S-k404/pi5-homelab-rack/01_PRINT_FILES/ONLYSCREWS_HARDWARE_CART.md

# OnlyScrews Hardware Cart: 100% Verified Fasteners & Inserts (1 Nov 2026)

All fasteners and brass heat-set inserts required for the **Pi 5 HomeLab 9U Mini Rack** (both Standard 200 mm and Slim Cargo 140 mm builds), sourced from **[OnlyScrews.in](https://onlyscrews.in/)**.

Buying these directly from OnlyScrews fulfills 100% of the hardware requirement for **₹630**, solving the out-of-stock and mixed-pack issues from Robu (saving ~₹2,300+ vs Robu's oversized bulk packs).

---

## 🛒 1-Click Shopify Cart Link

Click this link in your browser to preload all 8 items directly into your OnlyScrews cart:
🔗 **[Load OnlyScrews Cart Automatically](https://onlyscrews.in/cart/49423426126137:50,51684594909497:25,48622988099897:50,48883899105593:20,48591239774521:20,48591235580217:10,48623052194105:10,49979817394489:10)**

---

## 📋 Itemized Procurement Manifest

| # | Item Name | Product Page Link | Variant ID | Unit Price | Req. | Buy Qty | Total Price | Application in Rack |
|---|---|---|:---:|:---:|:---:|:---:|:---:|---|
| **1** | **M5 × 8 mm Brass Threaded Inserts** (Dia. 5mm, Length 8mm, OD 6.4mm) | [View Product](https://onlyscrews.in/products/m5-x-8mm-brass-threaded-inserts) | `49423426126137` | ₹2.80 | 48 | **50** | **₹140.00** | Frame module joints (18), 1U top ribs (4), cap handle bosses (4), base bars (6), front rail equipment holes (16). |
| **2** | **M3 × 6 mm Brass Threaded Inserts** (Dia. 3mm, Length 6mm, OD 4.0–4.4mm) | [View Product](https://onlyscrews.in/products/m3-x-6mm-3d-printing-brass-threaded-inserts-dia-3mm-length-6mm) | `51684594909497` | ₹4.80 | 18 | **25** | **₹120.00** | B1 dock ears (4), 7" screen ears (4) & corner clips (4), Pi shelf front posts (6). |
| **3** | **M5 × 12 mm Hex Button Head Screws** (ISO 7380, SS 304) | [View Product](https://onlyscrews.in/products/hex-allen-button-head-m5-x-12-screw-pack-of-20) | `48622988099897` | ₹3.40 | 48 | **50** | **₹170.00** | 18 frame joints, 6 base tie rods, 4 top cap, 4 luggage handles, 16 unit ear mounts. |
| **4** | **M5 Plain Flat Washers** (DIN 125, SS 304) | [View Product](https://onlyscrews.in/products/m5-washer-ss304) | `48883899105593` | ₹1.20 | 16 | **20** | **₹24.00** | Under the 16 unit ear mounting screws to protect 3D prints from crushing. |
| **5** | **M3 × 8 mm Countersunk Screws** (DIN 7991, SS 304) | [View Product](https://onlyscrews.in/products/hex-allen-csk-m3-x-8-screw-pack-of-20) | `48591239774521` | ₹1.40 | 14 | **20** | **₹28.00** | 4 B1 dock ears, 4 screen ears, 6 Pi faceplate. (*Out of stock on Robu; flush mount mandatory*). |
| **6** | **M3 × 12 mm Countersunk Screws** (DIN 7991, SS 304) | [View Product](https://onlyscrews.in/products/hex-allen-csk-m3-x-10-screw-pack-of-20) | `48591235580217` | ₹1.80 | 3 | **10** | **₹18.00** | Poly+ 5 tray to UPS tray (self-threads into 2.5 mm pilot holes). |
| **7** | **M3 × 8 mm Hex Button Head Screws** (ISO 7380, SS 304) | [View Product](https://onlyscrews.in/products/hex-allen-button-head-m3-x-8-screw-pack-of-20) | `48623052194105` | ₹2.00 | 4 | **10** | **₹20.00** | Clamps 4 corner retention clips onto Waveshare 7" screen tabs. |
| **8** | **M2.5 × 25 mm Hex Socket Head Screws** (High Tensile 12.9 Black) | [View Product](https://onlyscrews.in/products/m2-5-x-25mm-hex-allen-socket-head-high-tensile12-9-black-oxide-screw-dia-2-5mm-length-25mm) | `49979817394489` | ₹11.00 | 4 | **10** | **₹110.00** | Waveshare Adapter (F) holder lid + board onto posts (conditional on fit test). |

**Total OnlyScrews Hardware Cost:** **₹630.00** (incl. all spares).

---

### Optional Addition (If building the 1U 0.91" OLED display mod instead of UCG-Ultra):
* **M2 × 8 mm Socket Head Screws (SS 304)**: [View Product](https://onlyscrews.in/products/m2-x-8mm-hex-allen-socket-head-ss-304-screw-dia-2mm-length-8mm) (`₹2.60` each, buy 10 pcs = ₹26.00). Used to fasten the rear OLED retention clamp to the printed faceplate.
