S-k404/pi5-homelab-rack/ULTRAREVIEW/before/01_PRINT_FILES/ROBU_HARDWARE_CART_TO_RESTORE.md

# Robu hardware cart: to re-add after the print order is checked out (27 Oct 2026)

The Robu cart was cleared so the 3D-printing-service jobs could go in (Robu won't mix print jobs with regular items). Re-add this list once the print order has been checked out.

Prices are Robu's, incl. GST, as of 27 Oct 2026. Search on robu.in with the text in the "Search" column.

| Qty | Item | Unit ₹ | Search |
|---|---|---|---|
| 2 | Sunlu APLA (AntiString PLA) Grey 1.75mm Filament, 1 kg | 899 | `sunlu apla grey 1.75mm` |
| 1 | Pro-Range Hyper PETG Filament 1.75 mm 1kg Spool, Grey | 1,068 | `pro-range hyper petg grey` |
| 1 | Brass Heat Set Insert Nut Hot Melt Knurled Threaded M5-M6 90PCS (not the "Kit" one) | 959 | `brass heat set insert m5-m6 90pcs` |
| 3 | EasyMech M5x12mm HT Socket Button Head Cap Allen Bolt (25Pcs) | 167 | `easymech m5x12mm ht socket button head` |
| 1 | EasyMech M5 MS Plain Washer (100Pcs) | 89 | `easymech m5 ms plain washer 100pcs` |
| 1 | EasyMech M3x8mm HT Socket Button Head Cap Allen Bolt (25Pcs) | 239 | `easymech m3x8mm ht socket button head` |
| 1 | Brass Heat Set Insert Nut M2-M2.5-M3 500PCS (check insert length: need ~5-6 mm for a Ø4 hole) | 1,129 | `brass heat set insert m2 m2.5 m3 500pcs` |
| 1 | Standard 12V 5A 60W Power Supply with 5.5mm DC Plug (confirm 2.1 mm pin + centre-positive) | 425 | `standard 12v 5a 60w power supply 5.5mm dc plug` |
| 1 | USB-A to Micro USB-B Cable 100cm Fast Data/Charge | 59 | `usb-a to micro usb-b cable 100cm` |
| 1 | SanDisk Ultra GO micro SDHC 32GB UHS-I | 1,629 | `sandisk ultra go micro sdhc 32gb` |
| 1 | Waveshare 7inch 1024x600 HDMI, IPS, Low Power Capacitive LCD (C) Touch Screen (not the "with Bicolor Case" one) | 4,389 | `waveshare 7inch hdmi lcd c` |
| 1 | Cuzor Mini UPS Pro 12V3A (3x2900 mAh); went missing from the cart on its own, re-add | 2,199 | `cuzor mini ups` |
| 1 | Nylon Cable Zip Ties 150mm White (Pack of 100); went missing from the cart on its own, re-add | 80 | `nylon cable zip ties 150mm` |

Total of the 13 lines above: ₹15,083. (Was 14 lines / ₹15,942 before the Argon Poly+ 5: the Armor Lite V5 was dropped because the THRML heatsink/fan is inside the Poly+ 5.)

## Added for the Argon Poly+ 5 (27 Oct): not yet in any cart
- **12 V → 5 V, 5 A USB-C step-down converter** (UPS 12 V OUT → pigtail → converter → Pi USB-C). Not confirmed on Robu. Leads: "24V/12V to 5V 5A Power Module DC-DC XY-3606" (₹139) and "DC-DC Step-Down Buck Converter 24V 12V 9V to 5V 5A 25W" (₹199); neither listing says it has a USB-C output, so check before buying.
- **4 × M2.5 × 25 mm pan-head screws** for the Waveshare adapter (F) holder (its base and lid are in the print cart). Not searched on Robu yet; look for an M2.5 × 25 kit or pack, and check it has pan/button heads (not countersunk). The holder's pilot holes are 2.1 mm, so the screws cut their own thread.
- **UGREEN 20134 micro-HDMI extender**: Amazon only; now required (it was optional).
- The microSD (above) is now the boot drive: the adapter (F) can't be used inside the Argon case, so there is no NVMe.

## Not included on purpose
- Official Raspberry Pi 5 Active Cooler (₹519) and 52Pi Armor Lite V5 (₹859): neither is needed now, because the user bought the Argon Poly+ 5 with the THRML heatsink/fan inside.
- If Robu prints every part, the 2 PLA + 1 PETG spools aren't needed.

## Not on Robu (not in any cart)
UCG-Ultra (Amazon B0D8PSW2BZ), 0.5 m Cat6 patch cable, M3 x 8 countersunk screws (all out of stock), Pi-unit extras (M3x12 CSK x3, M2.5x8 x4, M2.5x10 x4), rubber feet, 1 mm foam tape, felt sheet, 0.5 m USB-C cable for the B1, 2230 NVMe SSD.
