S-k404/pi5-homelab-rack/START_HERE.md

# Pi 5 HomeLab: start here (28 Oct 2026)

**The to-do list is now `FINAL_TODO/FINAL_TODO.md`**: orders, what to measure when things arrive, printing, building, every cable, first power-up. It replaces the list that was here, so there's only one list to keep up to date. The old one is in `ULTRAREVIEW/before/START_HERE.md`.

| What | Where |
|---|---|
| To-do list | `FINAL_TODO/FINAL_TODO.md` |
| Print / order list | `01_PRINT_FILES/README.md` (print only from `01_PRINT_FILES/`) |
| Buy list with prices | `PARTS_LIST.md` |
| Folder map and the build | `README.md` |
| What the 28 Oct review found and changed | `ULTRAREVIEW/README.md` |

The build:
- the 9U rack
- B1 dock v5
- the 7" screen module
- the Pi 5 in the **Argon Poly+ 5** with the adapter (F) holder (fit test first)
- the **12-ALT2** UCG-Ultra mount
- the 12 V brick cradle (plate 13)
- the **clean** faceplate (no DC-IN window, no notch: the brick's lead stays behind it)

Everything older (including the broken "hidden-slit / switch" faceplate) is in `_Old_versions/`.
