S-k404/pi5-homelab-rack/05_PLATES_250x250_BED/Plate05_SETTINGS.txt

======================================================================
Plate05: Pi Rack Shelf & EP52 UPS Sled (2 Parts)
Bed: 250 x 250 x 250 mm | Material: PETG - Black
Infill & Walls: Shelf: 4w 20% · UPS: 3w 20%
Parts on Bed: 2 pieces (100% verified inside bed margins)
======================================================================

DEBOSSED INTERIOR ONE-WORD PART IDENTIFIERS:
  - Molded Label: SHELF
  - Molded Label: UPS

QUICK-BREAK TREE SUPPORT RECIPE:
  Minimal Tree (0.22 mm Z) on shelf right-post cable notch.

SLICER CONFIGURATION:
  - Layer Height: 0.20 mm Standard
  - Support Type: Tree (auto) / Tree Slim
  - Top Z-Distance: 0.22 mm (Clean manual release)
  - Top Interface: 2 dense layers @ 0.8 mm spacing
  - Overhang Threshold: 55°
  - XY Separation: 0.60 mm
