S-k404/pi5-homelab-rack/05_PLATES_250x250_BED/Plate07_SETTINGS.txt

======================================================================
Plate07: Pi 2U Clean Faceplate (45° Diagonal Flat)
Bed: 250 x 250 x 250 mm | Material: PETG - Black
Infill & Walls: 4 walls · 20% Gyroid infill
Parts on Bed: 1 pieces (100% verified inside bed margins)
======================================================================

DEBOSSED INTERIOR ONE-WORD PART IDENTIFIERS:
  - Molded Label: FACEPLATE

QUICK-BREAK TREE SUPPORT RECIPE:
  Supports OFF (Face-Down on PEI Bed for Molded Finish)

SLICER CONFIGURATION:
  - Layer Height: 0.20 mm Standard
  - Support Type: Tree (auto) / Tree Slim
  - Top Z-Distance: 0.22 mm (Clean manual release)
  - Top Interface: 2 dense layers @ 0.8 mm spacing
  - Overhang Threshold: 55°
  - XY Separation: 0.60 mm
