S-k404/pi5-homelab-rack/05_PLATES_250x250_BED/Plate10_SETTINGS.txt

======================================================================
Plate10: 3U Unit Rack Mount Ears (4 Parts)
Bed: 250 x 250 x 250 mm | Material: PLA - Silver
Infill & Walls: 4 walls · 20% Gyroid infill
Parts on Bed: 4 pieces (100% verified inside bed margins)
======================================================================

DEBOSSED INTERIOR ONE-WORD PART IDENTIFIERS:
  - Molded Label: EAR (1/4)
  - Molded Label: EAR (2/4)
  - Molded Label: EAR (3/4)
  - Molded Label: EAR (4/4)

QUICK-BREAK TREE SUPPORT RECIPE:
  Supports OFF (Zero Supports · 100% Flat Geometry)

SLICER CONFIGURATION:
  - Layer Height: 0.20 mm Standard
  - Support Type: Tree (auto) / Tree Slim
  - Top Z-Distance: 0.20 mm
  - Top Interface: 2 dense layers @ 0.8 mm spacing
  - Overhang Threshold: 55°
  - XY Separation: 0.50 mm
