S-k404/pi5-homelab-rack/06_WALL_FRAME_Waveshare_F/checks/CLEARANCE_SCHEMATIC.pdf

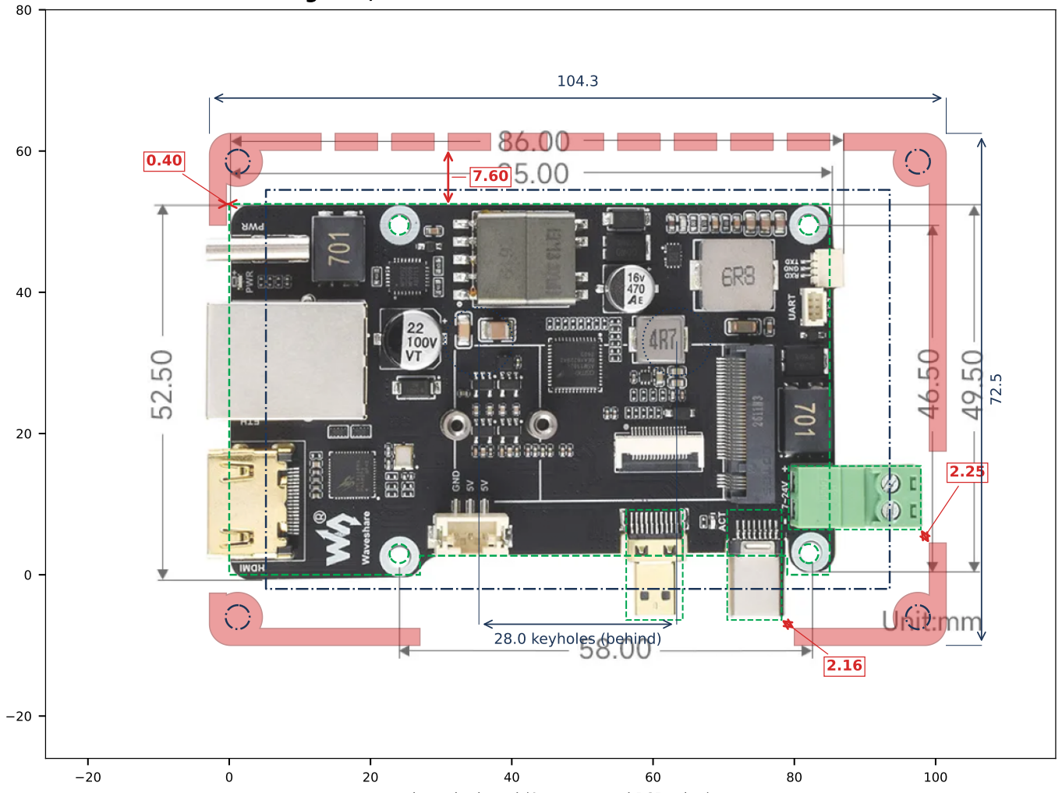
[picture p13: figure]
28.0 keyholes (behind)

x along the board (0 = ports-end PCB edge) y up the wall (0 = plug edge)

A Front: frame cut at z 14.1 (red) over Waveshare's drawing; model board dashed green, front window dash-dot

−40 | −20 | 0 | 20 | 40 | 60 | 80 | 100

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
z out of the wall (0 = wall)

1.50

2.00

14.10

1.03

B Section y = 30.2: RJ45, left keyhole boss

−40 | −20 | 0 | 20 | 40 | 60 | 80 | 100 | 120

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
z out of the wall

2.86
4.41
| | 3.00
| 3.00

8.50

C Section y = 10.9: HDMI jack, 7-24 V terminal

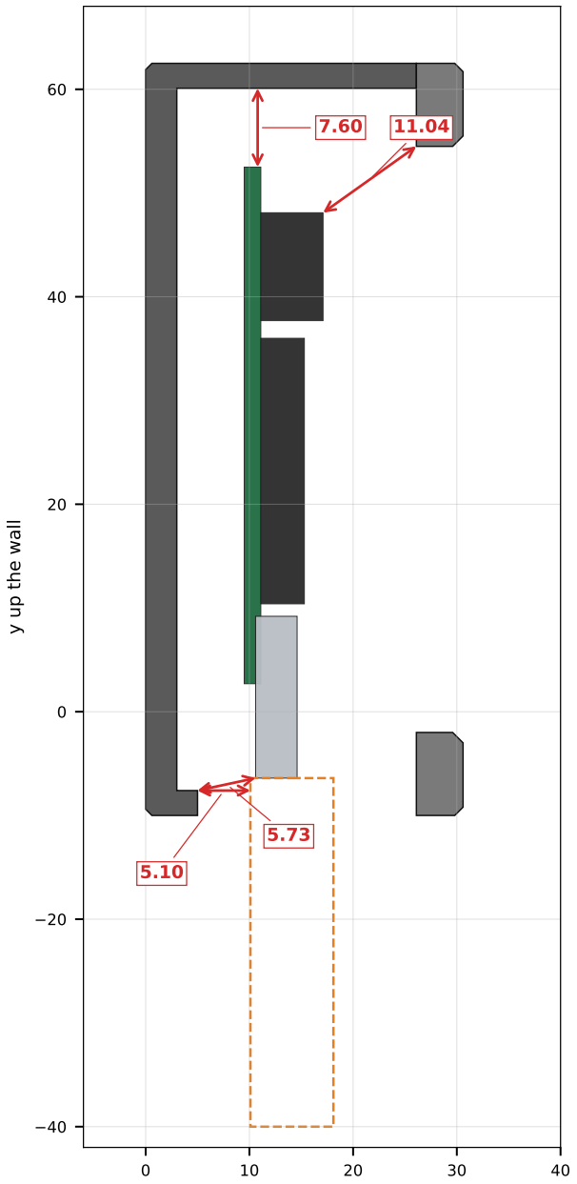
[picture p14: figure]
y up the wall

z out of the wall (0 = wall)

D Section x = 74.35: USB-C plug, bottom slot, top wall

E Section x = 35.4: left keyhole, wall screw head 3 mm out

F Section x = 97.5: right-hand front screws, terminal

Waveshare Pi5 Connector Adapter (F) wall frame: clearances measured on the delivered STEP files (mm; red = gap, orange dashed = cable plug / lead space, blue = screws, hatched = estimated pin tails)

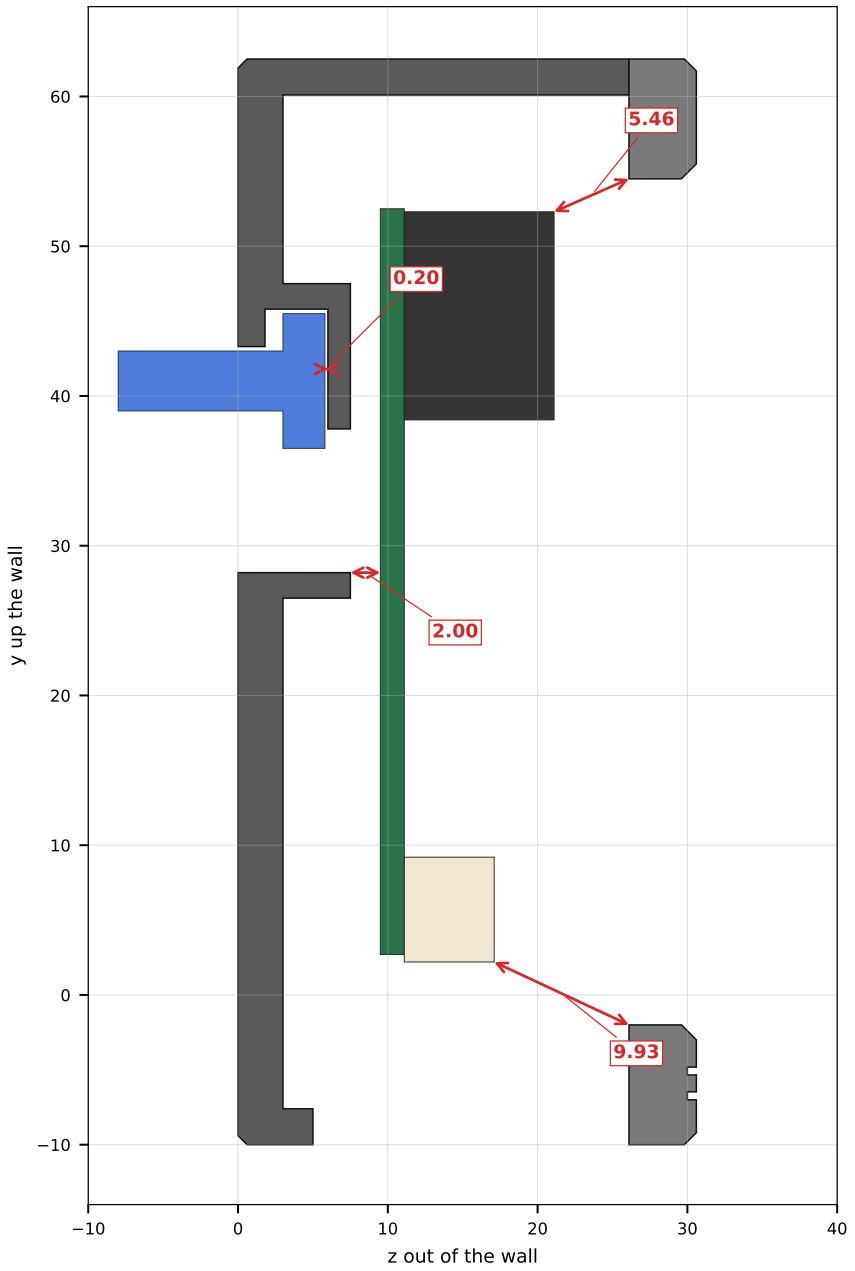
[picture p15: figure]
z out of the wall; y up the wall
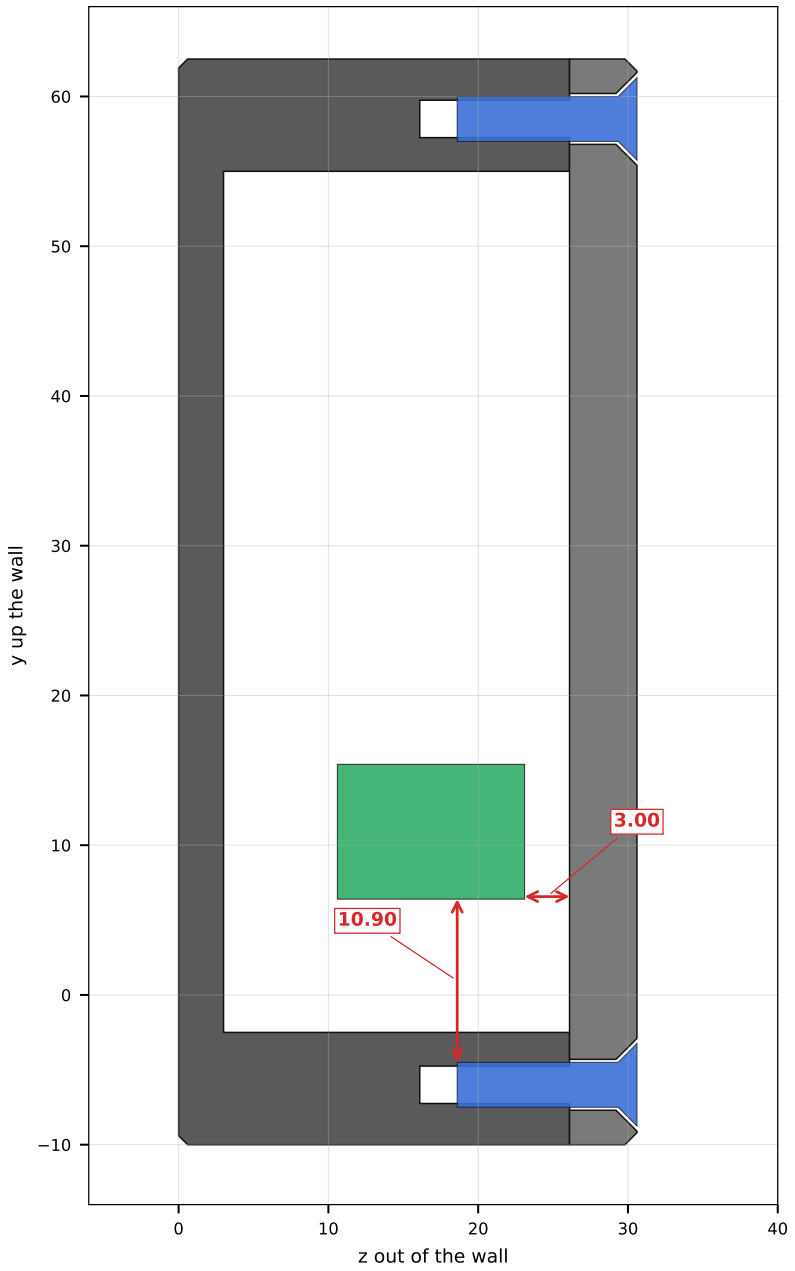
[picture p16: figure]
z out of the wall; y up the wall

Sections are cut through the delivered STEP files (read back from disk) and the adapter model; red arrows measure within each section, the table gives the 3D minimum. Board positions from Waveshare's drawing (+-0.3 mm); parts marked est. have estimated heights. Full numbers: CLEARANCES_from_STEP.txt.
