S-k404/pi5-homelab-rack/_Old_versions/README.md

# Old versions: don't print from these

These are kept for reference only. The current design is `../Pi5-MiniRack_v7.2_ALL-FILES_2026-10-27/`.

| Folder | What it is |
|---|---|
| `v7.1_2026-10-27/` | The 8U v7.1 bundle and zip (no UCG-Ultra shelf). Its BOM still lists the Mean Well LRS-150-12. |
| `v7.0_2026-10-27/` | The v7.0 bundle and zip. Its screen module doesn't fit the C-type screen, and its rack is heavier than v7.1's. |
| `Display7C_3U_screen-module_2026-10-27/` | The C-type screen module on its own. The same module is `3_Display_7in_3U/` in v7.1 and v7.2; this copy's rack check is the v7.0 run. |
| `2026-10-26_and_earlier/` | The v6 rack, the 26 Oct all-files zip, the first REES52 screen and B1 dock zips, the 26 Oct BOM, and the old START_HERE notes. |

- `FINAL_PRINT_STLs_ONLY_antigravity_2026-10-28_DO-NOT-PRINT/` (moved 28 Oct): the Antigravity "v7.3" STL list. Wrong build and a broken faceplate; see its `00_DO_NOT_PRINT_README.txt`. The print list is `../FINAL_PRINTS_2026-10-28/`.

## `2026-10-28_retired/` (moved here 28 Oct 2026, when the top level was reorganised)
The current files are now in the project root: `01_PRINT_FILES/`, `02_RENDERS/`, `03_CHECKS/`, `04_DESIGN_SOURCE/`. **Don't print from anything below.**
| Folder / file | What it was |
|---|---|
| `PRINT_THIS/` | The 27 Oct per-plate print folder, with its alternatives, the plate 13 source and checks, the Robu notes and the handoff. The broken Antigravity faceplate and switch extender are in its `_superseded_and_alternatives/BROKEN_…/` |
| `FINAL_PRINTS_2026-10-28_replaced-by-01_PRINT_FILES/` | The first final folder of 28 Oct, before the holder and UPS-check split |
| `antigravity_finalisation/` | The "Antigravity v7.3" bundle: CAD copies, its renders, docs and BOM. Its faceplate / switch extender / "hidden slit" don't work |
| `FINAL_PRINT_STLs_ONLY_antigravity_DO-NOT-PRINT/`, `…first-copy…/` | Antigravity's STL lists (broken faceplate, plate 12, shims) |
| `Pi 5 Mini Rack Renders_antigravity_WRONG-faceplate/` | Antigravity's renders (switch-window faceplate, UPS moved 29.9 mm forward) |
| `BOM_Pi5-MiniRack_FINAL_antigravity_wrong-Poly5-price.xlsx` | Antigravity's BOM (Poly+ 5 at ₹859, tray height wrong, no totals). The corrected buy list is `../../PARTS_LIST.md` |
