S-k404/pi5-homelab-rack/_Old_versions/rework-01/_Old_versions/v7.0_2026-10-27/Pi5-MiniRack_v7_ALL-FILES_2026-10-27/1_Rack_8U_T0-look/README.md

# Printable 10-inch 8U Mini Rack — RackMate T0 look (v7)

This rack copies the **DeskPi RackMate T0** that Jeff Geerling used for **Mini Rack 001 and 002**:
- a 280 × 200 mm footprint
- solid silver side walls, with the rails built into the front and rear posts
- a top cap with a punched-style vent grid
- two U handles, front to back, with a round eye in each leg
- feet at the four corners

It's 8U tall, like DeskPi's RackMate T1, so it holds all three of your units. From bottom to top: the **Pi unit (2U)**, the **B1 face-out dock (3U)** and the **7" screen (3U)**.

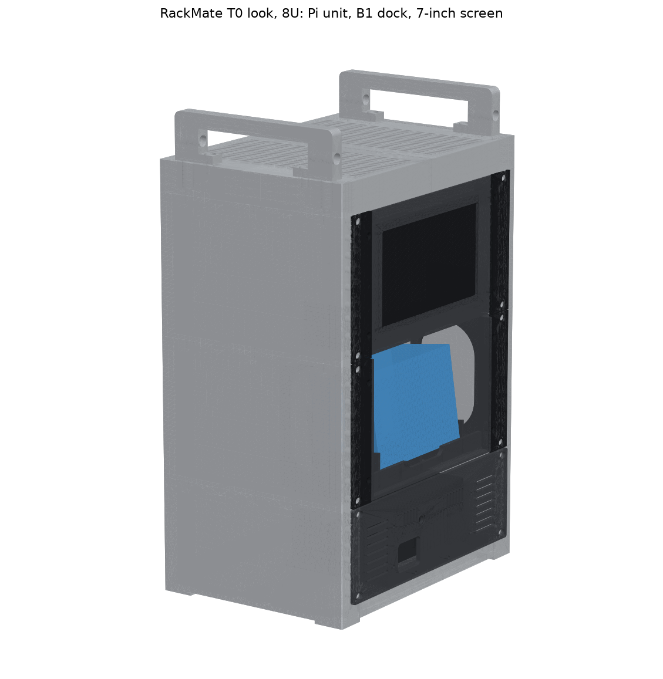
[picture p19: _Old_versions/v7.0_2026-10-27/Pi5-MiniRack_v7_ALL-FILES_2026-10-27/1_Rack_8U_T0-look/images/rack_loaded.png]
Loaded

Front
Empty

**Size:** 280 W × 200 D mm. It's 406 mm tall to the top of the cap and 451 mm to the handle tops.
**Rails:** 10-inch standard: holes 236.525 mm apart, 224 mm clear between the posts, 24 EIA holes per post. There are rails at the front and the rear, so a 10" PDU fits at the back as in Mini Rack 002.

## What changed from v6 (and why)
| v6 problem | v7 |
|---|---|
| It tipped back with ~6 N on the B1 button. The check script used a pivot that doesn't touch the desk. | It stands on four corner feet 200 mm apart (front to back). It now takes **~18 N** at the B1 button or **~11 N** at the screen to tip it. |
| It was 129 mm deep, a slim tower. | 200 mm deep, like the T0. Commercial 10" gear such as switches fits too. |
| There was nowhere to stick the rubber feet: the base was a 3 mm web. | Each corner has a 28 × 30 mm foot pad. |
| 28 printed parts including 1.4 mm stick-on panels, 68 heat-set inserts, countersunk screws. | 13 printed parts, 38 M5 inserts and **one screw size** (M5 × 12 button head). The walls are part of the side modules. |
| The Pi shelf's rubber feet clashed with the base bars. | The shelf sits on two base bars, and its feet (optional) hang clear in the plinth. |

## How it's built
- **Side modules:** each one is a single print. It has the 1.6 mm wall, the front and rear posts with the rails, and a rib along the top and bottom. Each side stacks one 2U base and two 3U modules. The 3U middle and 3U top are the same part.
  - At each joint, three M5 screws go down through the upper module's bottom rib into inserts in the lower module's top rib.
  - Two keys drop into pockets so the walls line up flush.
- **Base:** the 2U base modules carry on 20 mm below the rack space down to the desk. They have the corner foot pads and ledges for three base bars.
  - The bars (front, middle and rear) tie the two sides together.
  - The Pi unit's shelf rests on the front and middle bars.
  - Each bar has two screws, fitted from below.
- **Cap:** two halves locked together at the centre by dovetails. It sits on the top modules, with two screws per side going down through the corner columns.
- **Handles:** each foot tab takes one screw into an insert in a cap column.
- **Left and right:** every part is front/rear symmetric. The left-hand part is the right-hand one turned 180°, so you print one STL per part type.

Exploded

## Print list
PETG (silver or grey for the T0 look), 0.2 mm layers, **no supports**. The STLs are already laid out on the bed. Everything fits a 220 × 220 mm bed.

| File (`STL_for_printing/`) | Qty | On the bed (mm) | Settings | ≈ g each |
|---|---|---|---|---|
| `Rack_SideModule_2U_Base_x2.stl` | 2 | 200 × 109 × 40, outer face down | 3 walls, 15% | 106 |
| `Rack_SideModule_3U_x4.stl` | 4 | 200 × 136 × 28, outer face down | 3 walls, 15% | 120 |
| `Rack_CapHalf_x2.stl` | 2 | 148 × 200 × 30, vent grid down | 3 walls, 15% | 112 |
| `Rack_Handle_x2.stl` | 2 | 172 × 45 × 14, on its side | 4 walls, 30% | 41 |
| `Rack_BaseBar_x3.stl` | 3 | 224 long, laid diagonally | 3 walls, 25% | 25 |

**Rack total ≈ 1.07 kg** (slicer-like estimate from `source/estimate_filament.py`; your slicer gives exact numbers).

**Tips:**
- Print the side modules and the cap on a smooth or textured PEI sheet. Their outside faces print against the bed, which gives the clean T0 finish.
- For the T0's two-tone look, print the cap halves in black or dark grey.
- The outer front and rear edges have a 1 mm chamfer, so elephant's foot won't show.
- Print one 3U module first. Check that an M5 insert sets cleanly in a rail hole and in a joint boss.

## Hardware (rack)
| Item | Qty | Where |
|---|---|---|
| M5 heat-set inserts, Ø6.4 hole, 8–10 mm long | 38 (buy 50) | 12 joint bosses + 4 cap bosses (top ribs), 4 cap columns, 6 base-bar ends, 12 rail holes (Pi, dock, screen) |
| M5 × 12 button-head screws | 38 | 12 module joints, 4 cap, 6 base bars, 4 handles, 12 unit ears |
| M5 washers | 12 (buy 16) | under the unit-ear screws |
| Stick-on rubber feet, 10–15 mm | 4 | under the corner foot pads |

A 3 mm hex L-key reaches every screw. The joint screws sit inside the modules, and the handle screws sit under the grip.

## Assembly
1. **Inserts:** press them into:
   - the top-rib bosses of every module: 3 each in the 2U bases and the middle 3Us, 2 each (front and rear) in the top 3Us
   - the cap columns (2 per half)
   - both ends of each base bar (from below)
   - the rail holes you need: 4 per unit
2. **Sides:** for each side, stack the 2U base, a 3U and a 3U. Let the keys drop into the pockets, then fit 3 screws per joint down through the upper module's bottom rib.
3. **Base:** lay the rack on its back. Set the three bars on the ledges (front, middle and rear) and screw each end from below through the ledge.
4. **Cap:** lower one cap half onto the other so the dovetails lock. Set the cap on the top modules and fit 4 screws down through the corner columns.
5. **Handles:** 1 screw per foot tab, into the cap columns. These cover the cap screws.
6. **Feet:** stick the rubber feet under the four corner pads.
7. **Units:** rack them from the bottom up: Pi unit, B1 dock, screen. Each takes 4 M5 × 12 screws with washers.

## Check by hand
- **Cables:** the back is open. The Pi's ports are about 85 mm in from the rear rail plane. Run the screen's HDMI and USB up the back.
- **Heat:** the walls are closed. Air comes in under the base (the bottom is open, with a 20 mm plinth) and through the open back, and it leaves through the vent grid in the cap.
- **Label:** like Jeff's racks, print a "001" label on the B1 and stick it on the cap's front band.

## Checks
`VERIFICATION_rack.txt` has **34 PASS, 0 FAIL**. It covers:
- no collisions, using the real Pi unit loaded from its STEP files, plus the dock and the screen
- every screw line clear into its insert
- the keys engaging
- the EIA holes and the 10" standard
- unit slots on the inserts
- wall thickness around the inserts
- bed fit
- tipping
- carrying by one handle
- loads on the cap and base bars

These are calculations on the 3D models and hand calcs, not a physical test.

## Source
`source/` holds the CadQuery scripts (`pip install cadquery trimesh scipy pillow matplotlib`):
- `rack_t0.py`: all the rack parts. The dimensions are at the top.
- `export_rack.py <Pi STEP folder> <out folder>`: writes the STLs, STEPs and images. The Pi STEP folder is `../4_Pi_Unit_2U/STEP_for_Onshape`.
- `verify_rack_t0.py <Pi STEP folder> <STL folder>`: re-runs the checks.
- `estimate_filament.py <STL folder>`: grams per part.
