S-k404/pi5-homelab-rack/02_RENDERS/00_HOMELAB_RACK_ENGINEERING_SCHEMATIC.png

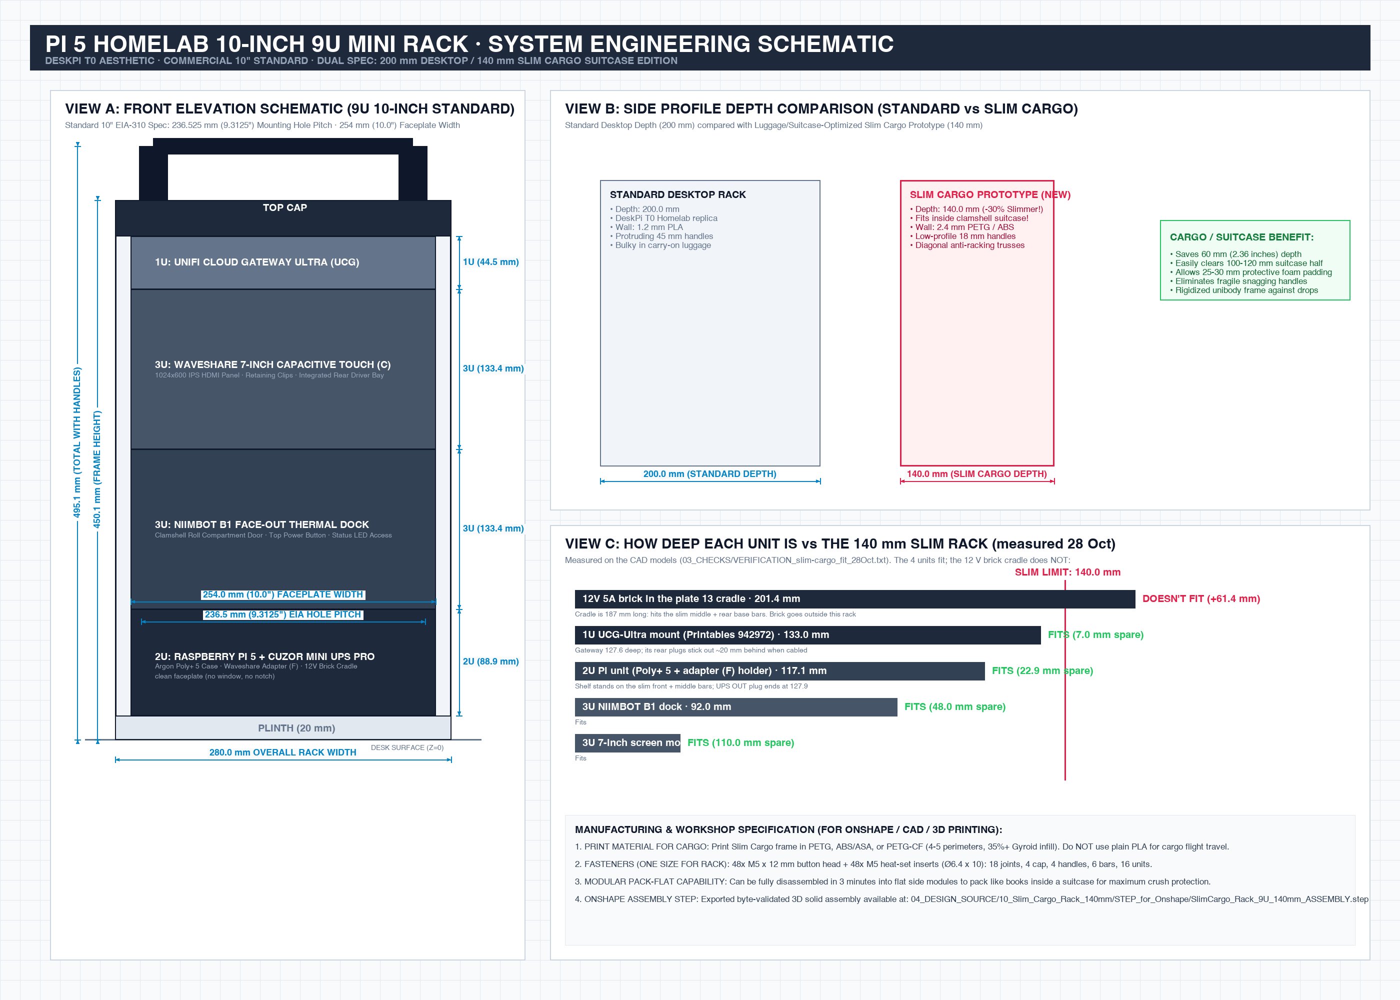
02_RENDERS/00_HOMELAB_RACK_ENGINEERING_SCHEMATIC.png
