S-k404/pi5-homelab-rack/02_RENDERS/01_rack_loaded_front.png

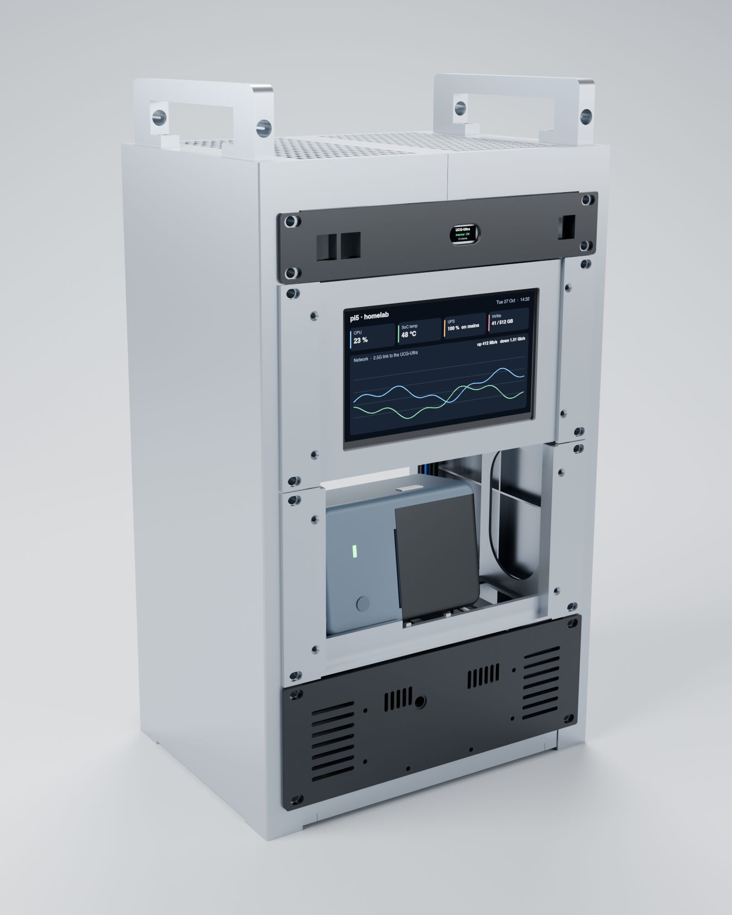
02_RENDERS/01_rack_loaded_front.png
