S-k404/pi5-homelab-rack/02_RENDERS/02_rack_loaded_back.png

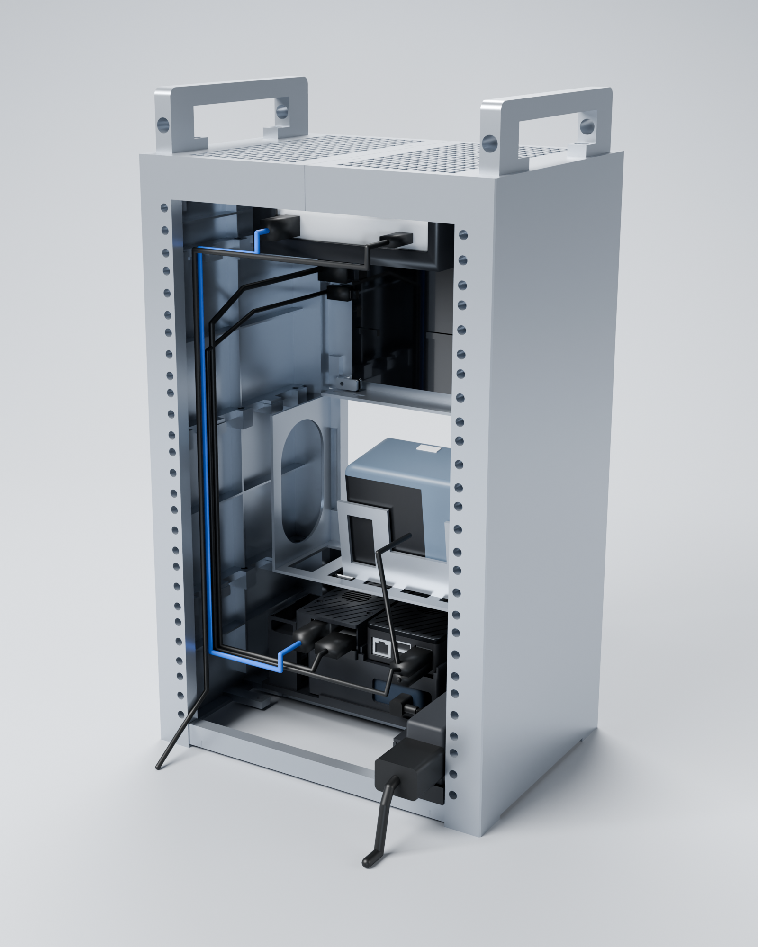
02_RENDERS/02_rack_loaded_back.png
