S-k404/pi5-homelab-rack/02_RENDERS/03_rack_front_straight.png

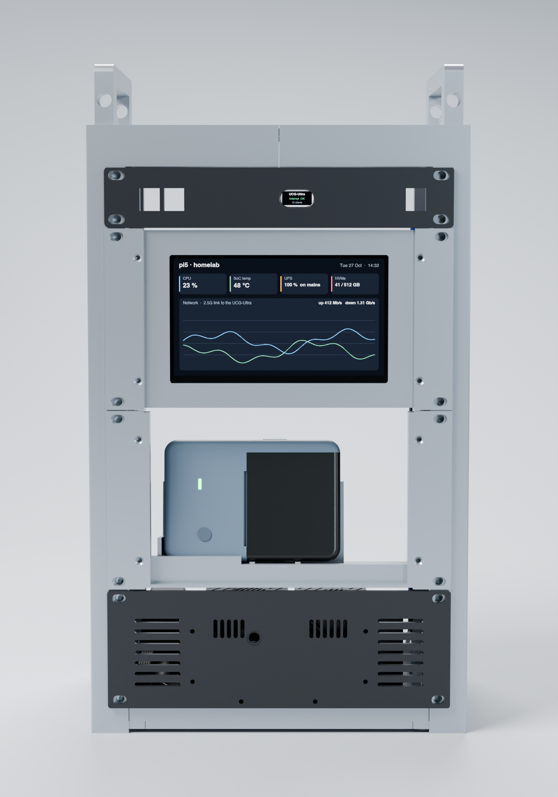
02_RENDERS/03_rack_front_straight.png
