S-k404/pi5-homelab-rack/02_RENDERS/04_rack_exploded.png

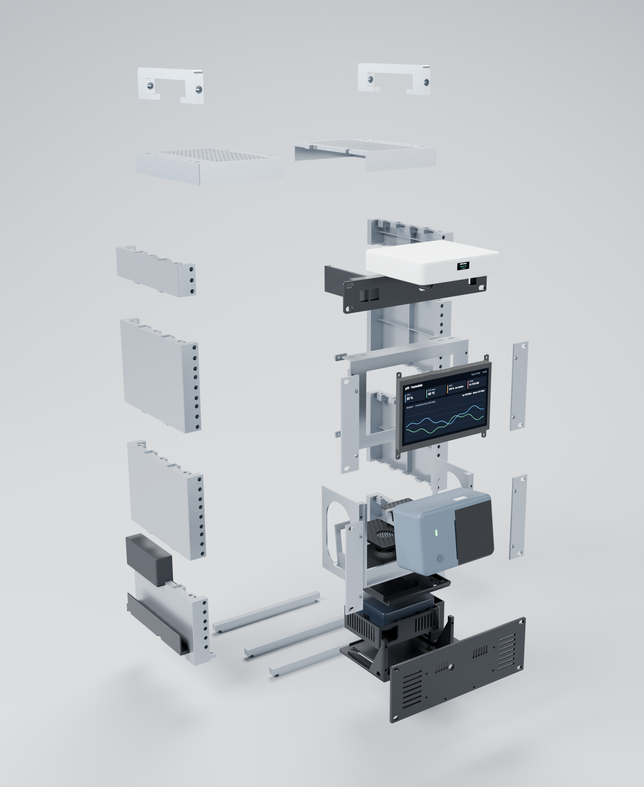
02_RENDERS/04_rack_exploded.png
