S-k404/pi5-homelab-rack/02_RENDERS/05_pi_unit.png

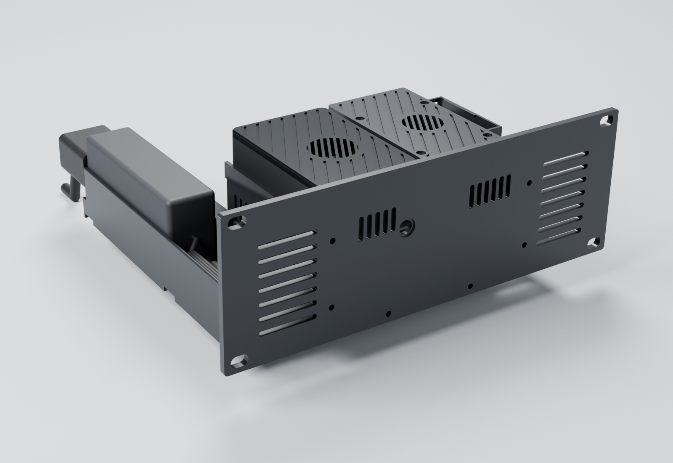
02_RENDERS/05_pi_unit.png
