S-k404/pi5-homelab-rack/02_RENDERS/06_pi_unit_back_ports.png

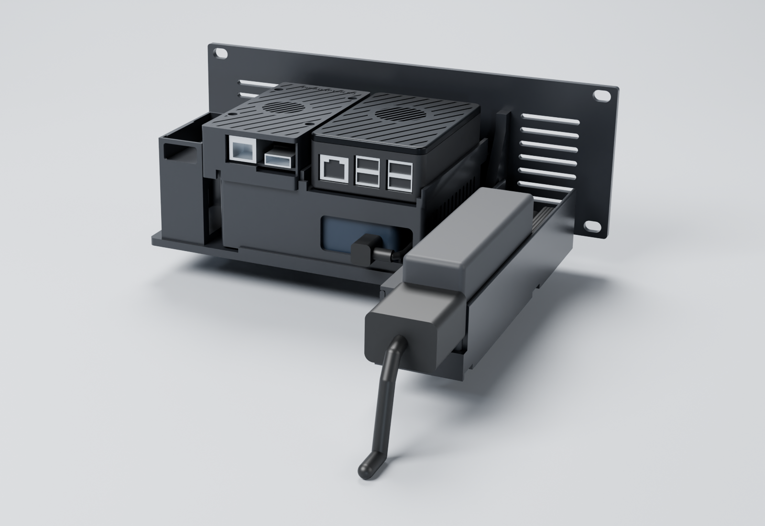
02_RENDERS/06_pi_unit_back_ports.png
