S-k404/pi5-homelab-rack/02_RENDERS/07_pi_unit_exploded.png

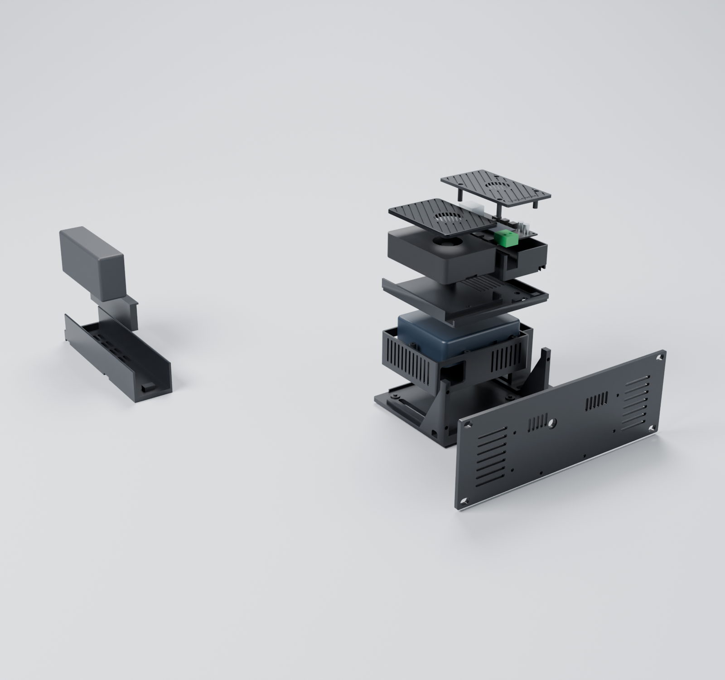
02_RENDERS/07_pi_unit_exploded.png
