S-k404/pi5-homelab-rack/02_RENDERS/08_pi_unit_faceplate_off.png

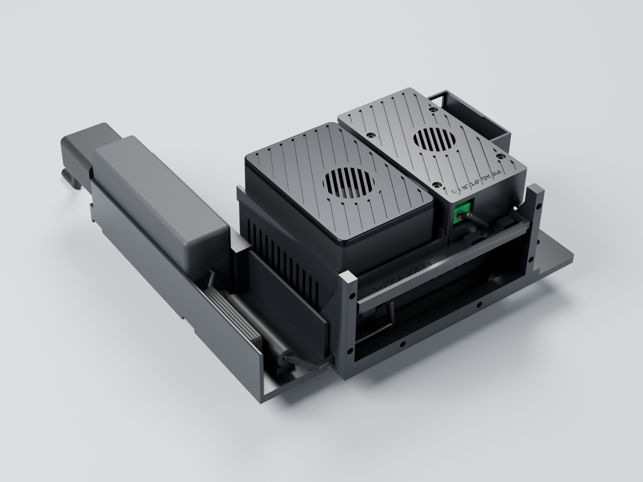
02_RENDERS/08_pi_unit_faceplate_off.png
