S-k404/pi5-homelab-rack/02_RENDERS/09_pi_unit_holder_open.png

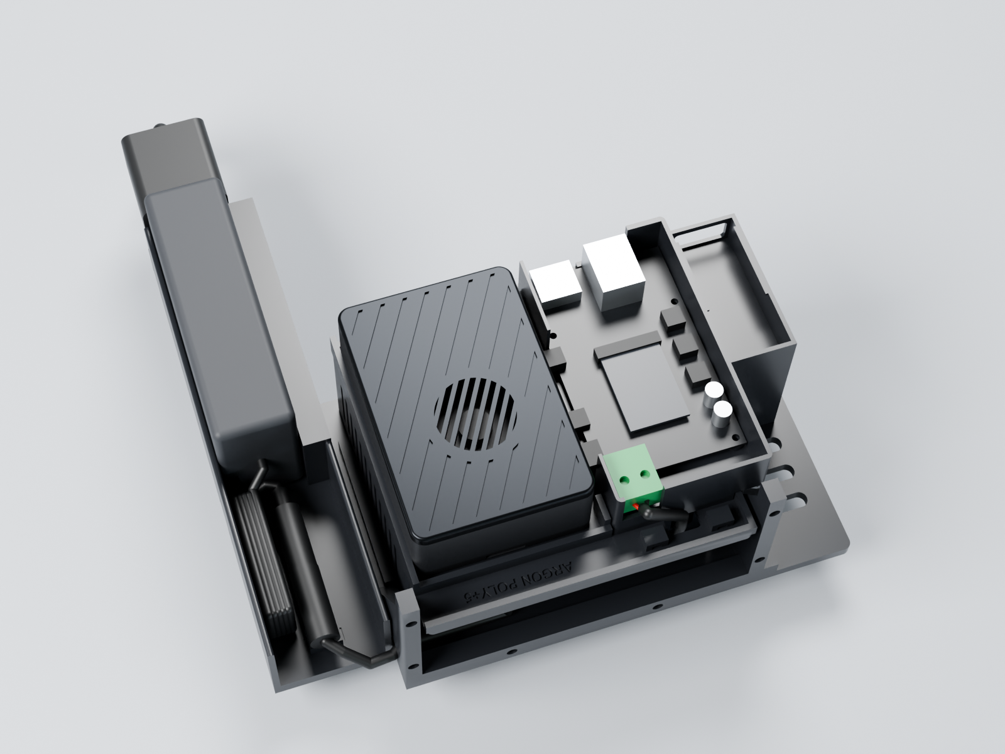
02_RENDERS/09_pi_unit_holder_open.png
