S-k404/pi5-homelab-rack/02_RENDERS/10_b1_dock.png

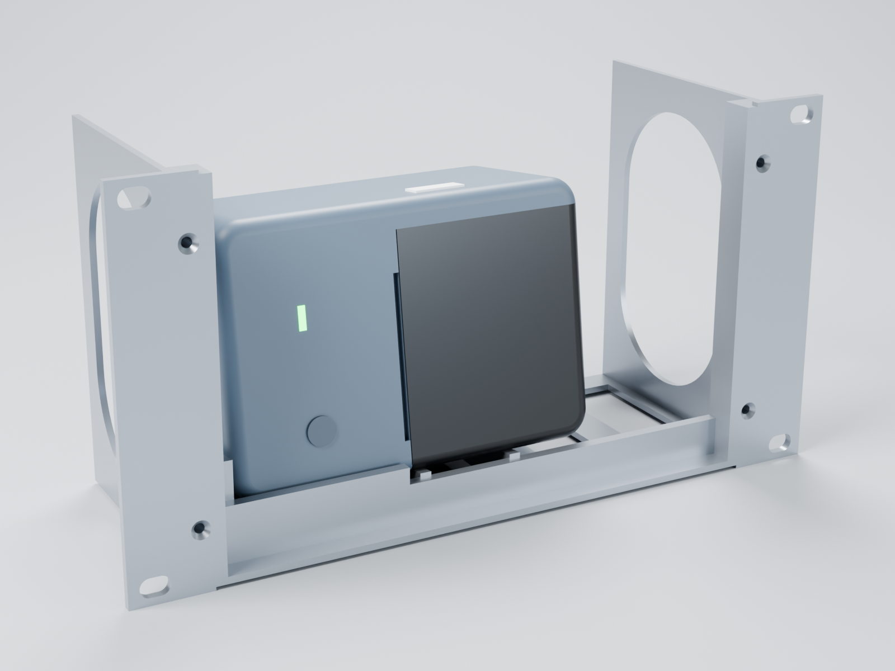
02_RENDERS/10_b1_dock.png
