S-k404/pi5-homelab-rack/02_RENDERS/11_b1_dock_lid_open.png

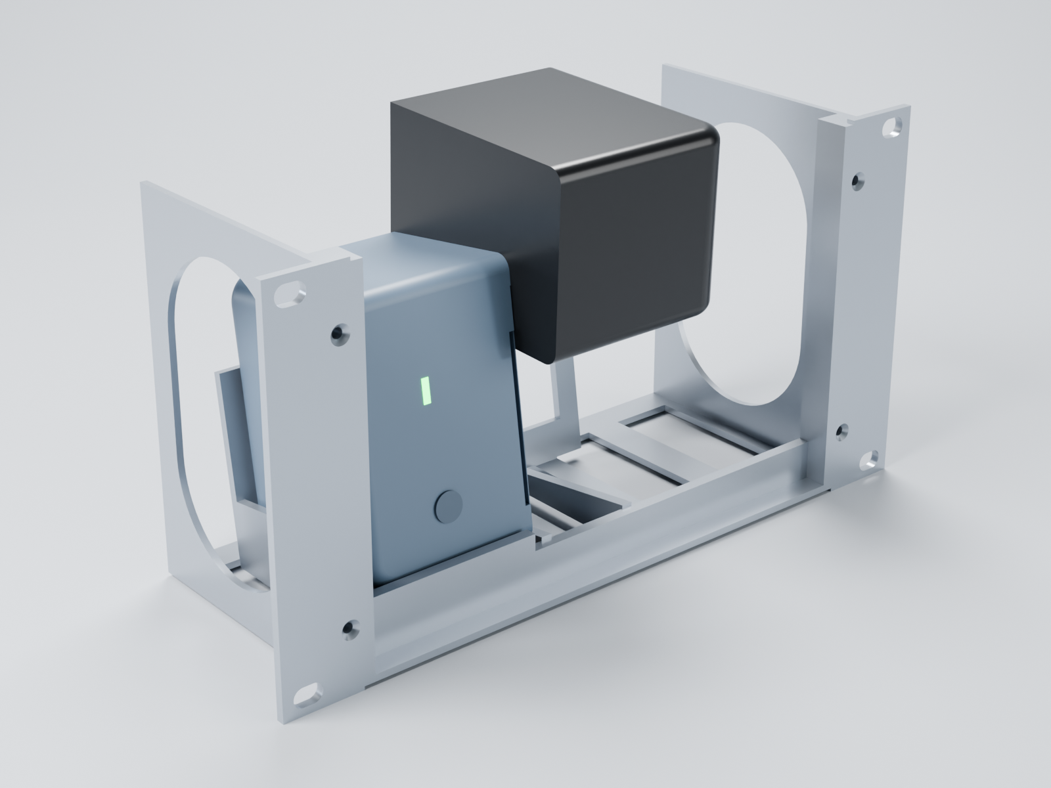
02_RENDERS/11_b1_dock_lid_open.png
