S-k404/pi5-homelab-rack/02_RENDERS/12_screen_module.png

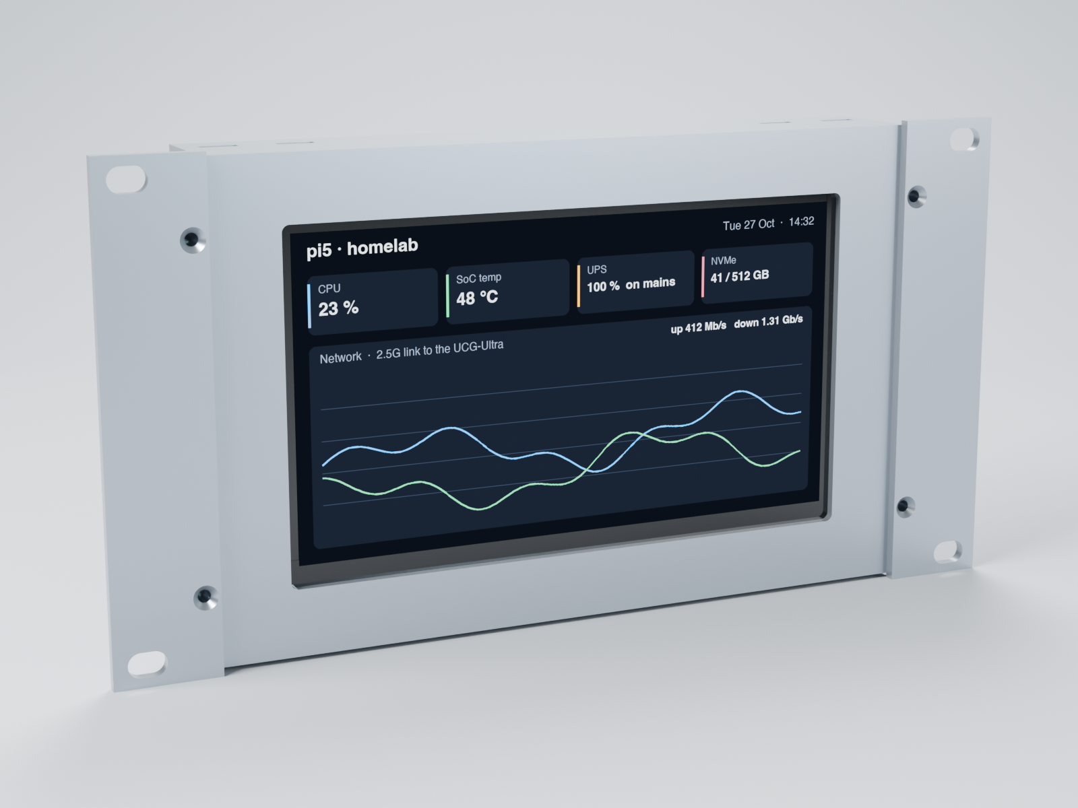
02_RENDERS/12_screen_module.png
