S-k404/pi5-homelab-rack/02_RENDERS/13_ucg_mount.png

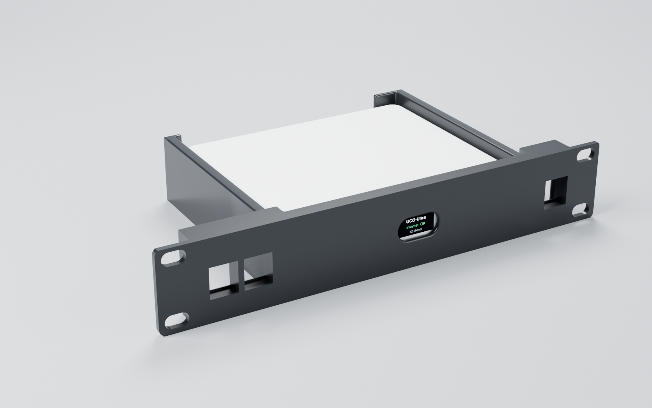
02_RENDERS/13_ucg_mount.png
