S-k404/pi5-homelab-rack/02_RENDERS/14_ucg_mount_back.png

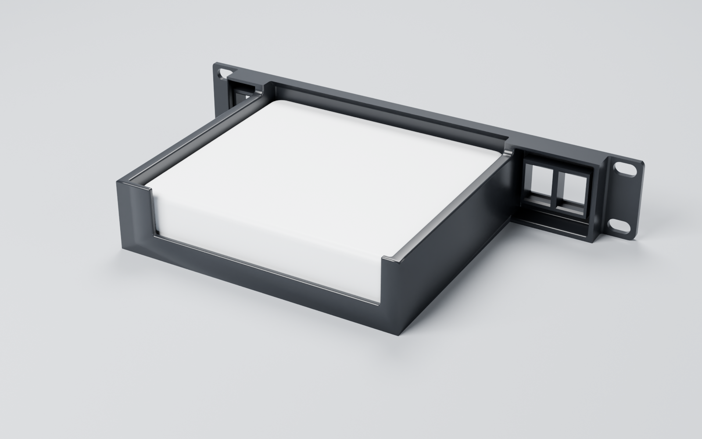
02_RENDERS/14_ucg_mount_back.png
