S-k404/pi5-homelab-rack/02_RENDERS/15_pi_power_rear_ups_out_plug.png

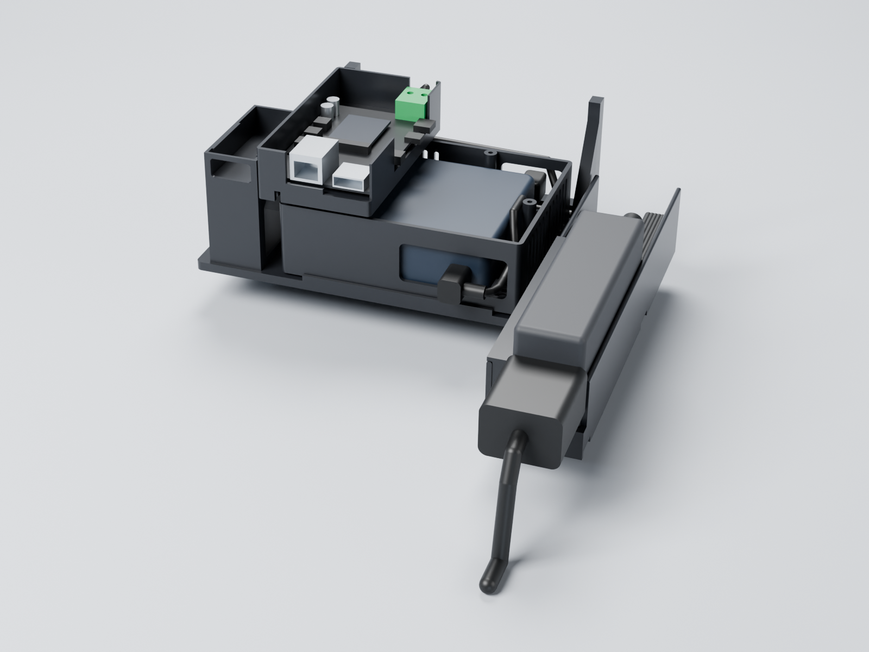
02_RENDERS/15_pi_power_rear_ups_out_plug.png
