S-k404/pi5-homelab-rack/02_RENDERS/16_pi_power_path_cutaway.png

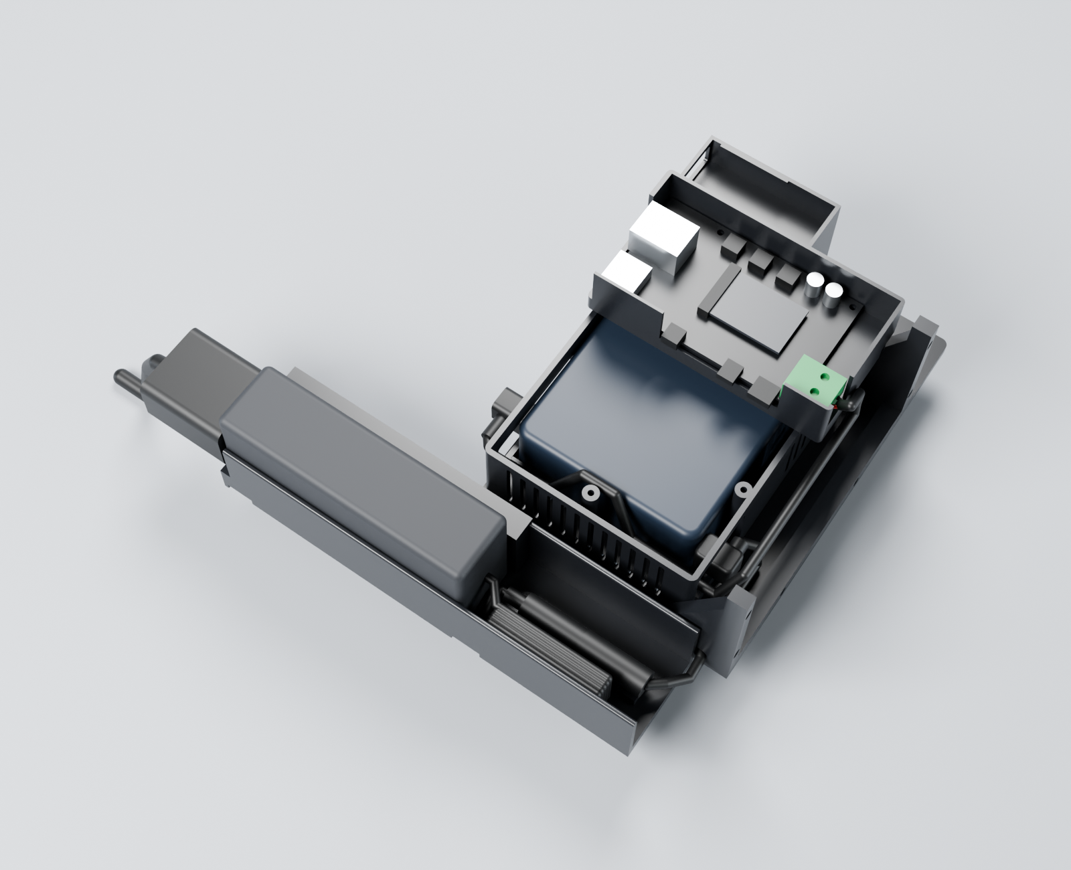
02_RENDERS/16_pi_power_path_cutaway.png
