S-k404/pi5-homelab-rack/02_RENDERS/FINAL_sheet.png

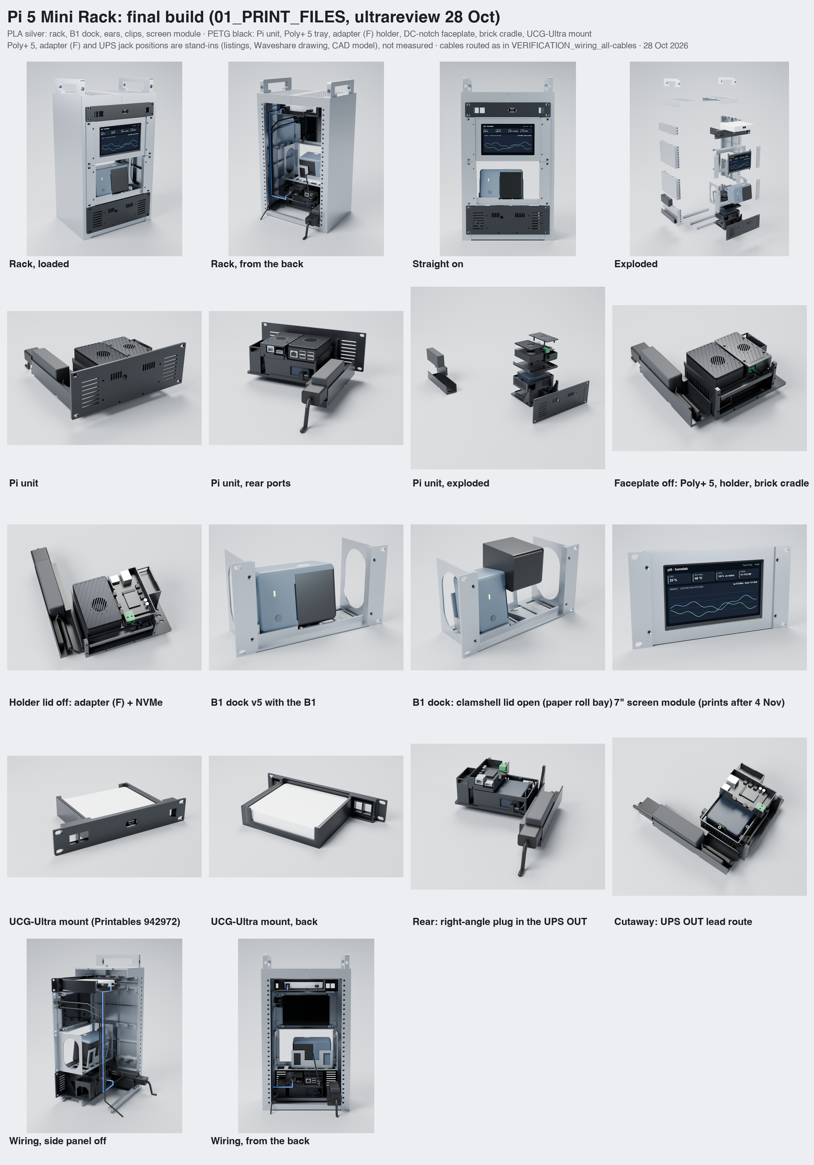
02_RENDERS/FINAL_sheet.png
