S-k404/pi5-homelab-rack/02_RENDERS/SLIM_CARGO_PROTOTYPE/01_slim_cargo_rack_isometric.png

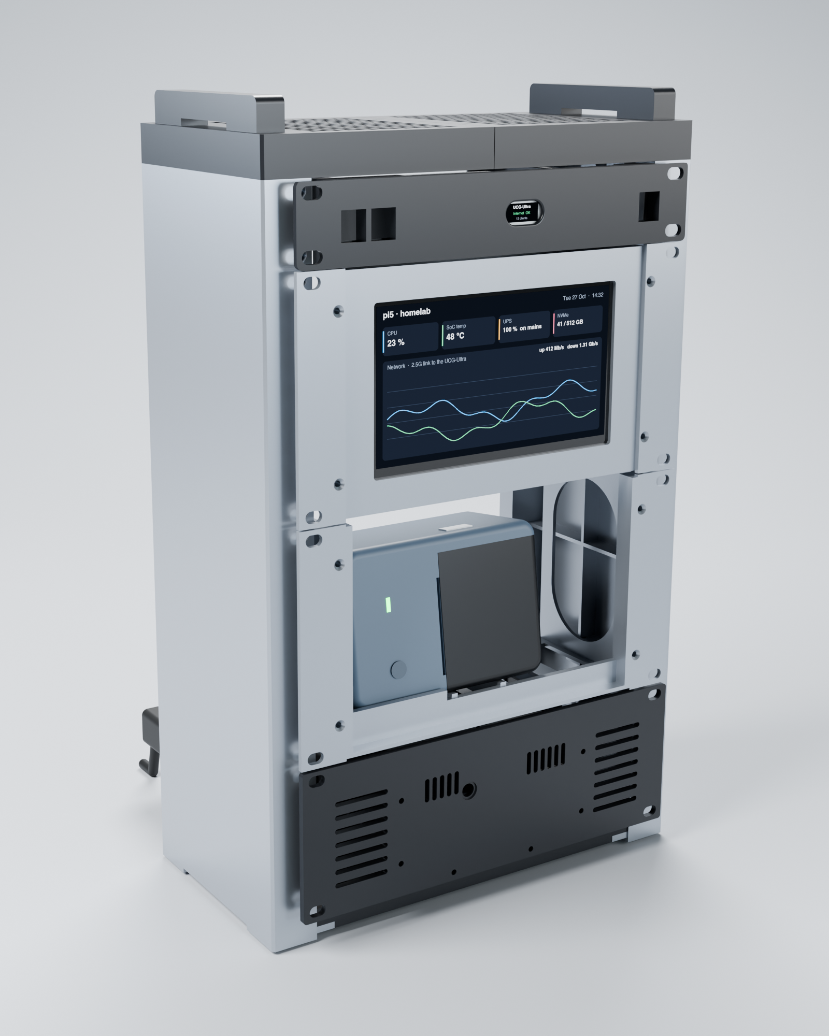
02_RENDERS/SLIM_CARGO_PROTOTYPE/01_slim_cargo_rack_isometric.png
