S-k404/pi5-homelab-rack/02_RENDERS/SLIM_CARGO_PROTOTYPE/02_slim_cargo_rack_loaded_rear.png

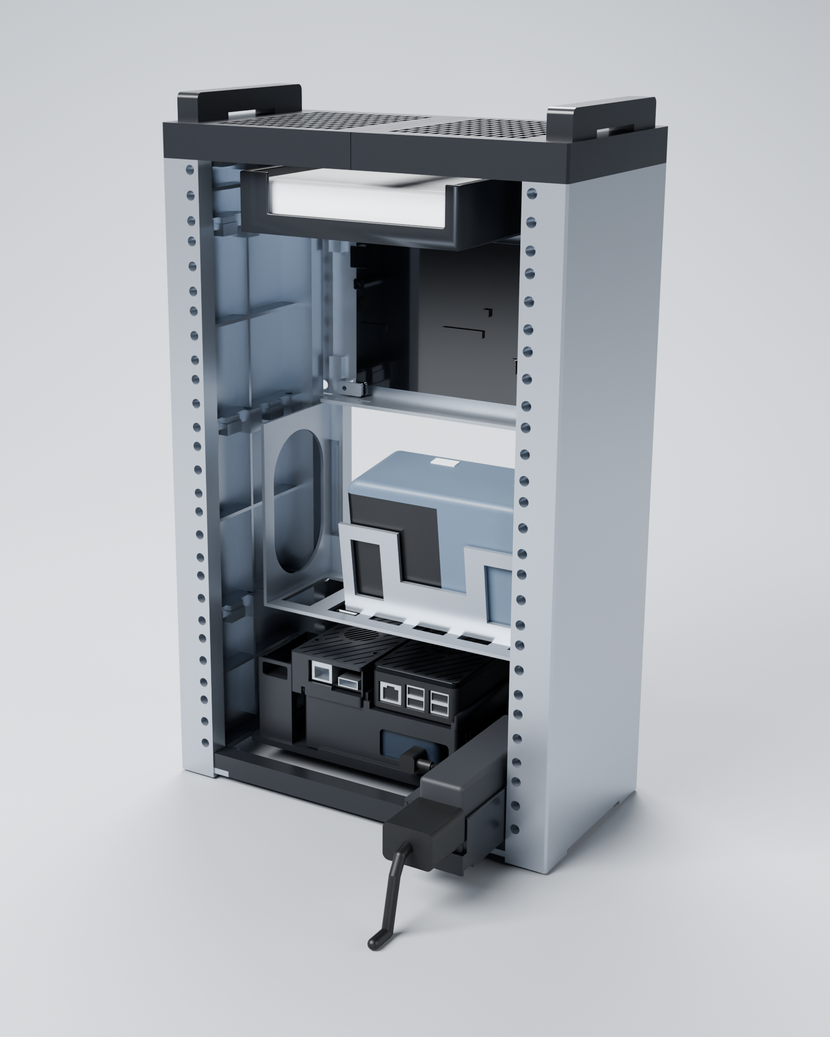
02_RENDERS/SLIM_CARGO_PROTOTYPE/02_slim_cargo_rack_loaded_rear.png
