S-k404/pi5-homelab-rack/02_RENDERS/SLIM_CARGO_PROTOTYPE/03_slim_cargo_rack_side_profile.png

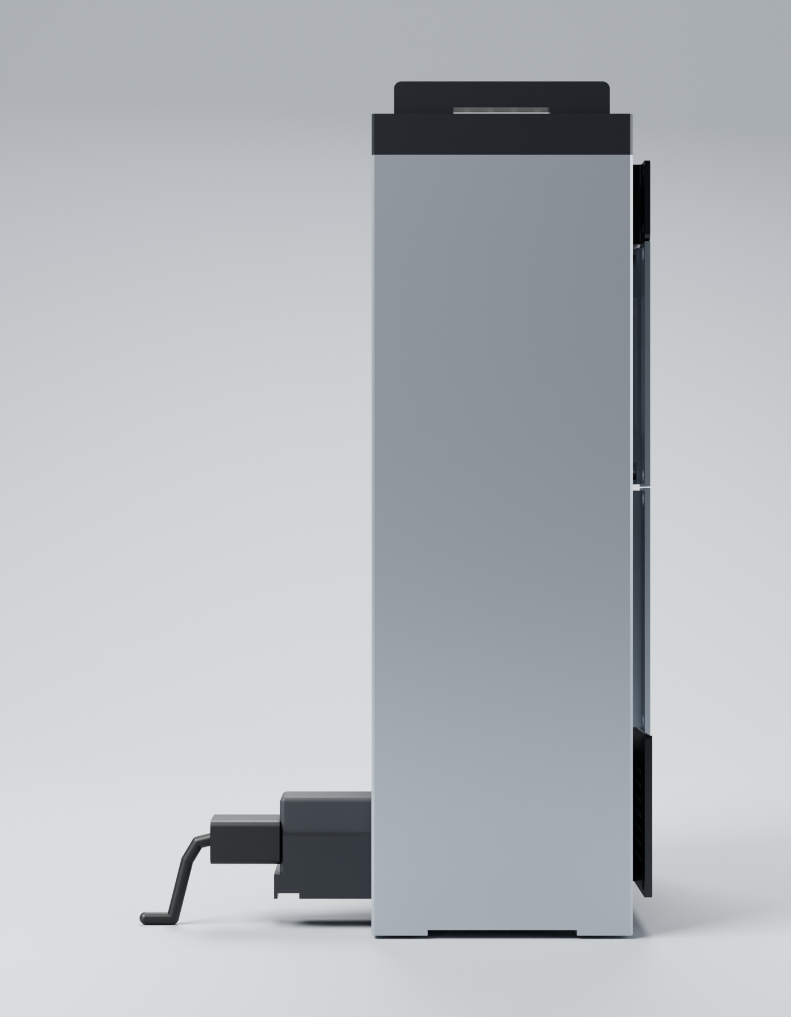
02_RENDERS/SLIM_CARGO_PROTOTYPE/03_slim_cargo_rack_side_profile.png
