S-k404/pi5-homelab-rack/02_RENDERS/SLIM_CARGO_PROTOTYPE/04_slim_cargo_rack_empty_isometric.png

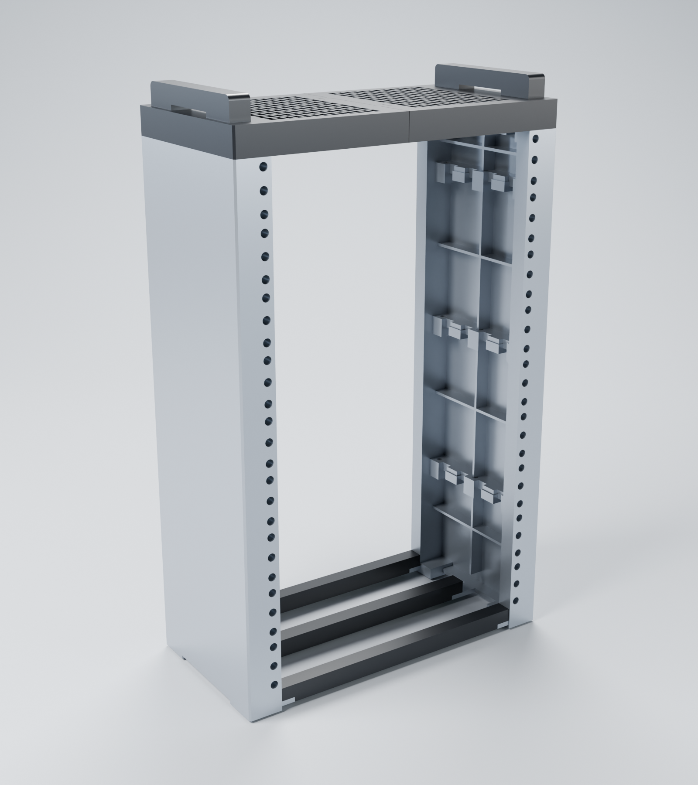
02_RENDERS/SLIM_CARGO_PROTOTYPE/04_slim_cargo_rack_empty_isometric.png
