S-k404/pi5-homelab-rack/02_RENDERS/SLIM_CARGO_PROTOTYPE/SLIM_CARGO_SHEET.png

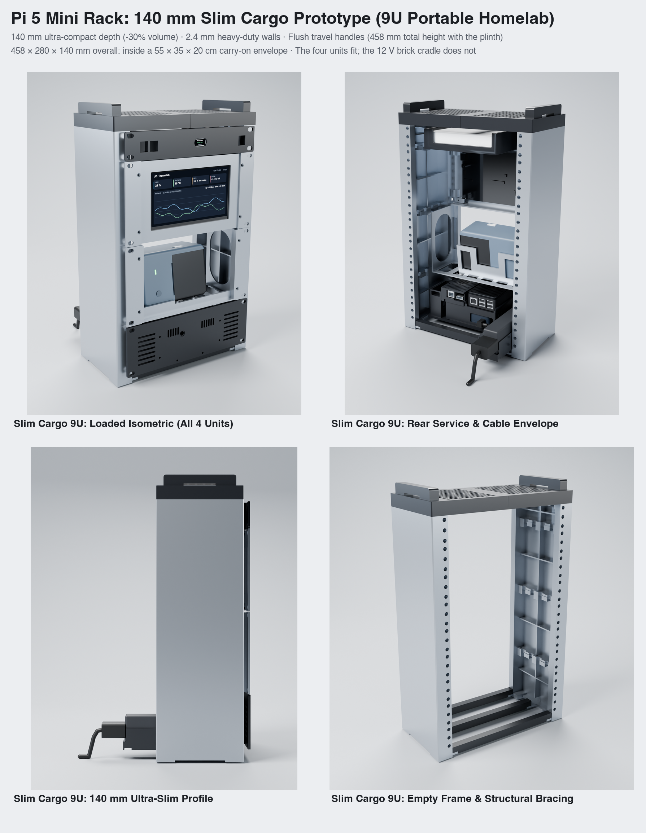
02_RENDERS/SLIM_CARGO_PROTOTYPE/SLIM_CARGO_SHEET.png
