S-k404/pi5-homelab-rack/02_RENDERS/SLIM_CARGO_PROTOTYPE/SlimCargo_Rack_360_Turntable.gif

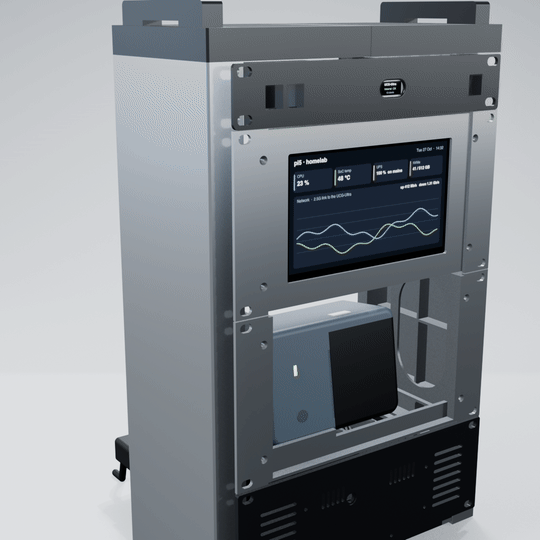
02_RENDERS/SLIM_CARGO_PROTOTYPE/SlimCargo_Rack_360_Turntable.gif
