S-k404/pi5-homelab-rack/02_RENDERS/source/screen_ui.png

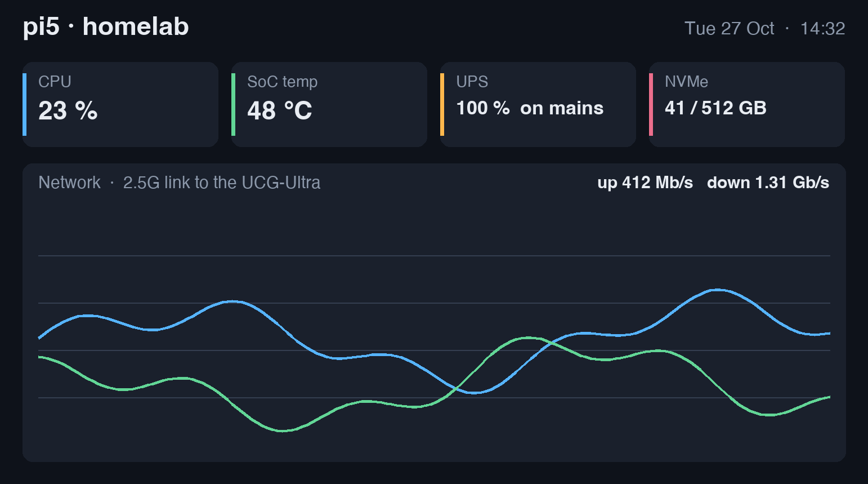
02_RENDERS/source/screen_ui.png
