S-k404/pi5-homelab-rack/04_DESIGN_SOURCE/1_Rack_9U_T0-look/images/rack_back.png

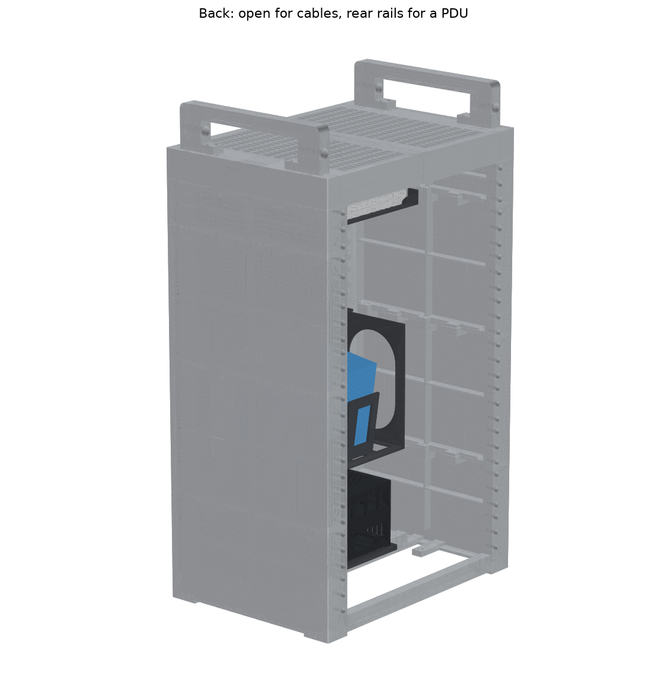
04_DESIGN_SOURCE/1_Rack_9U_T0-look/images/rack_back.png
