S-k404/pi5-homelab-rack/04_DESIGN_SOURCE/2_B1_Dock_3U/images/dock_empty.png

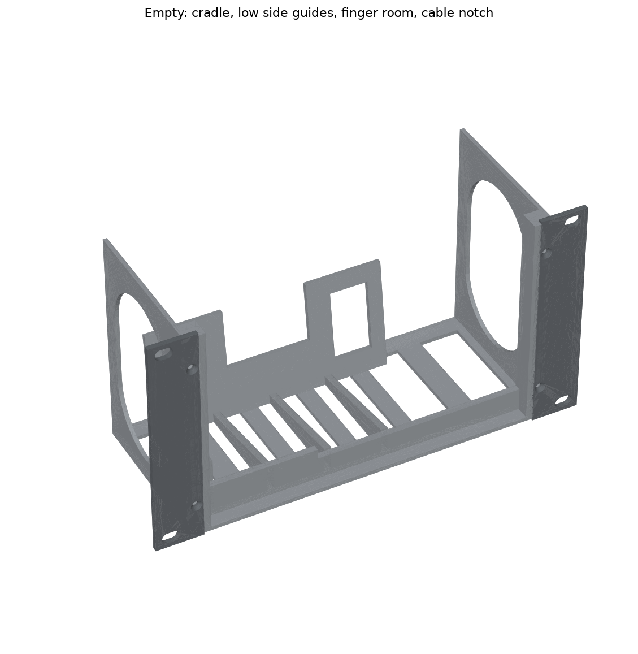
04_DESIGN_SOURCE/2_B1_Dock_3U/images/dock_empty.png
