S-k404/pi5-homelab-rack/04_DESIGN_SOURCE/3_Display_7in_3U/images/display7c_body_empty.png

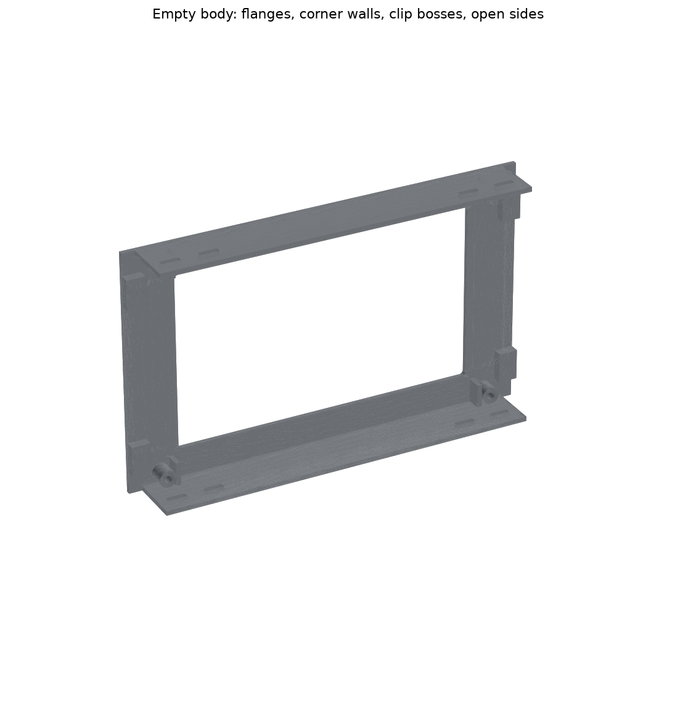
04_DESIGN_SOURCE/3_Display_7in_3U/images/display7c_body_empty.png
