S-k404/pi5-homelab-rack/04_DESIGN_SOURCE/4_Pi_Unit_2U/images/hdmi_cable_route_lid_off.png

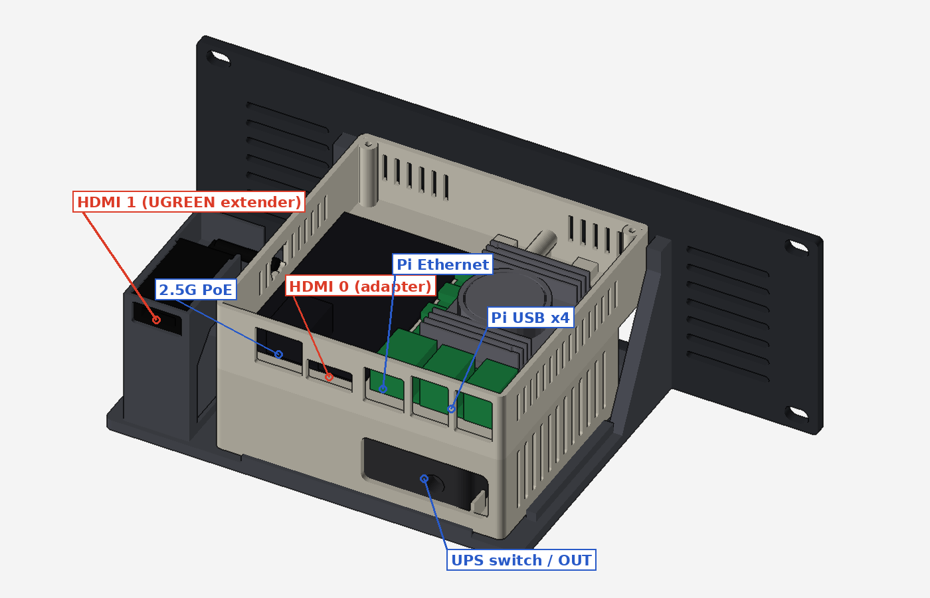
04_DESIGN_SOURCE/4_Pi_Unit_2U/images/hdmi_cable_route_lid_off.png
