S-k404/pi5-homelab-rack/04_DESIGN_SOURCE/5_UCG-Ultra_1U/images/ucg_empty.png

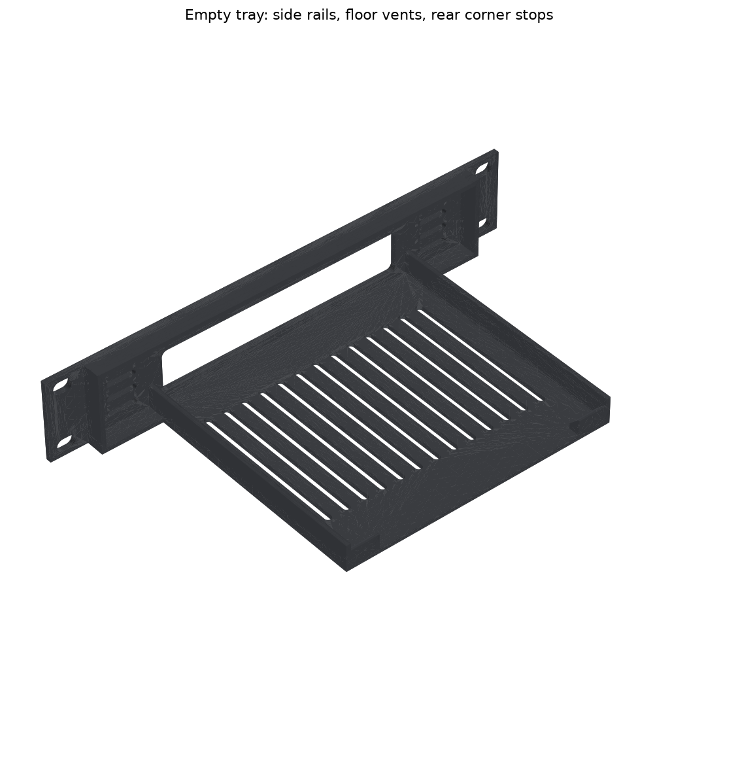
04_DESIGN_SOURCE/5_UCG-Ultra_1U/images/ucg_empty.png
