S-k404/pi5-homelab-rack/04_DESIGN_SOURCE/7_Argon_Poly5_tray+Waveshare_F_holder/11B-SIDE_PETG_Waveshare-F-holder_beside-Poly+5/Holder_rear_view.png

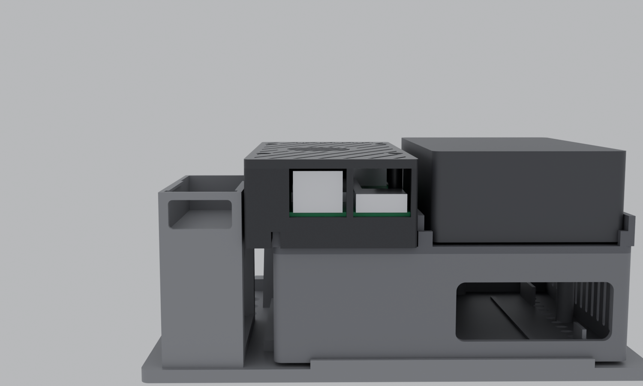
04_DESIGN_SOURCE/7_Argon_Poly5_tray+Waveshare_F_holder/11B-SIDE_PETG_Waveshare-F-holder_beside-Poly+5/Holder_rear_view.png
