S-k404/pi5-homelab-rack/05_PLATES_250x250_BED/00_MASTER_6_PLATES_SCHEDULE.png

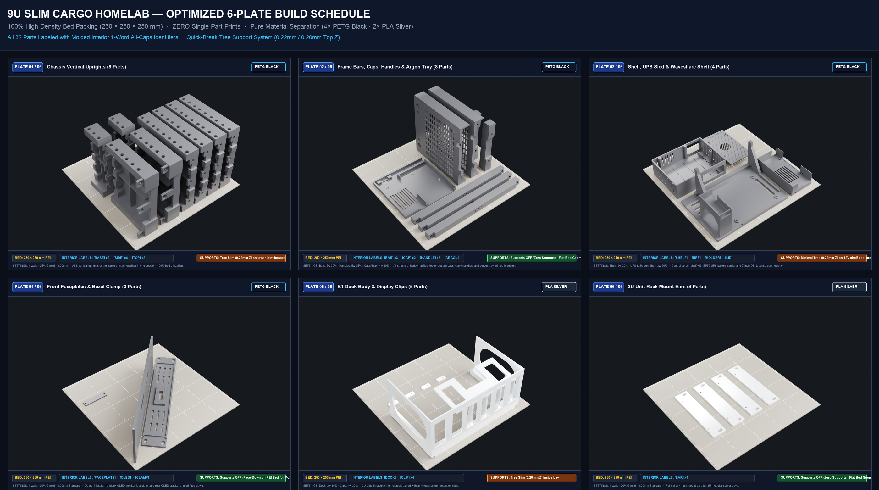
05_PLATES_250x250_BED/00_MASTER_6_PLATES_SCHEDULE.png
