S-k404/pi5-homelab-rack/05_PLATES_250x250_BED/Plate02_3D_RENDER.png

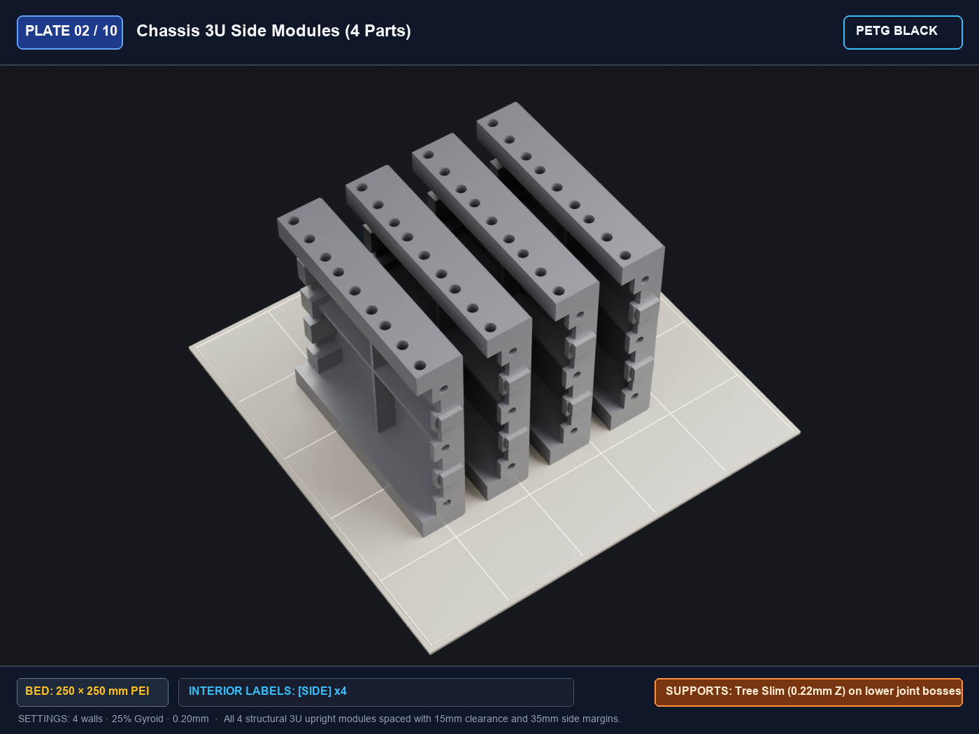
05_PLATES_250x250_BED/Plate02_3D_RENDER.png
