S-k404/pi5-homelab-rack/05_PLATES_250x250_BED/Plate02_layout.png

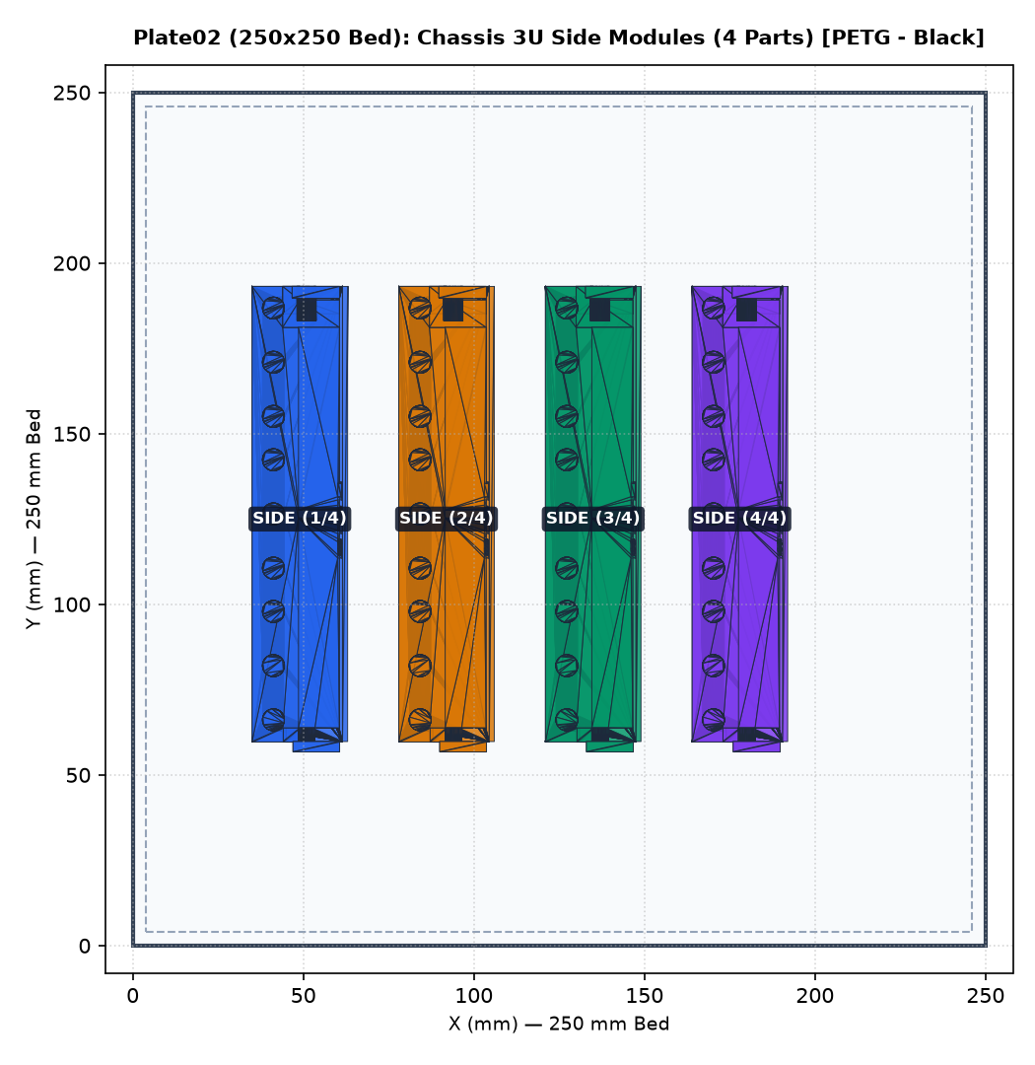
05_PLATES_250x250_BED/Plate02_layout.png
