S-k404/pi5-homelab-rack/05_PLATES_250x250_BED/renders_raw/Plate13_raw.png

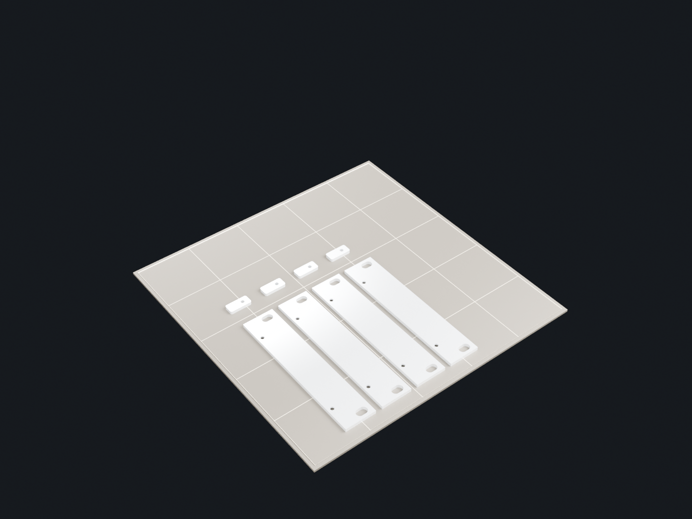
05_PLATES_250x250_BED/renders_raw/Plate13_raw.png
