S-k404/pi5-homelab-rack/_Old_versions/2026-10-26_and_earlier/BOM_Pi5-MiniRack.xlsx

Sheet: BOM
Pi 5 Mini Server — 10-inch 8U printed rack · Bill of Materials
26 Oct 2026 · prices in ₹ · blue = editable input · yellow 'Have it?' = put Y for things you already own
Section | Item | Spec / notes | Qty needed | Qty to buy | Unit price (₹) | Line total (₹) | Price status | Source | Used in | Have it?
Electronics
Electronics | Raspberry Pi 5 8GB | BCM2712, 8 GB | 1 | 1 | ₹19999 | ₹19999 | Earlier research | Authorised reseller (earlier chat) | Pi unit
Electronics | Waveshare Pi5 Connector Adapter (F) | Moves ports to the back for rack use | 1 | 1 | ₹4949 | ₹4949 | Earlier research | Earlier chat | Pi unit
Electronics | EVM 512GB 2230 NVMe | PCIe Gen3 x4, 2230 | 1 | 1 | ₹11045 | ₹11045 | Check — looks high | primeabgb.com (in stock, 26 Oct) | Pi unit
Electronics | GeeekPi Armor Lite V5 | Pi 5 heatsink + fan | 1 | 1 | ₹2478 | ₹2478 | Earlier research | Earlier chat | Pi unit
Electronics | Cuzor Mini UPS Pro 12V | 12 V DC UPS for the Pi | 1 | 1 | ₹1998 | ₹1998 | Earlier research | Earlier chat | Pi unit
Electronics | REES52 7" HDMI touch display | 1024×600, capacitive USB touch, 165×100×5 glass | 1 | 1 | ₹4200 | ₹4200 | Listing price | rees52.com | Screen module (3U)
Electronics | NIIMBOT B1 label printer | Already owned | 1 | 0 | ₹0 | ₹0 | Owned | — | B1 dock (3U) | Y
Power & cables
Power & cables | 12 V 3 A adapter, 5.5×2.1 centre + | Mean Well GST60A12-P1J or equal; feeds the UPS | 1 | 1 | ₹2477 | ₹2477 | Earlier research | Earlier chat | UPS input
Power & cables | Right-angle 5.5×2.1 DC pigtail | UPS → Pi adapter, keeps the plug inside the rack | 1 | 1 | ₹120 | ₹120 | Estimate | Robu / Amazon.in | Pi unit
Power & cables | UGREEN 20134 micro-HDMI → HDMI (F) | Short pigtail from Pi 5 micro-HDMI | 1 | 1 | ₹500 | ₹500 | Estimate | Amazon.in | Pi → screen
Power & cables | HDMI cable 30–50 cm | Check if the screen board is full-size or mini HDMI first | 1 | 1 | ₹250 | ₹250 | Estimate | Amazon.in | Pi → screen
Power & cables | USB cable for touch, 30–50 cm | USB-A to the screen's touch port (check micro-USB vs USB-C) | 1 | 1 | ₹150 | ₹150 | Estimate | Amazon.in | Pi → screen
Power & cables | 5 V 2 A USB adapter + cable | Separate supply for the screen (not from Pi/UPS) | 1 | 1 | ₹350 | ₹350 | Estimate | Amazon.in | Screen power
Power & cables | USB-C cable 30 cm | B1 to a Pi USB port (charging + niimprint) | 1 | 1 | ₹150 | ₹150 | Estimate | Amazon.in | B1 dock
Filament
Filament | PETG 1.75 mm, 1 kg spool | Qty needed is in kg (incl. 15% margin) — from the Printed_Parts tab. Grey/silver for the RackMate look | 1.28 | 2 | ₹1100 | ₹2200 | Estimate | Robu.in (Numakers / Pro-Range PETG) | All printed parts
Fasteners
Fasteners | M5 heat-set inserts, Ø6.4 hole | Probots M5/M6 kit (90 pcs) covers it | 44 | 1 | ₹1099 | ₹1099 | Listing price | probots.co.in | Rack
Fasteners | M3 heat-set inserts, Ø4 hole, ~5–6 mm long | Buy short ones — the Robu M3×12 (₹392/50) are too long for 6 mm holes | 36 | 100 | ₹3 | ₹300 | Estimate | Robu / Amazon.in | Rack, dock, screen
Fasteners | M5 × 12 countersunk screws | ISO 10642, A2 or black oxide | 28 | 30 | ₹4 | ₹120 | Estimate | Local hardware / Amazon.in | Rack joints, base bars
Fasteners | M5 × 12 button-head screws | Or M5 thumbscrews for tool-less unit removal | 16 | 20 | ₹5 | ₹100 | Estimate | Local hardware / Amazon.in | Handles + unit ears
Fasteners | M5 washers |  | 16 | 20 | ₹1 | ₹20 | Estimate | Local hardware | Handles + unit ears
Fasteners | M3 × 8 button-head screws |  | 28 | 30 | ₹2 | ₹60 | Estimate | Local hardware / Amazon.in | Side panels, screen clips
Fasteners | M3 × 8 countersunk screws |  | 8 | 10 | ₹2 | ₹20 | Estimate | Local hardware / Amazon.in | Dock + screen ears
Misc
Misc | Stick-on rubber feet, 10–15 mm | Pack | 4 | 1 | ₹100 | ₹100 | Estimate | Amazon.in | Base bars
Misc | 1 mm foam tape | Roll | 1 | 1 | ₹150 | ₹150 | Estimate | Amazon.in | Screen clips, driver board
Misc | Self-adhesive felt sheet (optional) | Stops the B1 rattling | 1 | 1 | ₹150 | ₹150 | Estimate | Amazon.in | B1 dock
Misc | Zip ties, small | Driver board + cable management | 1 | 1 | ₹80 | ₹80 | Estimate | Local | Screen tray, cables
Misc | Pi unit case hardware | Listed in the Pi unit README (25 Oct bundle) — not repeated here | 1 | 0 | ₹0 | ₹0 | See Pi README | — | Pi unit
 |  |  |  |  | Total, everything | ₹53065
 |  |  |  |  | Electronics | ₹44669
 |  |  |  |  | Power & cables | ₹3997
 |  |  |  |  | Filament | ₹2200
 |  |  |  |  | Fasteners + misc | ₹2199
 |  |  |  |  | Still to spend (rows not marked Y) | ₹53065
 |  |  |  |  | Of that, estimates (verify) | ₹4820
Notes
• Prices marked 'Earlier research' were gathered in earlier chats; 'Listing price' was read from the seller page on 26 Oct 2026; 'Estimate' is a typical Indian retail price — check before ordering.
• EVM NVMe at ₹11,045 (primeabgb) looks high for 512 GB 2230 — shop around.
• Screen: confirm the driver board's HDMI socket (full-size vs mini) and touch port before buying cables.
• Screen gets its own 5 V 2 A supply: the UPS's 3 A is mostly used by the Pi at full load.
• Hardware counts are rolled up on the Hardware tab; grams and spool count on the Printed Parts tab.

Sheet: Printed_Parts
Printed parts — PETG, 0.2 mm layers, no supports
Module | File (STL_for_printing/) | Qty | ≈ g each (PETG) | Settings | Bed size (mm) | ≈ g total
Rack 8U | Rack_SideFrame_2U_x2.stl | 2 | 42 | 3 walls, 20% gyroid | 125 × 89 × 14 | 84
Rack 8U | Rack_SideFrame_3U_x4.stl | 4 | 52 | 3 walls, 20% gyroid | 125 × 133 × 14 | 208
Rack 8U | Rack_SidePanel_Lower_x2.stl | 2 | 46 | solid | 202 × 129 × 1.4 | 92
Rack 8U | Rack_SidePanel_Upper_x2.stl | 2 | 46 | solid | 202 × 129 × 1.4 | 92
Rack 8U | Rack_TopHalf_x2.stl | 2 | 69 | 3 walls, 15% | 131 × 114 × 25 | 138
Rack 8U | Rack_Handle_x2.stl | 2 | 17 | 3 walls, 30% | 93 × 40 × 12 | 34
Rack 8U | Rack_BaseBar_x2.stl | 2 | 41 | 3 walls, 15% | 254 long, diagonal | 82
Rack 8U | Rack_Splice_x12.stl | 12 | 6 | 3 walls, 30% | 30 × 50 × 4 | 72
B1 dock 3U | B1_Dock_3U_Body.stl | 1 | 145 | 3 walls, 15% | 214 × 95 × 130 | 145
B1 dock 3U | B1_Dock_3U_Ear_x2.stl | 2 | 13 | 3 walls, 15% | 28 × 132.55 × 3 | 26
Screen 3U | Display7_3U_Body.stl | 1 | 110 | 3 walls, 15% | 214 × 130 × 70 | 110
Screen 3U | Display7_Clip_x4.stl | 4 | 1 | 3 walls, 15% | 16 × 16 × 3 | 4
Screen 3U | B1_Dock_3U_Ear_x2.stl (same part as dock ears) | 2 | 13 | 3 walls, 15% | 28 × 132.55 × 3 | 26
 |  |  |  |  | Rack total (g) | 802
 |  |  |  |  | B1 dock total (g) | 171
 |  |  |  |  | Screen total (g) | 140
 |  |  |  |  | All printed parts (g) | 1113
 |  |  |  |  | Waste / purge / failed-print margin | 15%
 |  |  |  |  | Spool size (g) | 1000
 |  |  |  |  | Filament needed incl. margin (kg) | 1.28
 |  |  |  |  | Spools to buy | 2
Gram figures are the CAD estimates (shell + infill model); your slicer gives exact numbers. PLA ≈ 2% lighter.

Sheet: Hardware
Fastener roll-up — where every screw and insert goes
Item | Total needed | Rack 8U | B1 dock | Screen module | Where
M5 heat-set inserts | 44 | 44 | 0 | 0 | 24 frame pockets + 4 top corners + 4 handle feet + 12 rail holes
M3 heat-set inserts | 36 | 24 | 4 | 8 | Rack: side-panel posts · dock: ear posts · screen: 4 ears + 4 clips
M5 × 12 countersunk | 28 | 28 | 0 | 0 | Base-bar tabs and splices (flush under the panels)
M5 × 12 button head | 16 | 16 | 0 | 0 | 4 handle feet + 12 unit ears (Pi 4, dock 4, screen 4)
M5 washers | 16 | 16 | 0 | 0 | With the button-head screws
M3 × 8 button head | 28 | 24 | 0 | 4 | Side panels · screen clips
M3 × 8 countersunk | 8 | 0 | 4 | 4 | Ears to dock body · ears to screen body
M5 rack screws for unit ears are counted under the rack. The Pi unit's own case screws are in its README.

Sheet: Read_me
How to use this BOM
1. Blue numbers are inputs: change quantities or prices and every total updates.
2. Put Y in the yellow 'Have it?' column for parts you already own — 'Still to spend' drops accordingly.
3. Green cells pull counts from the Hardware and Printed_Parts tabs.
4. 'Price status' tells you how firm each price is: Listing price > Earlier research > Estimate. Red = check before buying.
Example row (how a line reads)
Fasteners | M3 × 8 button-head screws | Qty needed 28 | Qty to buy 30 | ₹2 each | ₹60 | Estimate | Side panels, screen clips
