S-k404/pi5-homelab-rack/05_PLATES_250x250_BED/00_ROBU_17_PARTS_EMBOSSED_CATALOG.png

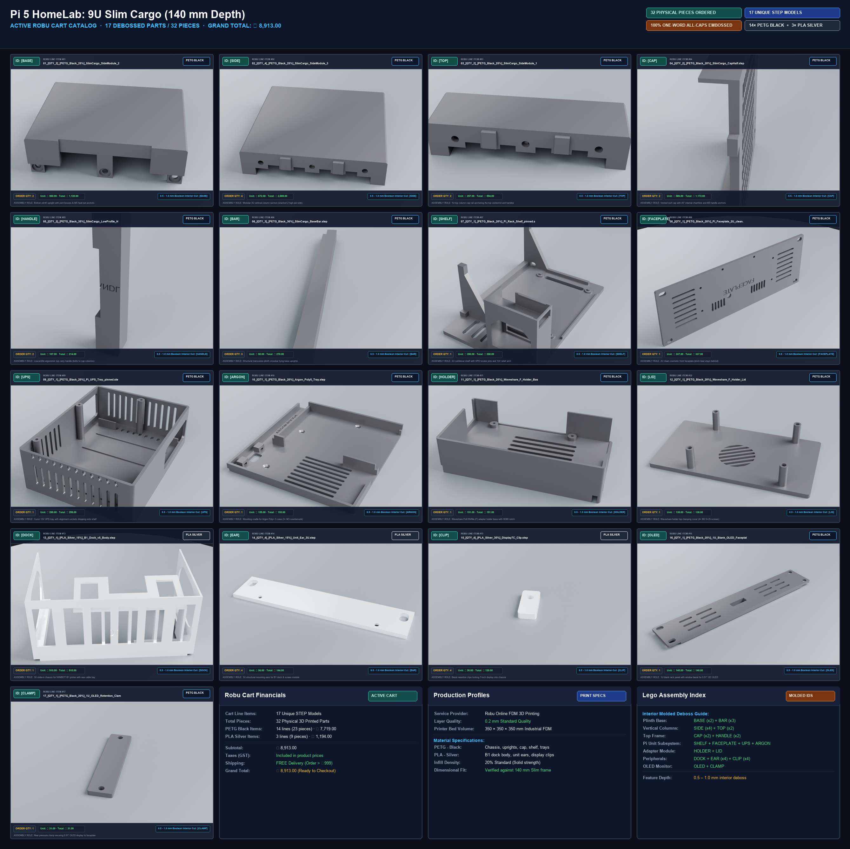
05_PLATES_250x250_BED/00_ROBU_17_PARTS_EMBOSSED_CATALOG.png
