S-k404/pi5-homelab-rack/05_PLATES_250x250_BED/robu_parts/Part_01_BASE.png

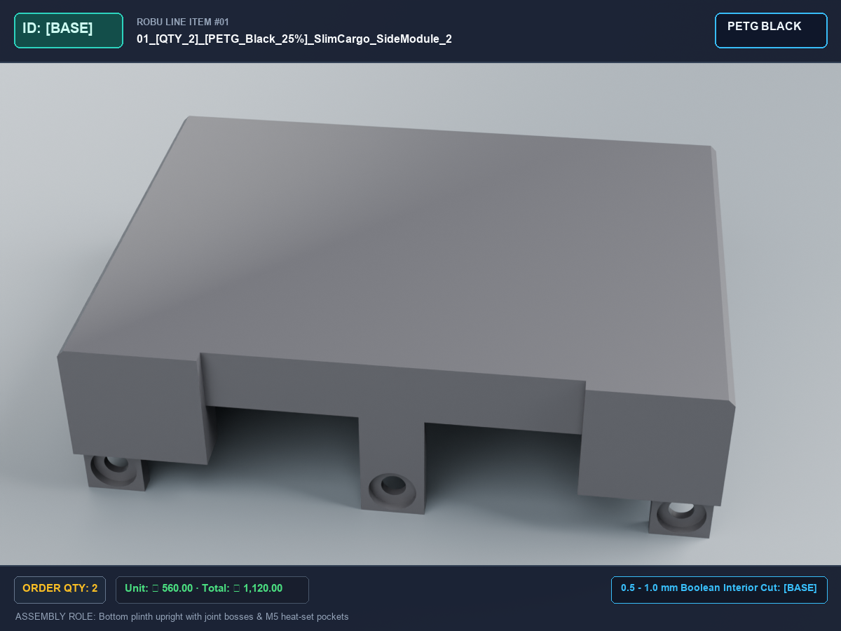
05_PLATES_250x250_BED/robu_parts/Part_01_BASE.png
