S-k404/pi5-homelab-rack/05_PLATES_250x250_BED/robu_parts/Part_07_SHELF.png

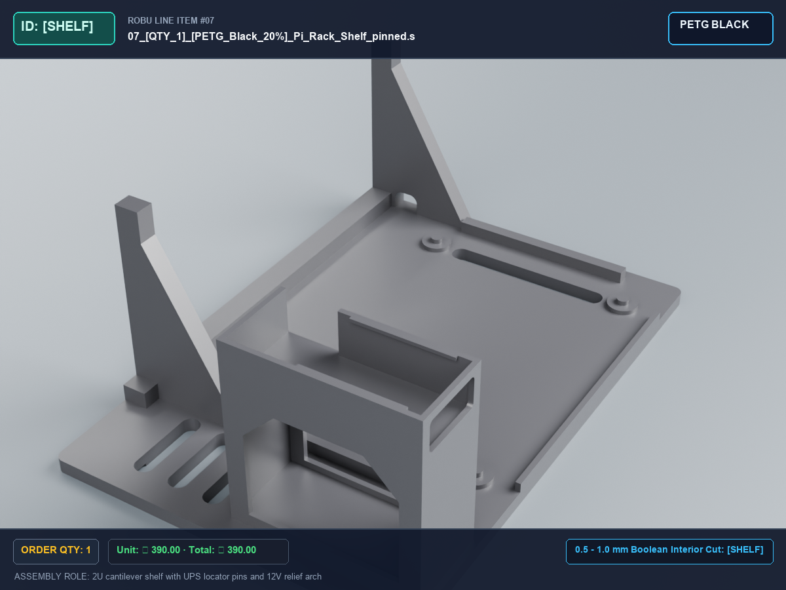
05_PLATES_250x250_BED/robu_parts/Part_07_SHELF.png
