S-k404/pi5-homelab-rack/05_PLATES_250x250_BED/robu_parts_raw/Part_08_FACEPLATE_raw.png

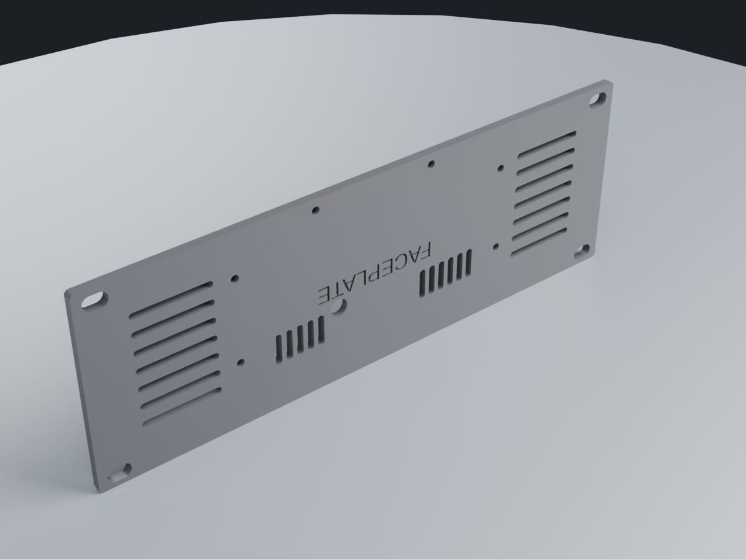
05_PLATES_250x250_BED/robu_parts_raw/Part_08_FACEPLATE_raw.png
