S-k404/pi5-homelab-rack/05_PLATES_250x250_BED/robu_parts_raw/Part_15_CLIP_raw.png

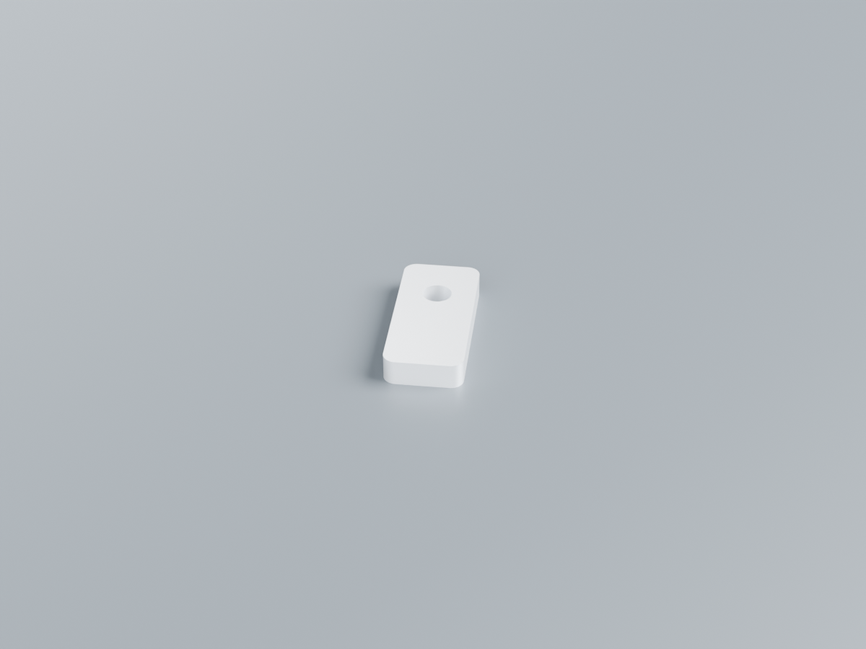
05_PLATES_250x250_BED/robu_parts_raw/Part_15_CLIP_raw.png
