S-k404/pi5-homelab-rack/04_DESIGN_SOURCE/10_Slim_Cargo_Rack_140mm/STEP_for_Onshape/SlimCargo_Rack_9U_140mm_ASSEMBLY.step

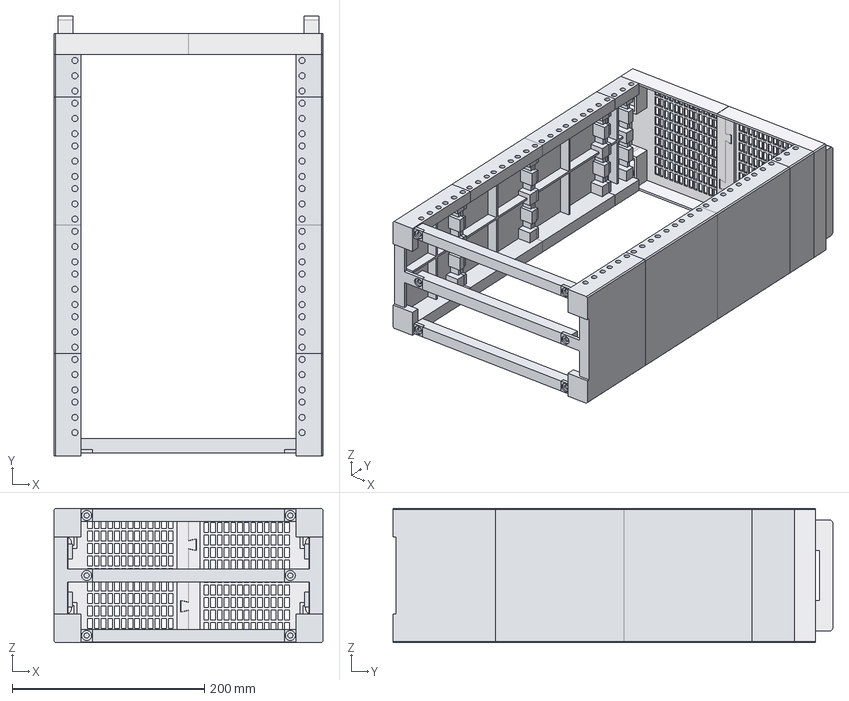
[picture p118: CAD file, 2026-10-28]
04_DESIGN_SOURCE/10_Slim_Cargo_Rack_140mm/STEP_for_Onshape/SlimCargo_Rack_9U_140mm_ASSEMBLY.step
280.0 x 458.1 x 140.0 mm
side_0_2U_R
side_0_2U_L
side_1_3U_R
side_1_3U_L
side_2_3U_R
side_2_3U_L
side_3_1U_R
side_3_1U_L
bar_0
bar_1
bar_2
cap_R
cap_L
handle_R
handle_L
