S-k404/pi5-homelab-rack/04_DESIGN_SOURCE/3_Display_7in_3U/STEP_for_Onshape/Display7C_3U_ASSEMBLY.step

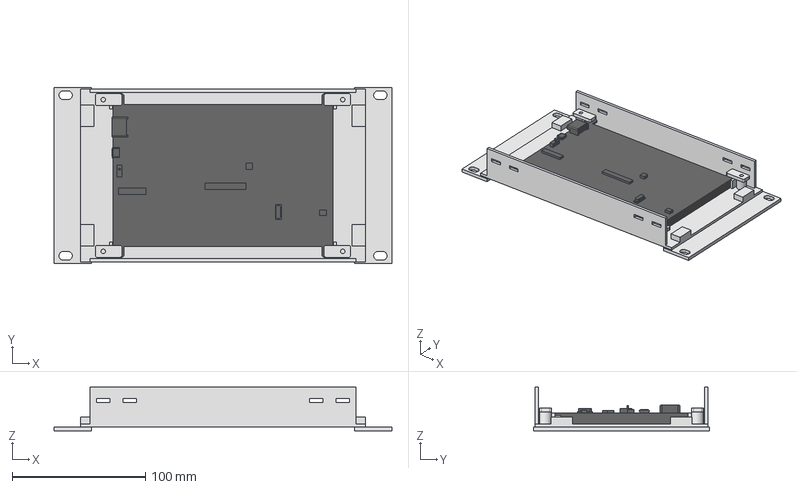
[picture p119: CAD file, 2026-10-28]
04_DESIGN_SOURCE/3_Display_7in_3U/STEP_for_Onshape/Display7C_3U_ASSEMBLY.step
254.0 x 132.6 x 33.0 mm
screen (Waveshare model)
clip0
clip1
clip2
clip3
ear1
ear-1
