S-k404/pi5-homelab-rack/04_DESIGN_SOURCE/ONSHAPE_PROJECT/Pi5_HomeLab_9U_Complete_ASSEMBLY.step

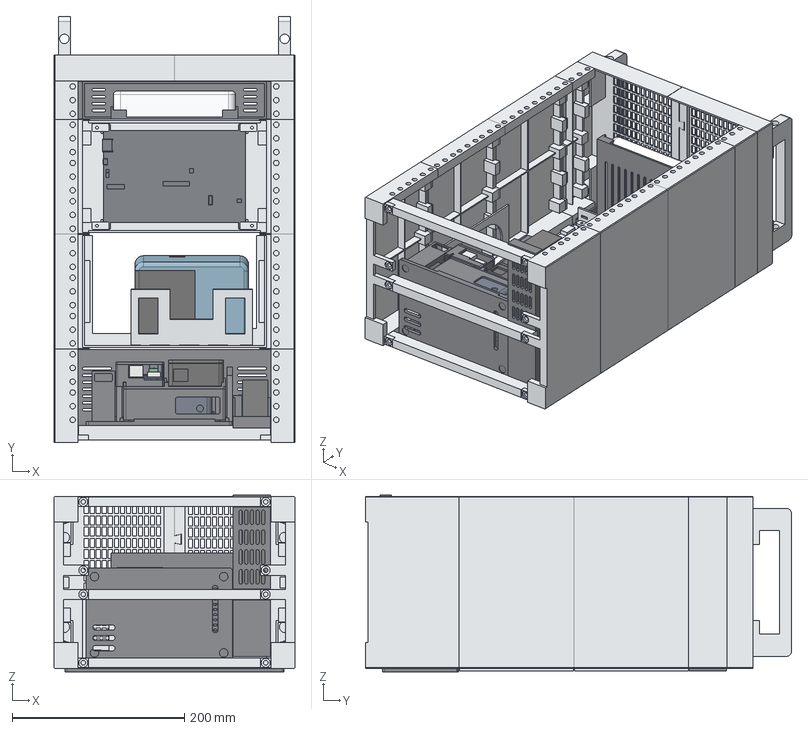
[picture p120: CAD file, 2026-10-28]
04_DESIGN_SOURCE/ONSHAPE_PROJECT/Pi5_HomeLab_9U_Complete_ASSEMBLY.step
280.0 x 495.1 x 205.4 mm
Rack_side_0_2U_R
Rack_side_0_2U_L
Rack_side_1_3U_R
Rack_side_1_3U_L
Rack_side_2_3U_R
Rack_side_2_3U_L
Rack_side_3_1U_R
Rack_side_3_1U_L
Rack_bar_front
Rack_bar_middle
Rack_bar_rear
Rack_cap_R
Rack_cap_L
Rack_handle_R
Rack_handle_L
UCG_Ultra_1U_Shelf
UniFi_UCG_Ultra_Gateway
Display7C_3U_Body
Display7C_Ear_R
Display7C_Ear_L
Waveshare_7in_LCD
Display7C_Clip_1
Display7C_Clip_2
Display7C_Clip_3
Display7C_Clip_4
B1_Dock_3U_Body
B1_Dock_3U_Ear_R
B1_Dock_3U_Ear_L
NIIMBOT_B1_Body
NIIMBOT_B1_Lid
NIIMBOT_B1_Slide
NIIMBOT_B1_Button
NIIMBOT_B1_LED
Pi5_Rack_Shelf
Pi5_Faceplate_2U_clean
Pi5_UPS_Tray
Cuzor_MiniUPS_Pro_12V3A
Pi5_ArgonPoly5_Tray
Waveshare_F_Holder_Base
Waveshare_F_Holder_Lid
Argon_Poly5_Shell
Argon_Poly5_Top
Waveshare_Adapter_F_PCB
Adapter_F_RJ45_HDMI
Adapter_F_12V_Terminal
EVM_512GB_NVMe_SSD
Brick_Cradle_12V
Brick_Spacer_8mm
Power_Brick_12V_5A
