S-k404/pi5-homelab-rack/04_DESIGN_SOURCE/5_UCG-Ultra_1U/STEP_for_Onshape/UCG_Ultra_1U_ASSEMBLY.step

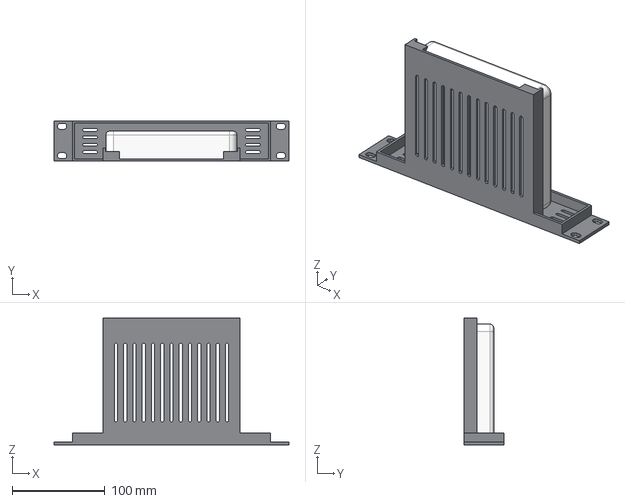
[picture p121: CAD file, 2026-10-28]
04_DESIGN_SOURCE/5_UCG-Ultra_1U/STEP_for_Onshape/UCG_Ultra_1U_ASSEMBLY.step
254.0 x 43.6 x 137.2 mm
UCG_shelf
UCG_Ultra
