S-k404/pi5-homelab-rack/04_DESIGN_SOURCE/2_B1_Dock_3U/STEP_for_Onshape/B1_Dock_3U_ASSEMBLY.step

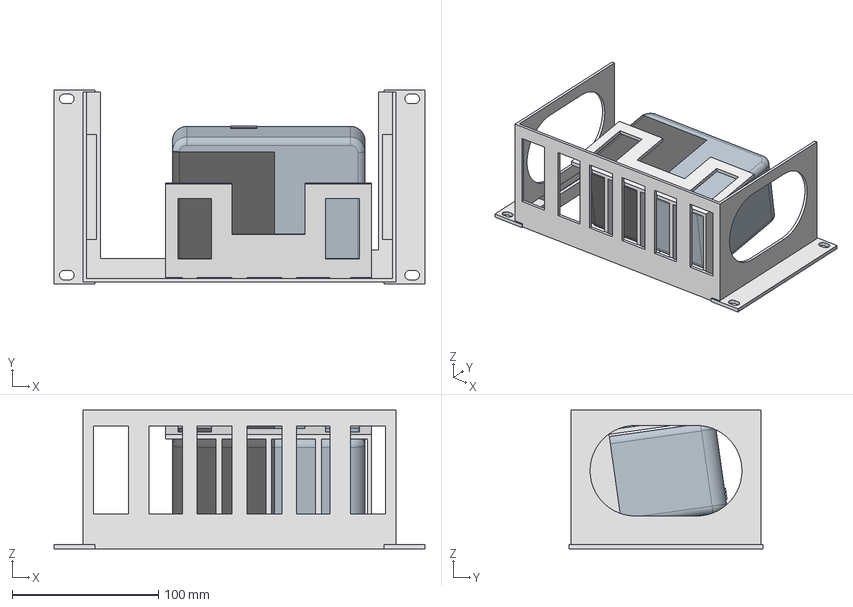
[picture p122: CAD file, 2026-10-28]
04_DESIGN_SOURCE/2_B1_Dock_3U/STEP_for_Onshape/B1_Dock_3U_ASSEMBLY.step
254.0 x 132.6 x 95.0 mm
ear_a
ear_b
niimbot_b1_body
niimbot_b1_lid
niimbot_b1_slide
niimbot_b1_led
niimbot_b1_button
