S-k404/pi5-homelab-rack/04_DESIGN_SOURCE/1_Rack_9U_T0-look/STEP_for_Onshape/Rack_9U_T0look_ASSEMBLY_with_units.step

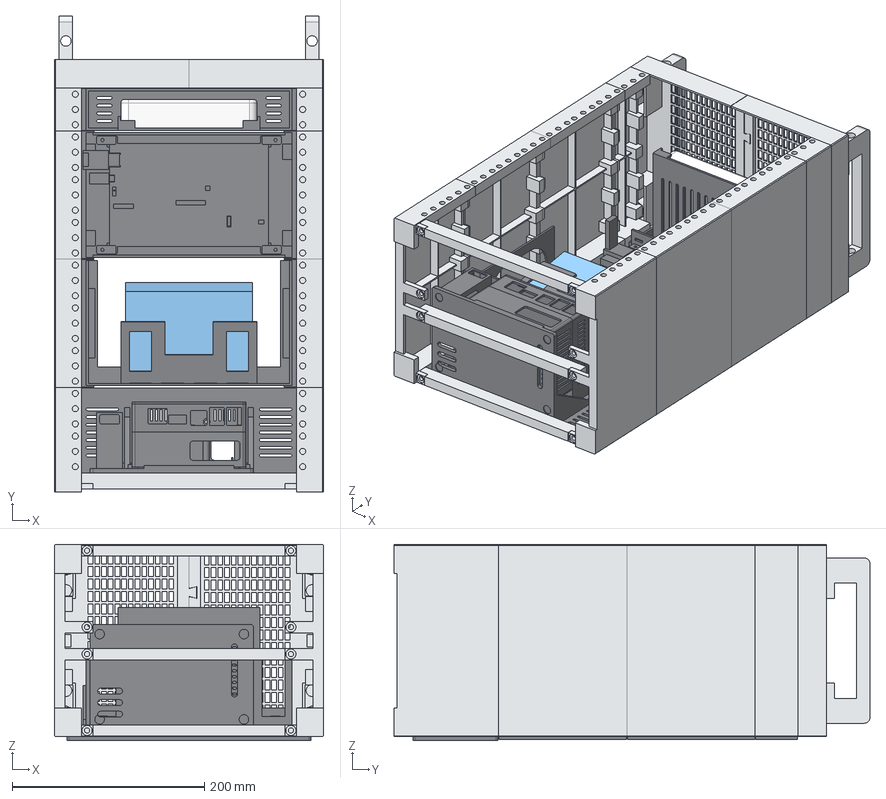
[picture p124: CAD file, 2026-10-28]
04_DESIGN_SOURCE/1_Rack_9U_T0-look/STEP_for_Onshape/Rack_9U_T0look_ASSEMBLY_with_units.step
280.0 x 495.1 x 204.0 mm
side_0_2U_R
side_0_2U_L
side_1_3U_R
side_1_3U_L
side_2_3U_R
side_2_3U_L
side_3_1U_R
side_3_1U_L
bar_front
bar_middle
bar_rear
cap_R
cap_L
handle_R
handle_L
Pi_shelf
Pi_faceplate
Pi_UPS_tray
Pi_board_tray
Pi_lid
B1_dock
dock_ear_R
dock_ear_L
B1_67_mm
display
screen_glass
driver_board
display_ear_R
display_ear_L
display_clip_0
display_clip_1
display_clip_2
display_clip_3
UCG_shelf
UCG-Ultra
