S-k404/pi5-homelab-rack/01_PRINT_FILES/1_PRINT-NOW/01_Rack_SideModule_2U_Base__x2__PLA.stl

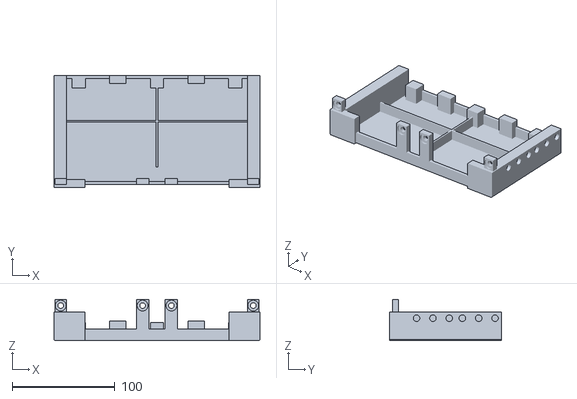
[picture p125: CAD file, 2026-10-28]
01_PRINT_FILES/1_PRINT-NOW/01_Rack_SideModule_2U_Base__x2__PLA.stl
200.0 x 108.9 x 40.0
