S-k404/pi5-homelab-rack/01_PRINT_FILES/1_PRINT-NOW/P1S_plates/Plate10.3mf

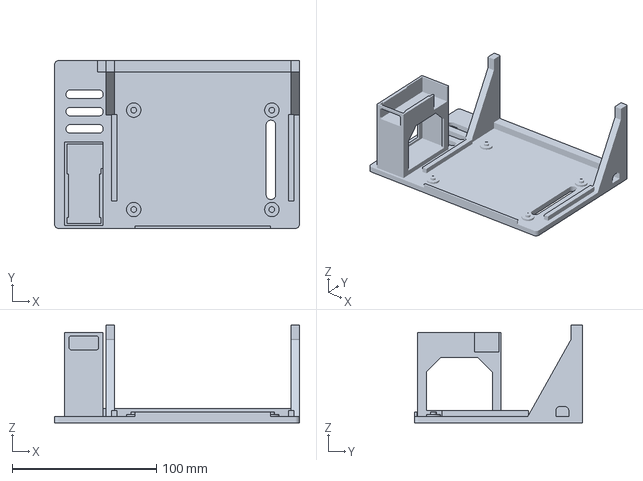
[picture p126: CAD file, 2026-10-28]
01_PRINT_FILES/1_PRINT-NOW/P1S_plates/Plate10.3mf
170.1 x 116.7 x 68.0 mm
