S-k404/pi5-homelab-rack/01_PRINT_FILES/2_CHECK-UPS-FIRST/P1S_plates/Plate11_CHECK-UPS.3mf

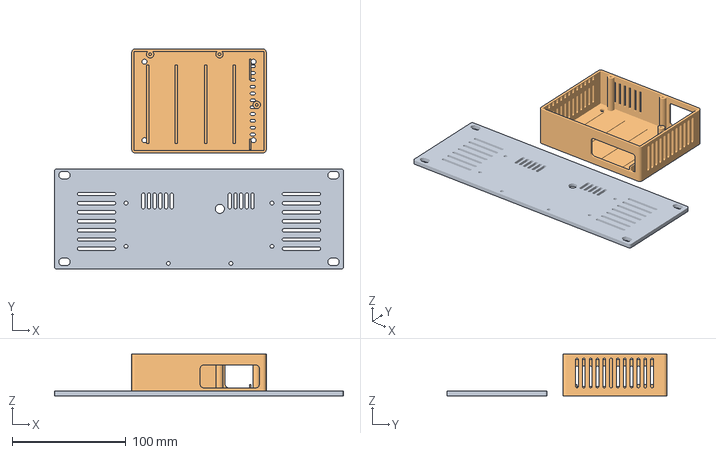
[picture p127: CAD file, 2026-10-28]
01_PRINT_FILES/2_CHECK-UPS-FIRST/P1S_plates/Plate11_CHECK-UPS.3mf
254.0 x 193.5 x 36.5 mm
Faceplate_2U_clean
UPS_tray_pinned
