S-k404/pi5-homelab-rack/01_PRINT_FILES/3_WAIT/P1S_plates/Plate11W_WAIT.3mf

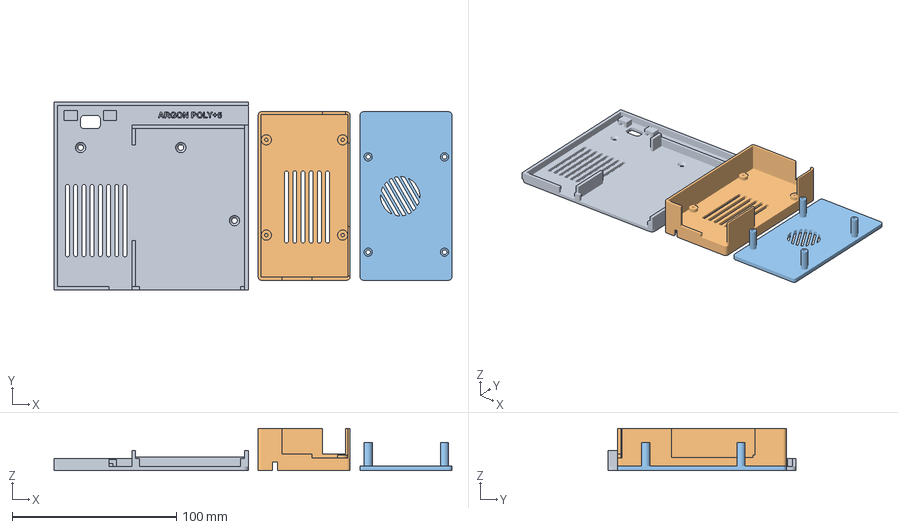
[picture p128: CAD file, 2026-10-28]
01_PRINT_FILES/3_WAIT/P1S_plates/Plate11W_WAIT.3mf
242.3 x 114.4 x 25.8 mm
Argon_Poly5_tray
F_holder_base
F_holder_lid
