S-k404/pi5-homelab-rack/01_PRINT_FILES/4_OPTIONAL_spare-spacers/O1_Brick_Spacer_6mm__x1__PETG__only-if-brick-30.5-32.5mm.stl

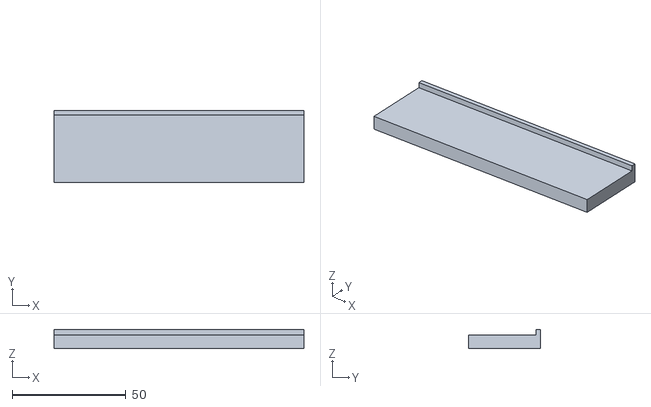
[picture p129: CAD file, 2026-10-28]
01_PRINT_FILES/4_OPTIONAL_spare-spacers/O1_Brick_Spacer_6mm__x1__PETG__only-if-brick-30.5-32.5mm.stl
110.0 x 31.6 x 8.40
