S-k404/pi5-homelab-rack/01_PRINT_FILES/5_SLIM_CARGO_140mm_TRAVEL_PROTOTYPE/P1S_plates/SlimPlate02.3mf

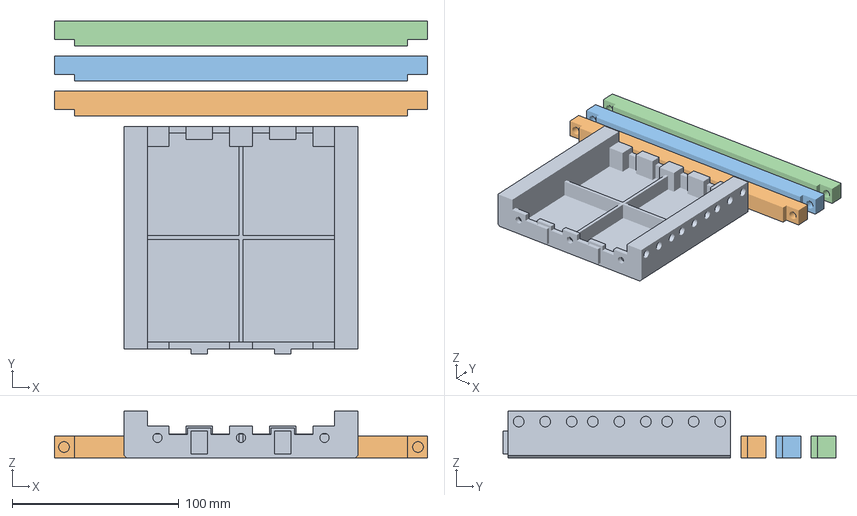
[picture p130: CAD file, 2026-10-28]
01_PRINT_FILES/5_SLIM_CARGO_140mm_TRAVEL_PROTOTYPE/P1S_plates/SlimPlate02.3mf
223.4 x 199.4 x 28.0 mm
Side 3U
Base bar x 3
