S-k404/pi5-homelab-rack/01_PRINT_FILES/ALT_UCG_1U_OLED_BLANK_PANEL/UCG_Alt_1U_OLED_Retention_Clamp.step

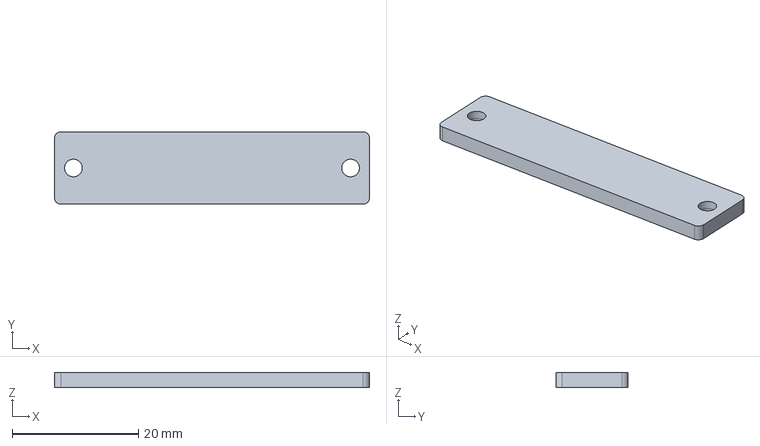
[picture p131: CAD file, 2026-11-01]
01_PRINT_FILES/ALT_UCG_1U_OLED_BLANK_PANEL/UCG_Alt_1U_OLED_Retention_Clamp.step
50.0 x 11.5 x 2.40 mm
