S-k404/pi5-homelab-rack/04_DESIGN_SOURCE/10_Slim_Cargo_Rack_140mm/STL_for_printing/in_rack_coords/cap_R.stl

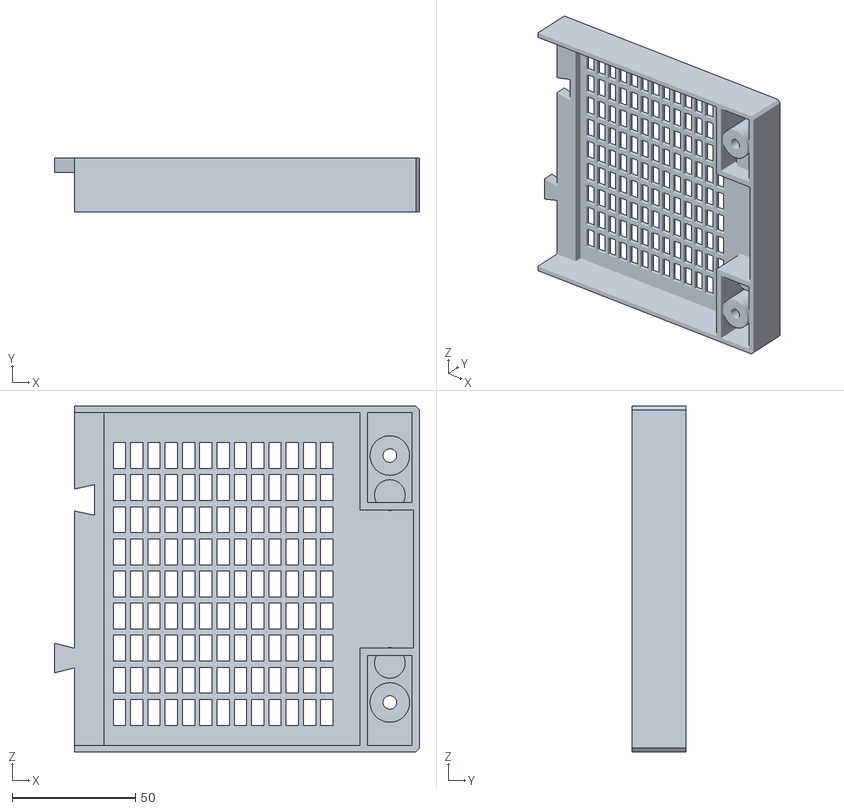
[picture p132: CAD file, 2026-10-28]
04_DESIGN_SOURCE/10_Slim_Cargo_Rack_140mm/STL_for_printing/in_rack_coords/cap_R.stl
147.8 x 22.0 x 140.0
