S-k404/pi5-homelab-rack/04_DESIGN_SOURCE/1_Rack_9U_T0-look/source/Waveshare_7inch_HDMI_LCD_C.step

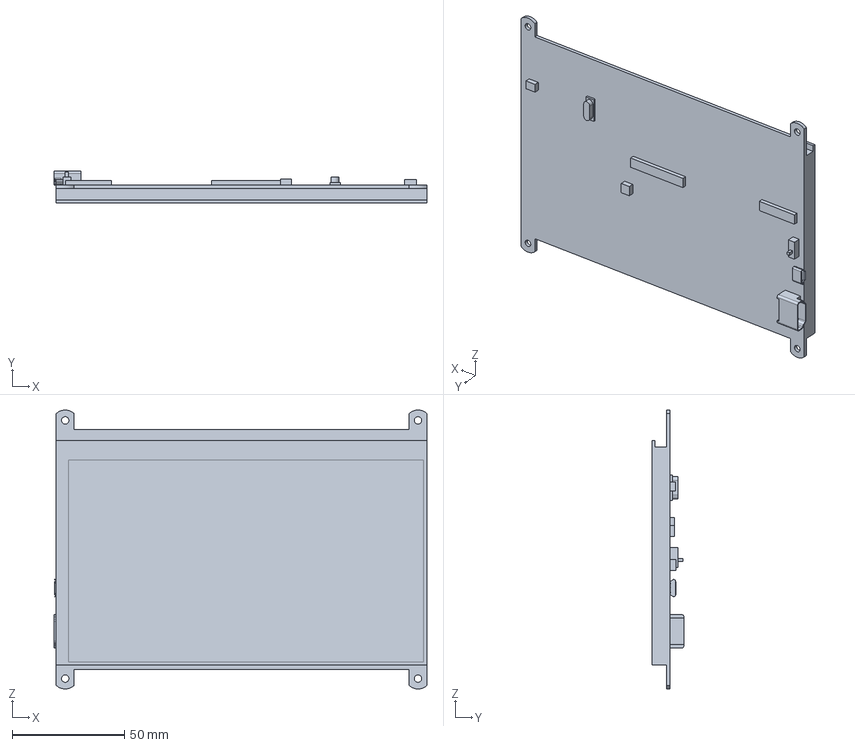
[picture p133: CAD file, 2026-10-28]
04_DESIGN_SOURCE/1_Rack_9U_T0-look/source/Waveshare_7inch_HDMI_LCD_C.step
166.0 x 14.1 x 124.1 mm
