S-k404/pi5-homelab-rack/04_DESIGN_SOURCE/1_Rack_9U_T0-look/STEP_for_Onshape/Rack_SideModule_3U_x4.step

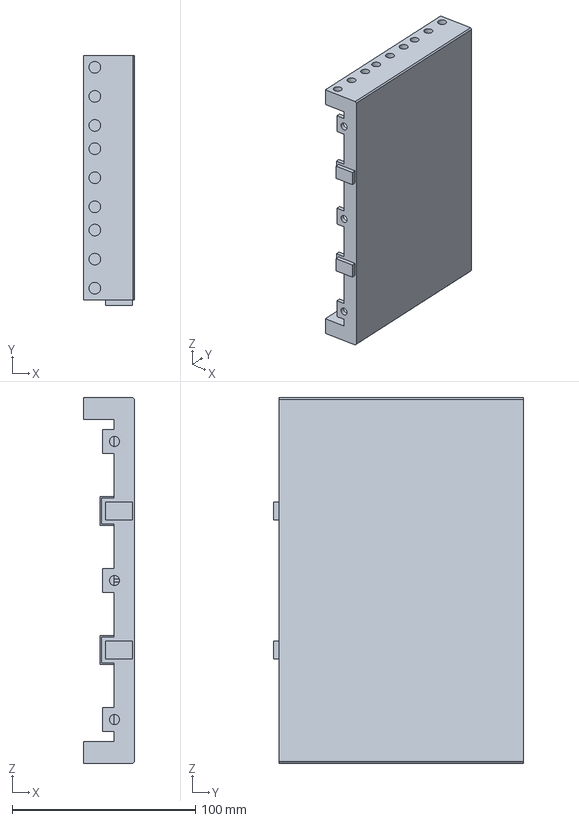
[picture p134: CAD file, 2026-10-28]
04_DESIGN_SOURCE/1_Rack_9U_T0-look/STEP_for_Onshape/Rack_SideModule_3U_x4.step
28.0 x 136.3 x 200.0 mm
