S-k404/pi5-homelab-rack/04_DESIGN_SOURCE/1_Rack_9U_T0-look/STL_for_printing/Rack_Handle_x2.stl

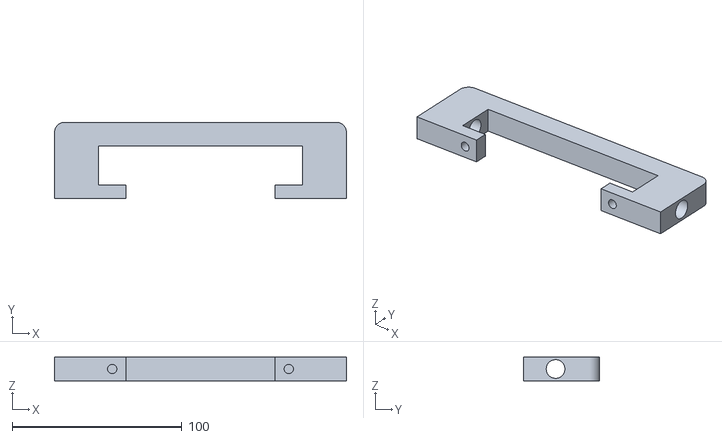
[picture p135: CAD file, 2026-10-28]
04_DESIGN_SOURCE/1_Rack_9U_T0-look/STL_for_printing/Rack_Handle_x2.stl
172.0 x 45.0 x 14.0
