S-k404/pi5-homelab-rack/04_DESIGN_SOURCE/2_B1_Dock_3U/STEP_for_Onshape/B1_Dock_3U_Body.step

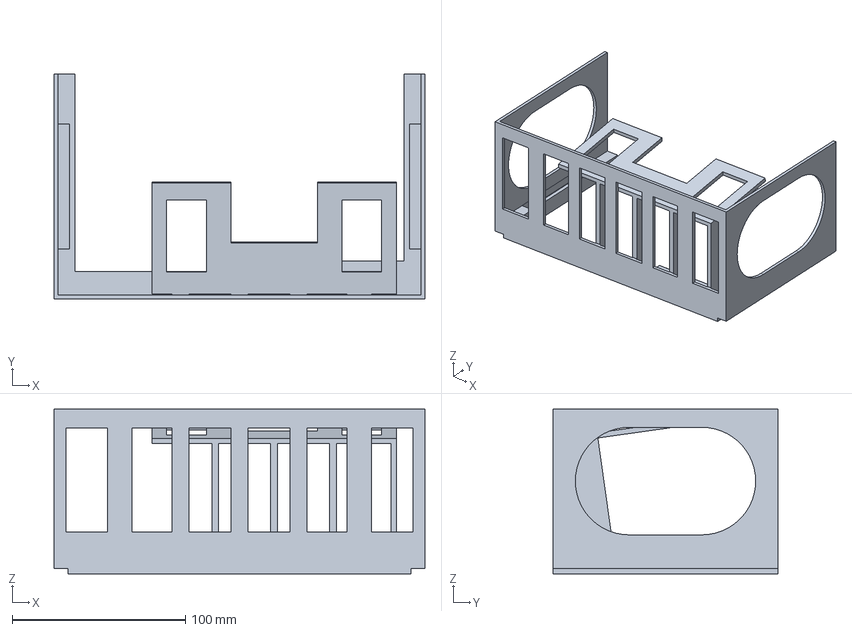
[picture p136: CAD file, 2026-10-28]
04_DESIGN_SOURCE/2_B1_Dock_3U/STEP_for_Onshape/B1_Dock_3U_Body.step
214.0 x 130.0 x 95.0 mm
