S-k404/pi5-homelab-rack/04_DESIGN_SOURCE/2_B1_Dock_3U/STL_for_printing/B1_Dock_3U_Ear_x2.stl

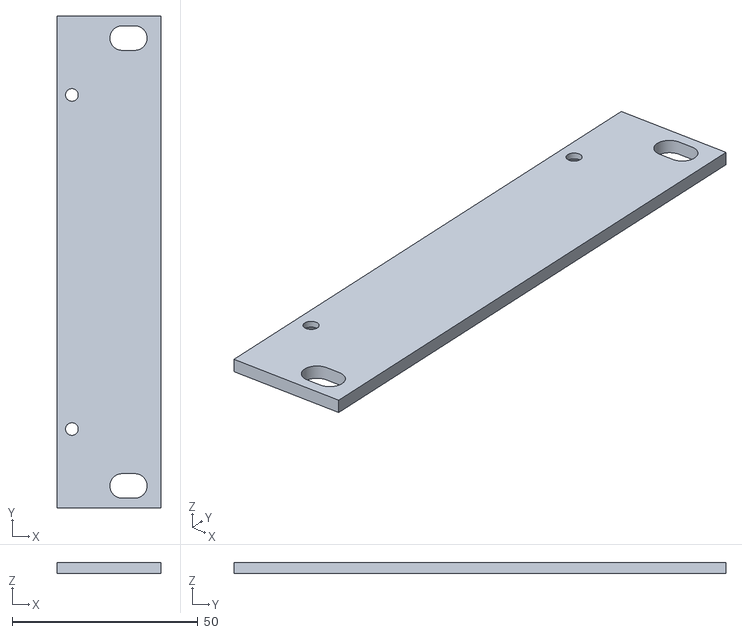
[picture p137: CAD file, 2026-10-28]
04_DESIGN_SOURCE/2_B1_Dock_3U/STL_for_printing/B1_Dock_3U_Ear_x2.stl
28.0 x 132.6 x 3.00
