S-k404/pi5-homelab-rack/04_DESIGN_SOURCE/4_Pi_Unit_2U/Component_Models/UGREEN_20134_HDMI_end.step

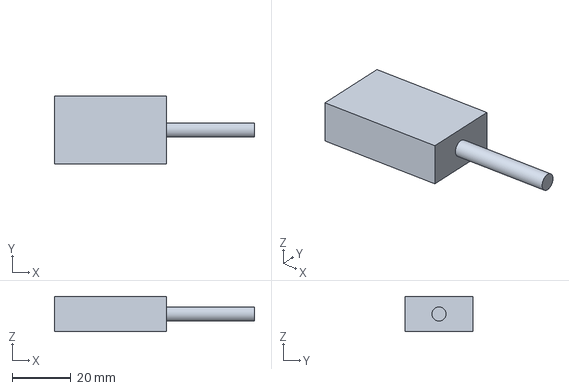
[picture p138: CAD file, 2026-10-28]
04_DESIGN_SOURCE/4_Pi_Unit_2U/Component_Models/UGREEN_20134_HDMI_end.step
68.0 x 23.0 x 12.0 mm
