S-k404/pi5-homelab-rack/04_DESIGN_SOURCE/4_Pi_Unit_2U/STEP_for_Onshape/Rack_Faceplate_2U_10in_clean.step

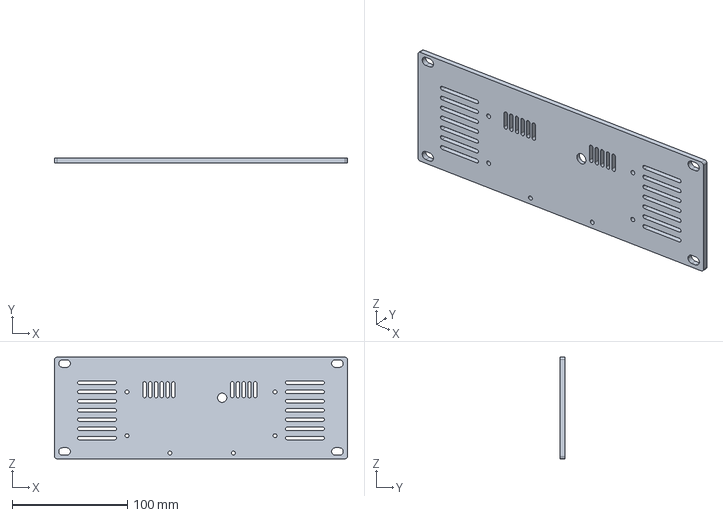
[picture p140: CAD file, 2026-10-28]
04_DESIGN_SOURCE/4_Pi_Unit_2U/STEP_for_Onshape/Rack_Faceplate_2U_10in_clean.step
254.0 x 4.00 x 88.1 mm
