S-k404/pi5-homelab-rack/04_DESIGN_SOURCE/5_UCG-Ultra_1U/STL_for_printing/UCG_Ultra_1U_Shelf.stl

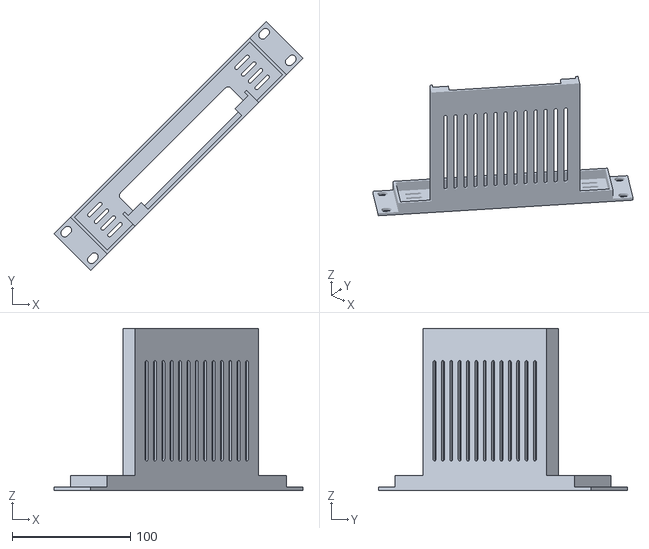
[picture p143: CAD file, 2026-10-28]
04_DESIGN_SOURCE/5_UCG-Ultra_1U/STL_for_printing/UCG_Ultra_1U_Shelf.stl
210.5 x 210.5 x 137.2
