S-k404/pi5-homelab-rack/04_DESIGN_SOURCE/5_UCG-Ultra_1U/UCG_Alt_1U_Blank_OLED_Faceplate.step

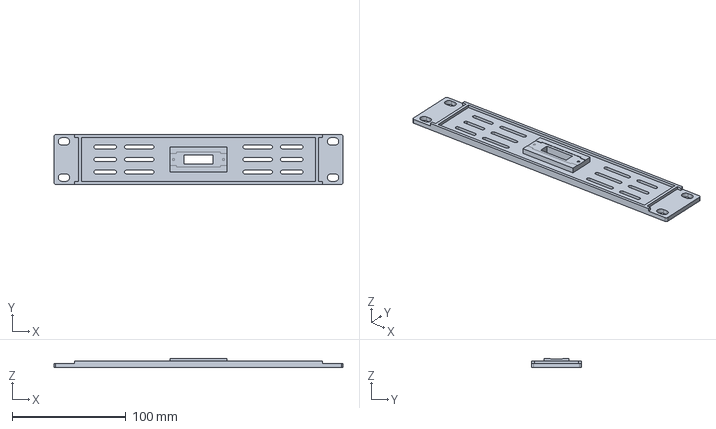
[picture p144: CAD file, 2026-11-01]
04_DESIGN_SOURCE/5_UCG-Ultra_1U/UCG_Alt_1U_Blank_OLED_Faceplate.step
254.0 x 43.6 x 7.75 mm
