S-k404/pi5-homelab-rack/04_DESIGN_SOURCE/6_Brick_Cradle_plate13+DC-notch_faceplate/checks/rack_step_DC-notch/Rack_Faceplate_2U_10in.step

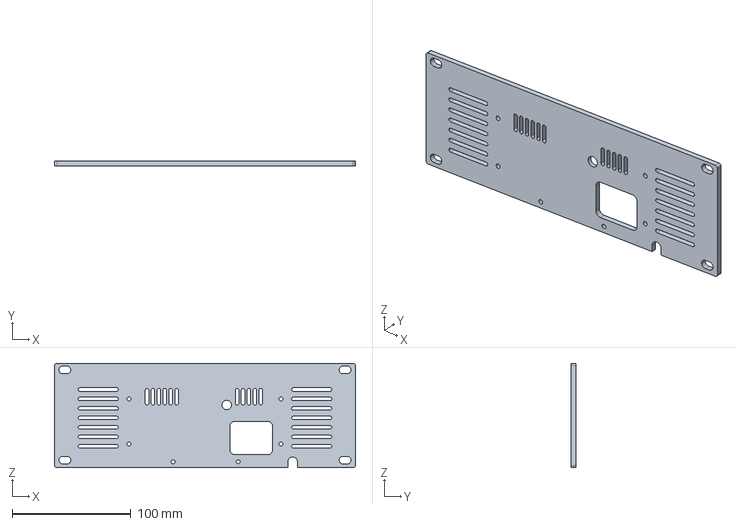
[picture p145: CAD file, 2026-10-28]
04_DESIGN_SOURCE/6_Brick_Cradle_plate13+DC-notch_faceplate/checks/rack_step_DC-notch/Rack_Faceplate_2U_10in.step
254.0 x 4.00 x 88.1 mm
