S-k404/pi5-homelab-rack/04_DESIGN_SOURCE/6_Brick_Cradle_plate13+DC-notch_faceplate/STEP_for_Onshape/Brick_Spacer_4mm.step

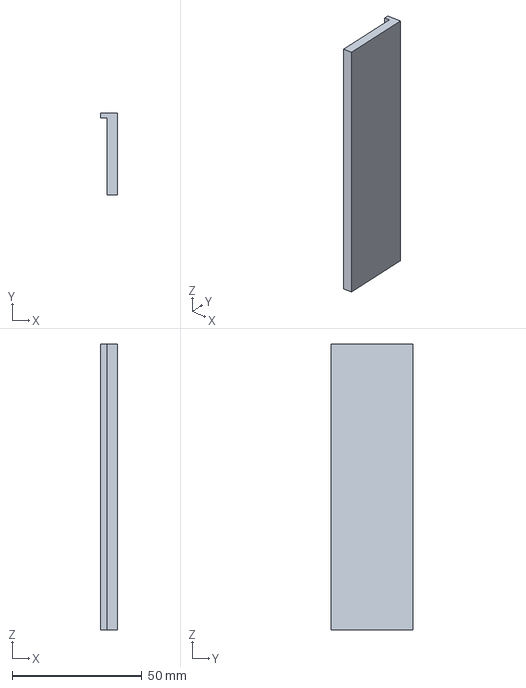
[picture p146: CAD file, 2026-10-28]
04_DESIGN_SOURCE/6_Brick_Cradle_plate13+DC-notch_faceplate/STEP_for_Onshape/Brick_Spacer_4mm.step
6.40 x 31.6 x 110.0 mm
