S-k404/pi5-homelab-rack/04_DESIGN_SOURCE/7_Argon_Poly5_tray+Waveshare_F_holder/11B_PETG_Argon-Poly+5-tray+faceplate_WAIT-measure-case/Plate11B.3mf

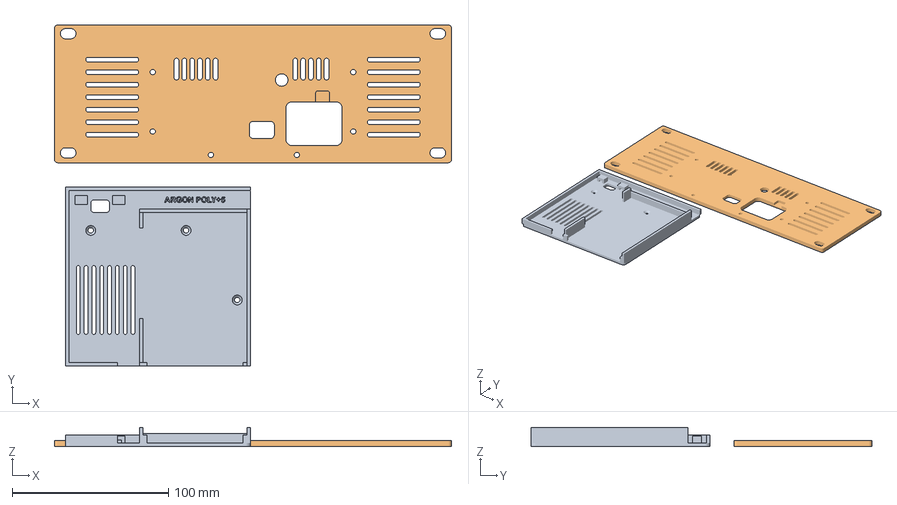
[picture p147: CAD file, 2026-10-28]
04_DESIGN_SOURCE/7_Argon_Poly5_tray+Waveshare_F_holder/11B_PETG_Argon-Poly+5-tray+faceplate_WAIT-measure-case/Plate11B.3mf
254.0 x 218.1 x 12.4 mm
Pi5_ArgonPoly5_tray
Rack_Faceplate_2U_10in_final
