S-k404/pi5-homelab-rack/04_DESIGN_SOURCE/8_UCG_mount_12-ALT2_Printables-942972/12-ALT2_PETG_UCG-Ultra-1U-3-keystones_Printables-942972/Plate12-ALT2.3mf

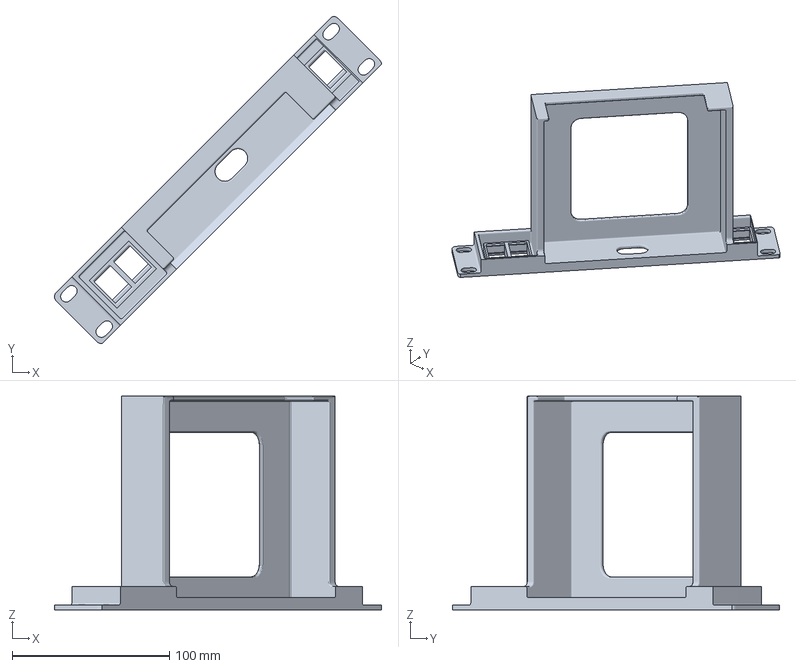
[picture p149: CAD file, 2026-10-28]
04_DESIGN_SOURCE/8_UCG_mount_12-ALT2_Printables-942972/12-ALT2_PETG_UCG-Ultra-1U-3-keystones_Printables-942972/Plate12-ALT2.3mf
208.1 x 208.1 x 136.0 mm
