S-k404/pi5-homelab-rack/04_DESIGN_SOURCE/8_UCG_mount_12-ALT2_Printables-942972/_downloads/UCG_U 10inch rack mount.stl

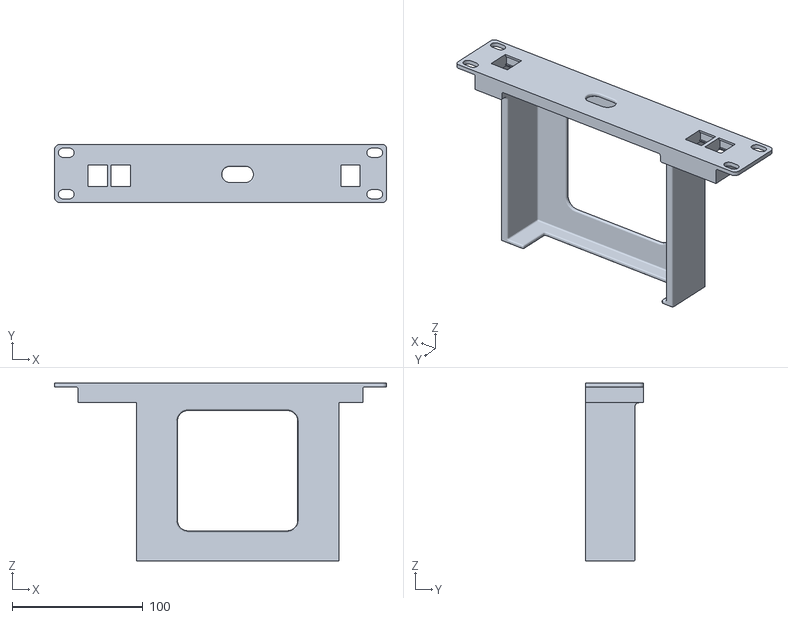
[picture p150: CAD file, 2026-10-28]
04_DESIGN_SOURCE/8_UCG_mount_12-ALT2_Printables-942972/_downloads/UCG_U 10inch rack mount.stl
254.0 x 44.5 x 136.0
