S-k404/pi5-homelab-rack/05_PLATES_250x250_BED/oriented_stls/Display7C_Clip.stl

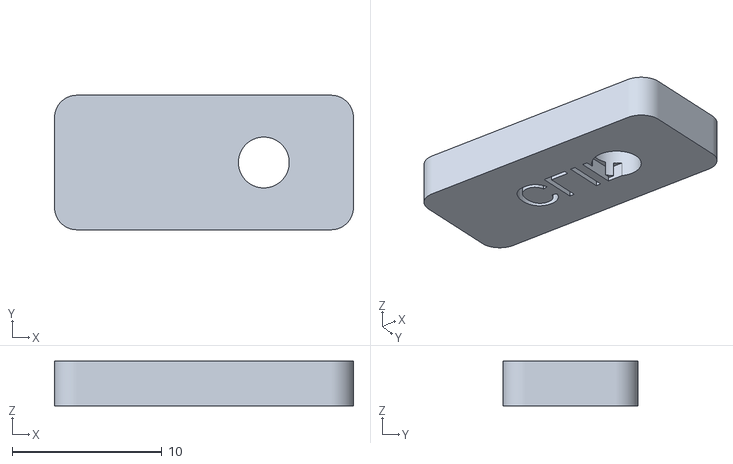
[picture p151: CAD file, 2026-11-01]
05_PLATES_250x250_BED/oriented_stls/Display7C_Clip.stl
20.0 x 9.00 x 3.00
