S-k404/pi5-homelab-rack/05_PLATES_250x250_BED/Plate09_B1_Dock_Body_and_Display_Clips_5_Parts.3mf

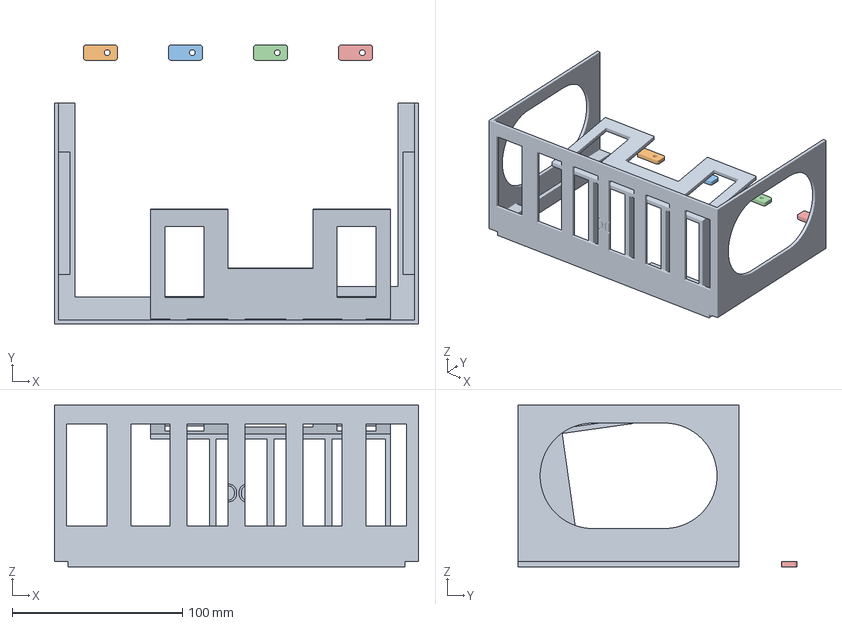
[picture p152: CAD file, 2026-11-01]
05_PLATES_250x250_BED/Plate09_B1_Dock_Body_and_Display_Clips_5_Parts.3mf
214.0 x 164.0 x 95.0 mm
DOCK
CLIP (1/4)
CLIP (2/4)
CLIP (3/4)
CLIP (4/4)
