S-k404/pi5-homelab-rack/Pi5_HomeLab_9U_COMBINED_FOR_ONSHAPE.step

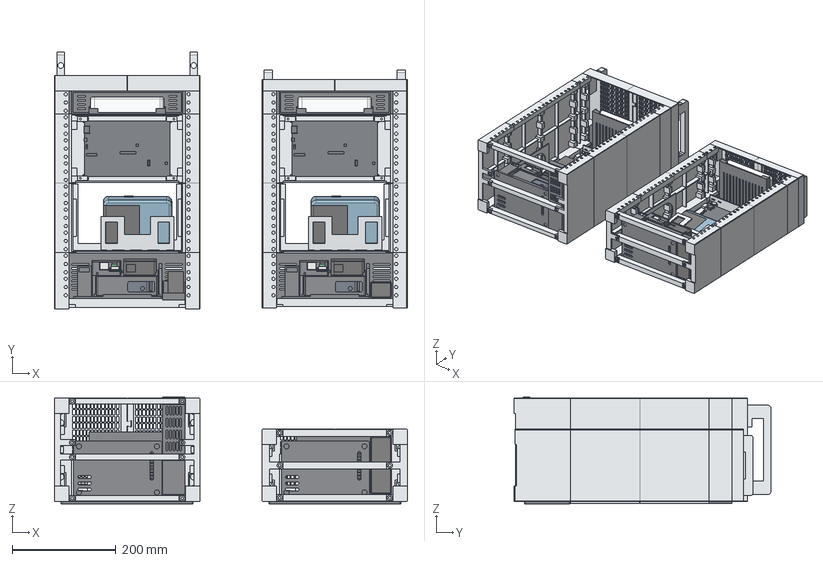
[picture p153: CAD file, 2026-10-28]
Pi5_HomeLab_9U_COMBINED_FOR_ONSHAPE.step
680.0 x 495.1 x 205.4 mm
STD_Rack_side_0_2U_R
STD_Rack_side_0_2U_L
STD_Rack_side_1_3U_R
STD_Rack_side_1_3U_L
STD_Rack_side_2_3U_R
STD_Rack_side_2_3U_L
STD_Rack_side_3_1U_R
STD_Rack_side_3_1U_L
STD_Rack_bar_front
STD_Rack_bar_middle
STD_Rack_bar_rear
STD_Rack_cap_R
STD_Rack_cap_L
STD_Rack_handle_R
STD_Rack_handle_L
STD_UCG_Ultra_1U_Shelf
STD_UniFi_UCG_Ultra_Gateway
STD_Display7C_3U_Body
STD_Display7C_Ear_R
STD_Display7C_Ear_L
STD_Waveshare_7in_LCD
STD_Display7C_Clip_1
STD_Display7C_Clip_2
STD_Display7C_Clip_3
STD_Display7C_Clip_4
STD_B1_Dock_3U_Body
STD_B1_Dock_3U_Ear_R
STD_B1_Dock_3U_Ear_L
STD_NIIMBOT_B1_Body
STD_NIIMBOT_B1_Lid
STD_NIIMBOT_B1_Slide
STD_NIIMBOT_B1_Button
STD_NIIMBOT_B1_LED
STD_Pi5_Rack_Shelf
STD_Pi5_Faceplate_2U_clean
STD_Pi5_UPS_Tray
STD_Cuzor_MiniUPS_Pro_12V3A
STD_Pi5_ArgonPoly5_Tray
STD_Waveshare_F_Holder_Base
STD_Waveshare_F_Holder_Lid
STD_Argon_Poly5_Shell
STD_Argon_Poly5_Top
STD_Waveshare_Adapter_F_PCB
STD_Adapter_F_RJ45_HDMI
STD_Adapter_F_12V_Terminal
STD_EVM_512GB_NVMe_SSD
STD_Brick_Cradle_12V
STD_Brick_Spacer_8mm
STD_Power_Brick_12V_5A
SLIM_Rack_side_0_2U_R
SLIM_Rack_side_0_2U_L
SLIM_Rack_side_1_3U_R
SLIM_Rack_side_1_3U_L
SLIM_Rack_side_2_3U_R
SLIM_Rack_side_2_3U_L
SLIM_Rack_side_3_1U_R
SLIM_Rack_side_3_1U_L
SLIM_Rack_bar_0
SLIM_Rack_bar_1
SLIM_Rack_bar_2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
