S-k404/pi5-homelab-rack/01_PRINT_FILES/1_PRINT-NOW/P1S_plates/Plate02.3mf

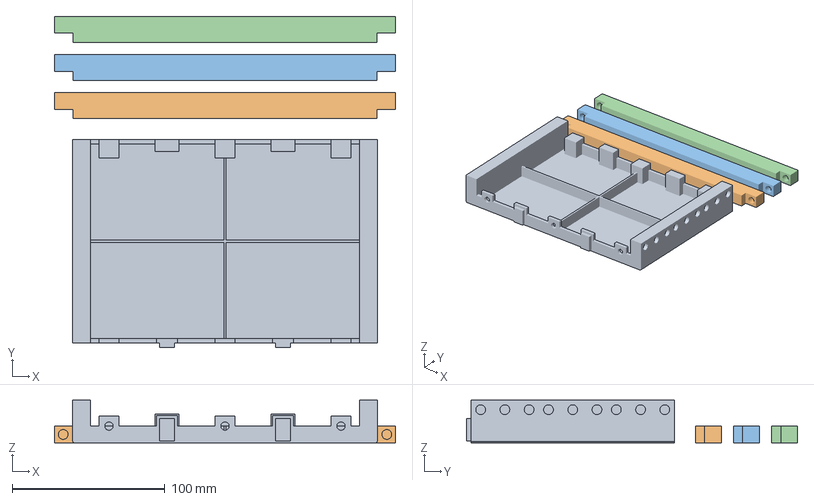
[picture p154: CAD file, 2026-10-28]
01_PRINT_FILES/1_PRINT-NOW/P1S_plates/Plate02.3mf
223.4 x 217.0 x 28.0 mm
Rack_SideModule_3U_x4
Rack_BaseBar_x3_1
Rack_BaseBar_x3_2
Rack_BaseBar_x3_3
