S-k404/pi5-homelab-rack/01_PRINT_FILES/3_WAIT/P1S_plates/Plate09.3mf

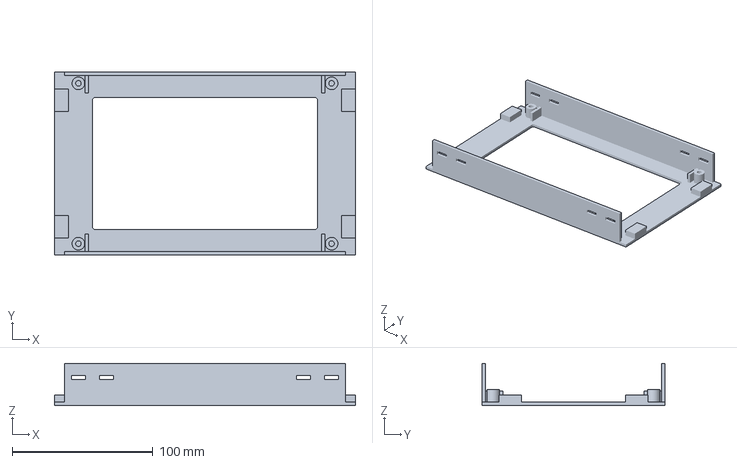
[picture p155: CAD file, 2026-10-28]
01_PRINT_FILES/3_WAIT/P1S_plates/Plate09.3mf
214.0 x 130.0 x 30.0 mm
