S-k404/pi5-homelab-rack/01_PRINT_FILES/5_SLIM_CARGO_140mm_TRAVEL_PROTOTYPE/P1S_plates/SlimPlate03.3mf

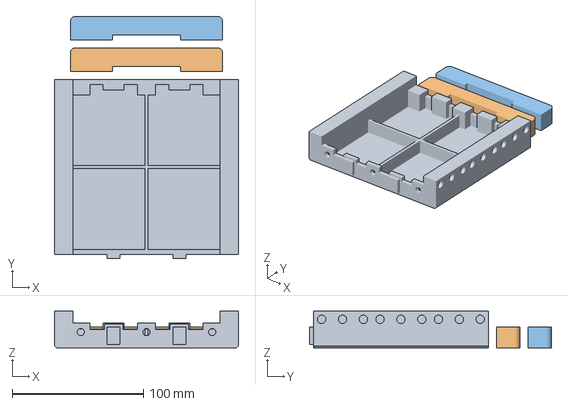
[picture p156: CAD file, 2026-10-28]
01_PRINT_FILES/5_SLIM_CARGO_140mm_TRAVEL_PROTOTYPE/P1S_plates/SlimPlate03.3mf
140.0 x 184.4 x 28.0 mm
Side 3U
Handle x 2
