S-k404/pi5-homelab-rack/04_DESIGN_SOURCE/10_Slim_Cargo_Rack_140mm/STEP_for_Onshape/SlimCargo_SideModule_1U_Top_x2.step

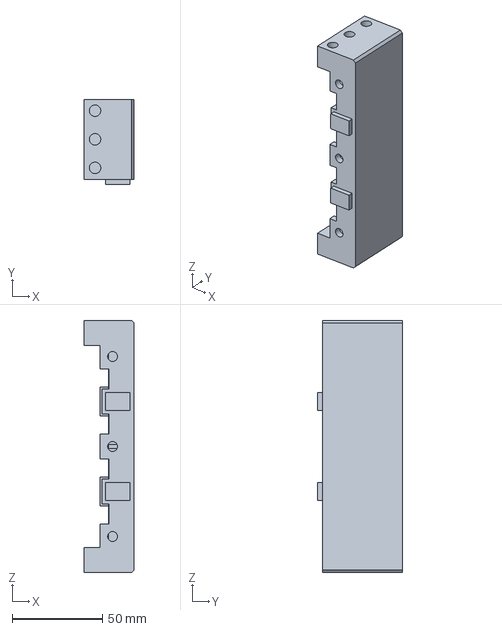
[picture p157: CAD file, 2026-10-28]
04_DESIGN_SOURCE/10_Slim_Cargo_Rack_140mm/STEP_for_Onshape/SlimCargo_SideModule_1U_Top_x2.step
28.0 x 47.5 x 140.0 mm
