S-k404/pi5-homelab-rack/04_DESIGN_SOURCE/10_Slim_Cargo_Rack_140mm/STL_for_printing/in_rack_coords/side_1_3U_L.stl

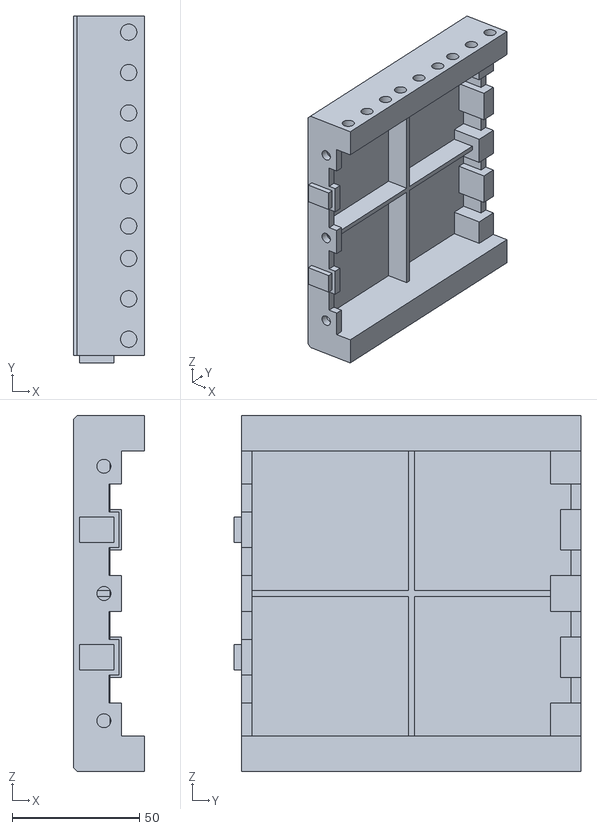
[picture p158: CAD file, 2026-10-28]
04_DESIGN_SOURCE/10_Slim_Cargo_Rack_140mm/STL_for_printing/in_rack_coords/side_1_3U_L.stl
28.0 x 136.3 x 140.0
