S-k404/pi5-homelab-rack/04_DESIGN_SOURCE/1_Rack_9U_T0-look/STL_for_printing/Rack_CapHalf_x2.stl

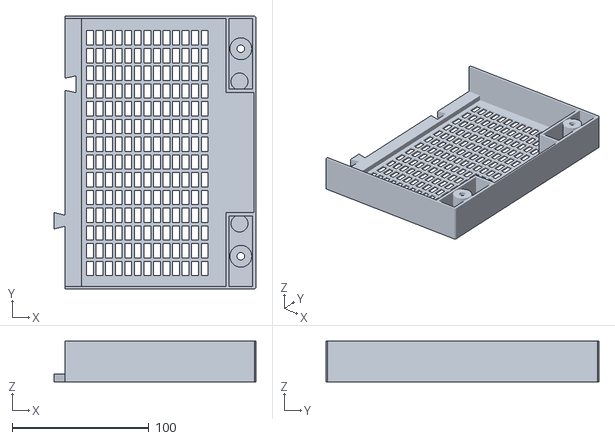
[picture p159: CAD file, 2026-10-28]
04_DESIGN_SOURCE/1_Rack_9U_T0-look/STL_for_printing/Rack_CapHalf_x2.stl
147.8 x 200.0 x 30.0
