S-k404/pi5-homelab-rack/04_DESIGN_SOURCE/3_Display_7in_3U/STEP_for_Onshape/Display7C_Clip_x4.step

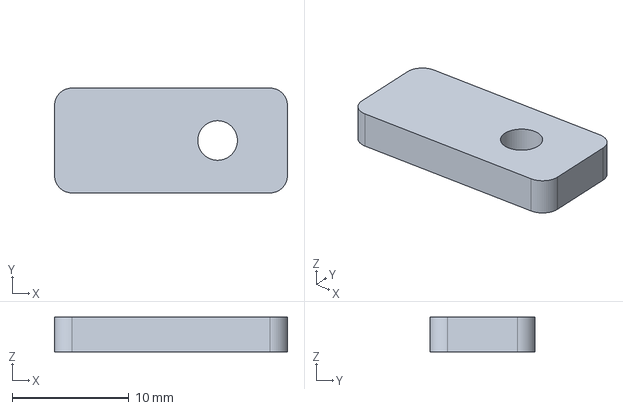
[picture p160: CAD file, 2026-10-28]
04_DESIGN_SOURCE/3_Display_7in_3U/STEP_for_Onshape/Display7C_Clip_x4.step
20.0 x 9.00 x 3.00 mm
