S-k404/pi5-homelab-rack/04_DESIGN_SOURCE/5_UCG-Ultra_1U/UCG_Alt_1U_OLED_Retention_Clamp.step

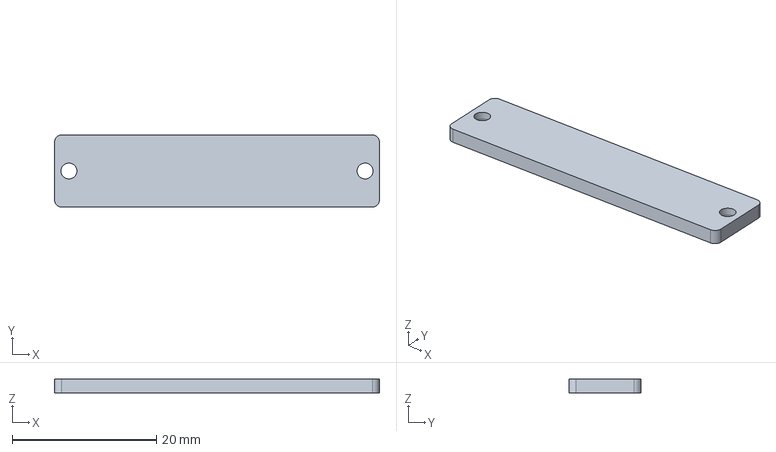
[picture p161: CAD file, 2026-11-01]
04_DESIGN_SOURCE/5_UCG-Ultra_1U/UCG_Alt_1U_OLED_Retention_Clamp.step
45.0 x 10.0 x 2.00 mm
