S-k404/pi5-homelab-rack/04_DESIGN_SOURCE/6_Brick_Cradle_plate13+DC-notch_faceplate/STEP_for_Onshape/Brick_Cradle_12V.step

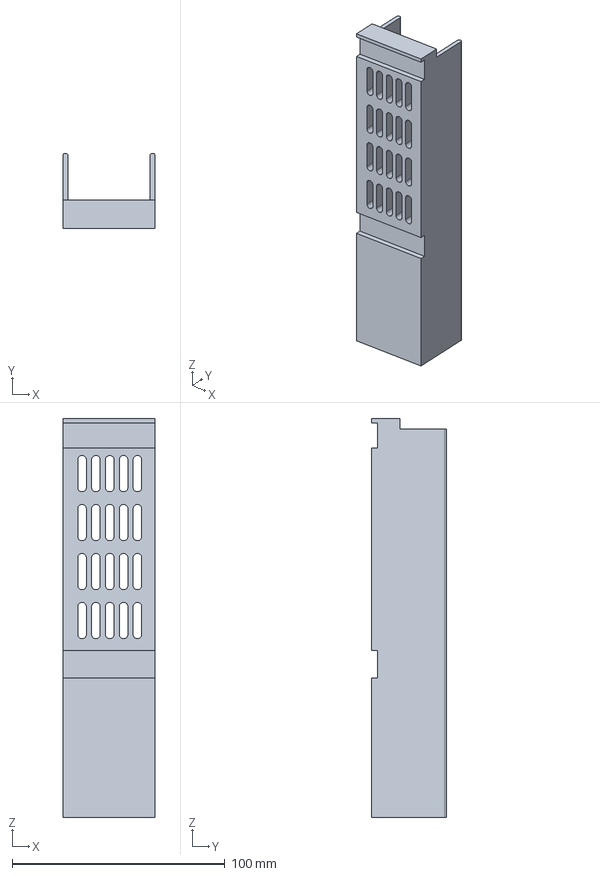
[picture p162: CAD file, 2026-10-28]
04_DESIGN_SOURCE/6_Brick_Cradle_plate13+DC-notch_faceplate/STEP_for_Onshape/Brick_Cradle_12V.step
43.3 x 35.4 x 187.4 mm
