S-k404/pi5-homelab-rack/04_DESIGN_SOURCE/7_Argon_Poly5_tray+Waveshare_F_holder/11A_PETG_Argon-NEO-5-tray+faceplate_WAIT-measure-case/Pi5_ArgonNEO5_tray.stl

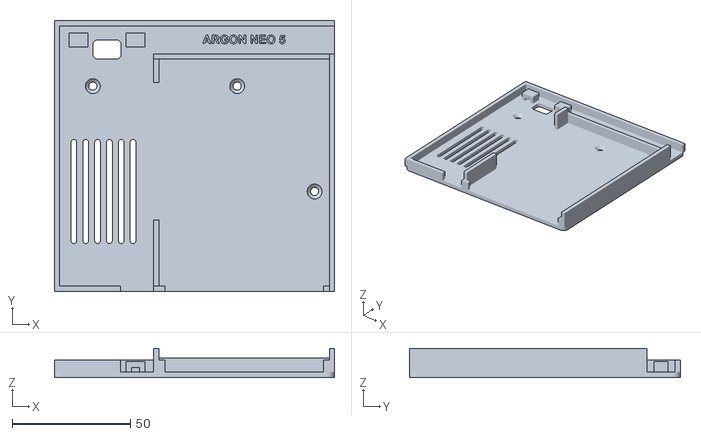
[picture p163: CAD file, 2026-10-28]
04_DESIGN_SOURCE/7_Argon_Poly5_tray+Waveshare_F_holder/11A_PETG_Argon-NEO-5-tray+faceplate_WAIT-measure-case/Pi5_ArgonNEO5_tray.stl
118.3 x 114.4 x 12.4
