S-k404/pi5-homelab-rack/04_DESIGN_SOURCE/7_Argon_Poly5_tray+Waveshare_F_holder/STEP_for_Onshape/Waveshare_F_holder_lid.step

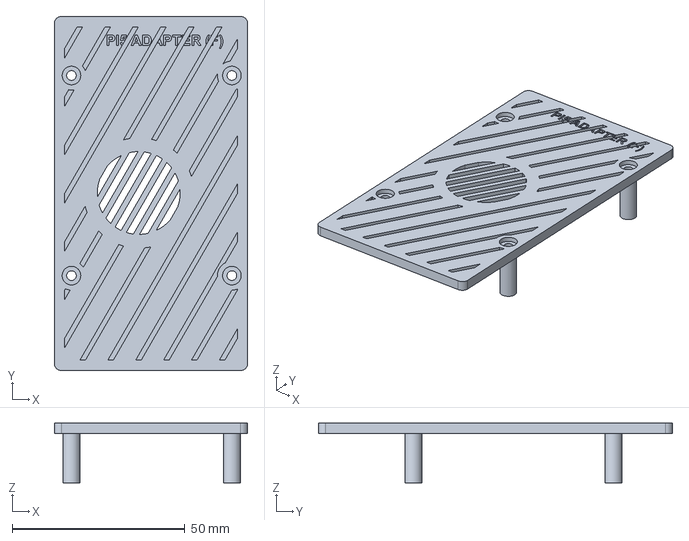
[picture p164: CAD file, 2026-10-28]
04_DESIGN_SOURCE/7_Argon_Poly5_tray+Waveshare_F_holder/STEP_for_Onshape/Waveshare_F_holder_lid.step
56.0 x 102.6 x 17.3 mm
