S-k404/pi5-homelab-rack/05_PLATES_250x250_BED/Plate01_Chassis_2U_Base_and_1U_Top_Modules_4_Parts.3mf

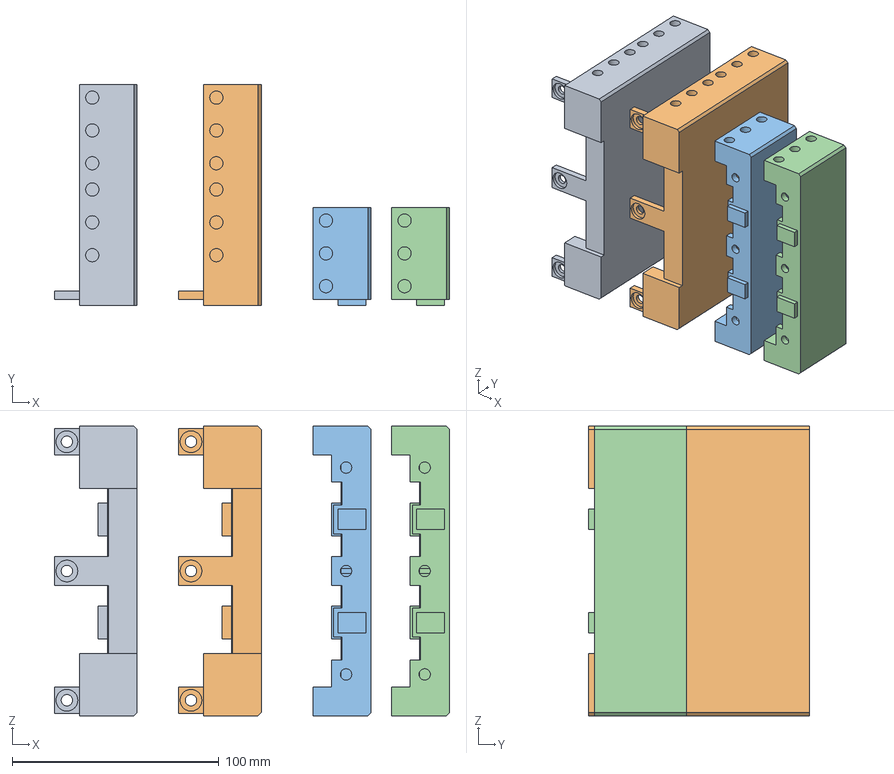
[picture p165: CAD file, 2026-11-01]
05_PLATES_250x250_BED/Plate01_Chassis_2U_Base_and_1U_Top_Modules_4_Parts.3mf
191.0 x 106.9 x 140.0 mm
BASE (1/2)
BASE (2/2)
TOP (1/2)
TOP (2/2)
