S-k404/pi5-homelab-rack/01_PRINT_FILES/4_OPTIONAL_spare-spacers/O3_Brick_Spacer_2mm__x1__PETG__only-if-brick-34.5-36.5mm.stl

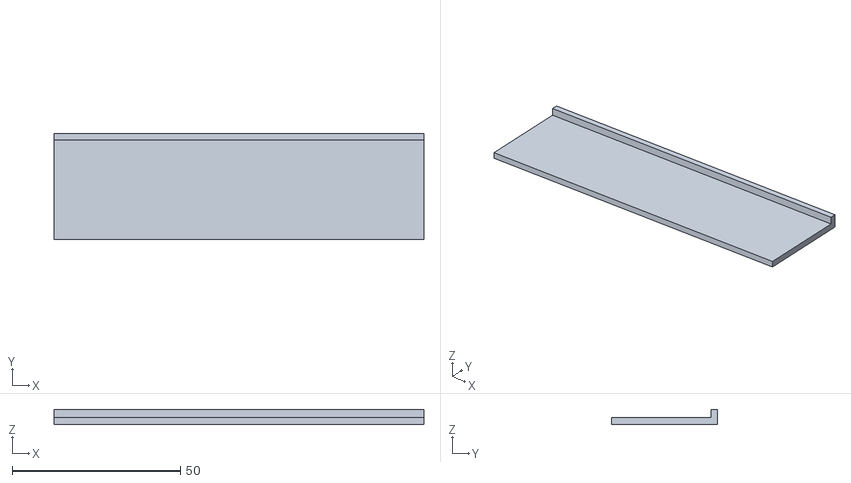
[picture p166: CAD file, 2026-10-28]
01_PRINT_FILES/4_OPTIONAL_spare-spacers/O3_Brick_Spacer_2mm__x1__PETG__only-if-brick-34.5-36.5mm.stl
110.0 x 31.6 x 4.40
