S-k404/pi5-homelab-rack/01_PRINT_FILES/5_SLIM_CARGO_140mm_TRAVEL_PROTOTYPE/P1S_plates/SlimPlate01.3mf

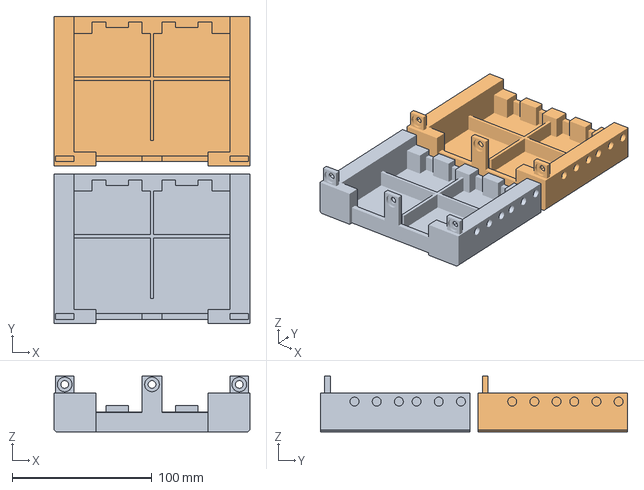
[picture p167: CAD file, 2026-10-28]
01_PRINT_FILES/5_SLIM_CARGO_140mm_TRAVEL_PROTOTYPE/P1S_plates/SlimPlate01.3mf
140.0 x 219.8 x 40.0 mm
Side 2U base x 2
