S-k404/pi5-homelab-rack/04_DESIGN_SOURCE/10_Slim_Cargo_Rack_140mm/STEP_for_Onshape/SlimCargo_SideModule_2U_Base_x2.step

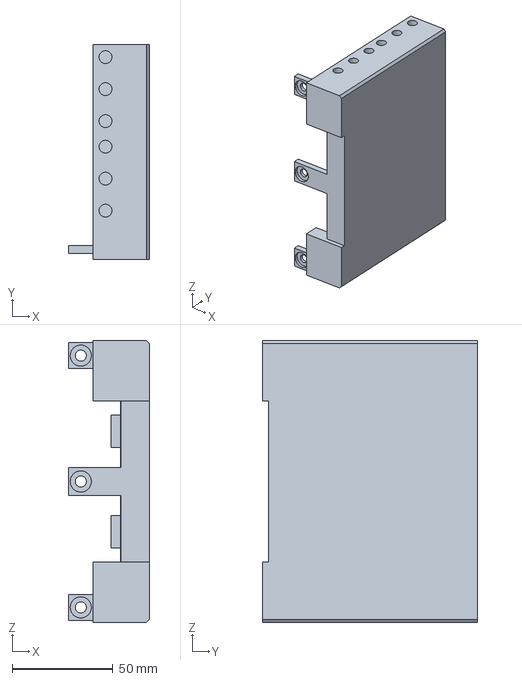
[picture p168: CAD file, 2026-10-28]
04_DESIGN_SOURCE/10_Slim_Cargo_Rack_140mm/STEP_for_Onshape/SlimCargo_SideModule_2U_Base_x2.step
40.0 x 106.9 x 140.0 mm
