S-k404/pi5-homelab-rack/04_DESIGN_SOURCE/10_Slim_Cargo_Rack_140mm/STL_for_printing/in_rack_coords/bar_1.stl

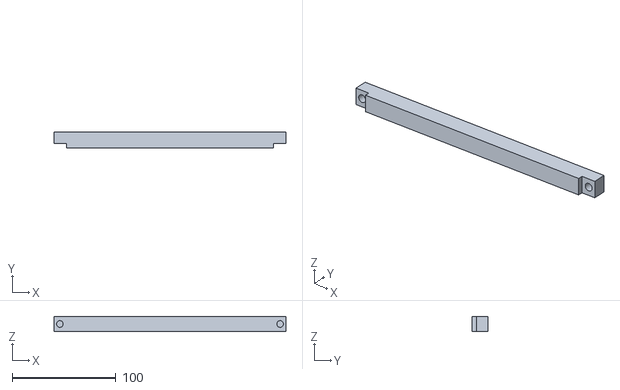
[picture p169: CAD file, 2026-10-28]
04_DESIGN_SOURCE/10_Slim_Cargo_Rack_140mm/STL_for_printing/in_rack_coords/bar_1.stl
223.4 x 15.0 x 14.0
