S-k404/pi5-homelab-rack/04_DESIGN_SOURCE/1_Rack_9U_T0-look/STEP_for_Onshape/Rack_BaseBar_x3.step

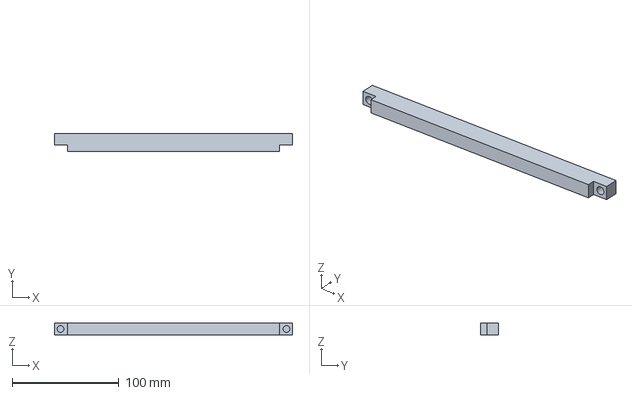
[picture p170: CAD file, 2026-10-28]
04_DESIGN_SOURCE/1_Rack_9U_T0-look/STEP_for_Onshape/Rack_BaseBar_x3.step
223.4 x 17.0 x 11.0 mm
