S-k404/pi5-homelab-rack/04_DESIGN_SOURCE/4_Pi_Unit_2U/Component_Models/GeeekPi_ArmorLite_V5.step

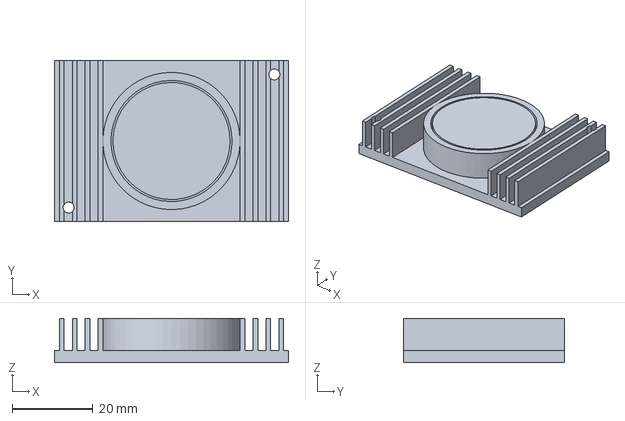
[picture p171: CAD file, 2026-10-28]
04_DESIGN_SOURCE/4_Pi_Unit_2U/Component_Models/GeeekPi_ArmorLite_V5.step
58.0 x 40.0 x 11.0 mm
