S-k404/pi5-homelab-rack/04_DESIGN_SOURCE/4_Pi_Unit_2U/source/original_STEP_25Oct/Rack_Faceplate_Right.step

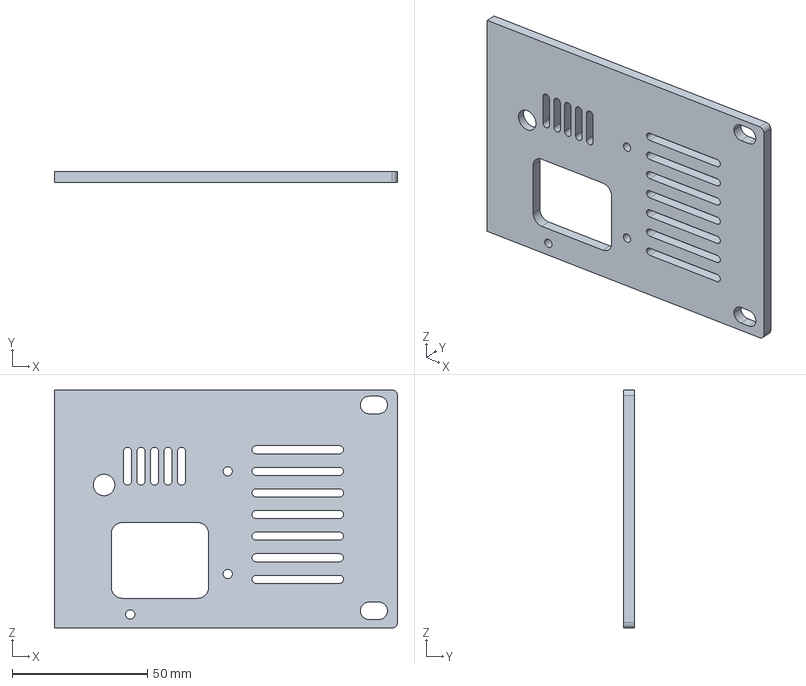
[picture p172: CAD file, 2026-10-28]
04_DESIGN_SOURCE/4_Pi_Unit_2U/source/original_STEP_25Oct/Rack_Faceplate_Right.step
127.0 x 4.00 x 88.1 mm
