S-k404/pi5-homelab-rack/05_PLATES_250x250_BED/Plate10_3U_Unit_Rack_Mount_Ears_4_Parts.3mf

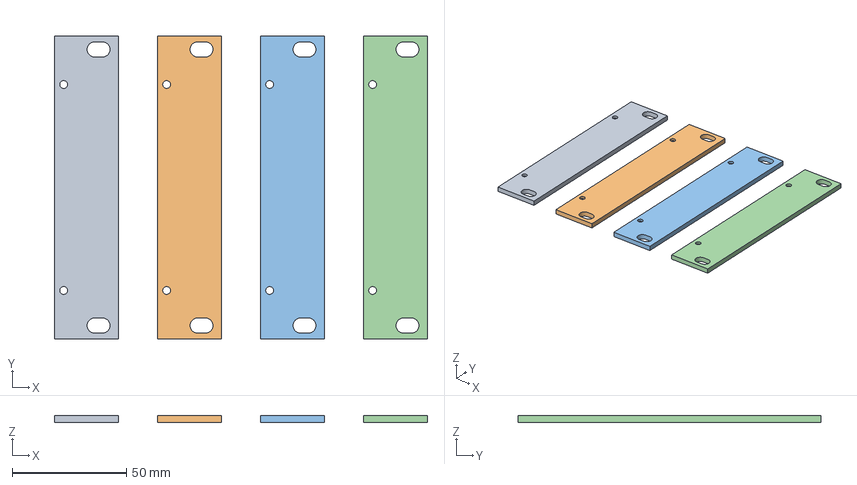
[picture p174: CAD file, 2026-11-01]
05_PLATES_250x250_BED/Plate10_3U_Unit_Rack_Mount_Ears_4_Parts.3mf
163.0 x 132.6 x 3.00 mm
EAR (1/4)
EAR (2/4)
EAR (3/4)
EAR (4/4)
