S-k404/pi5-homelab-rack/01_PRINT_FILES/1_PRINT-NOW/03_Rack_SideModule_1U_Top__x2__PLA.stl

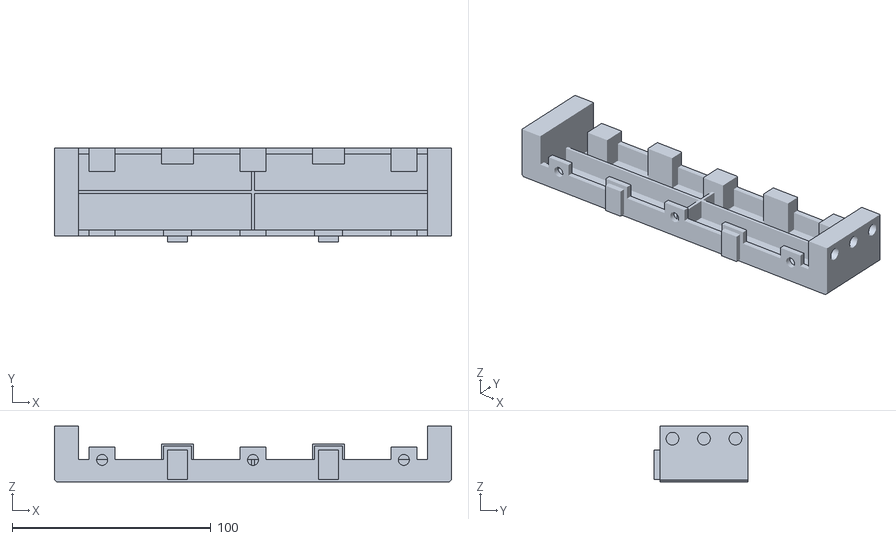
[picture p175: CAD file, 2026-10-28]
01_PRINT_FILES/1_PRINT-NOW/03_Rack_SideModule_1U_Top__x2__PLA.stl
200.0 x 47.5 x 28.0
