S-k404/pi5-homelab-rack/01_PRINT_FILES/1_PRINT-NOW/P1S_plates/Plate06.3mf

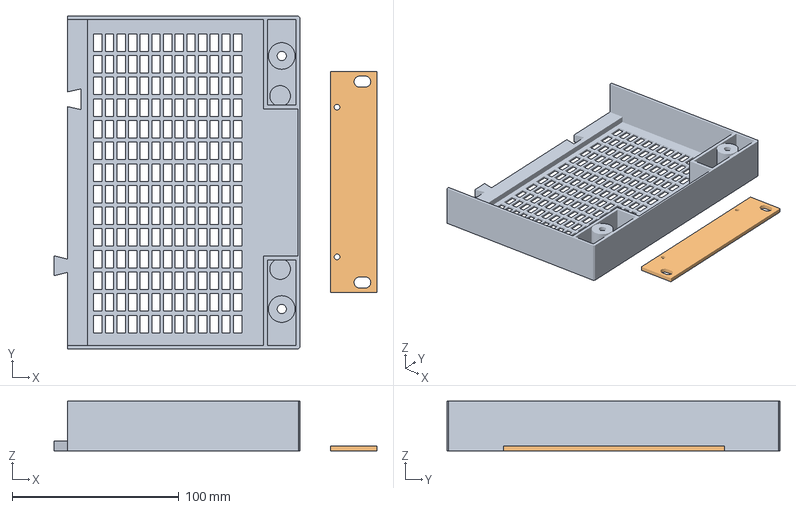
[picture p176: CAD file, 2026-10-28]
01_PRINT_FILES/1_PRINT-NOW/P1S_plates/Plate06.3mf
194.0 x 200.0 x 30.0 mm
Rack_CapHalf_x2
B1_Dock_3U_Ear_x2
