S-k404/pi5-homelab-rack/01_PRINT_FILES/5_SLIM_CARGO_140mm_TRAVEL_PROTOTYPE/P1S_plates/SlimPlate05.3mf

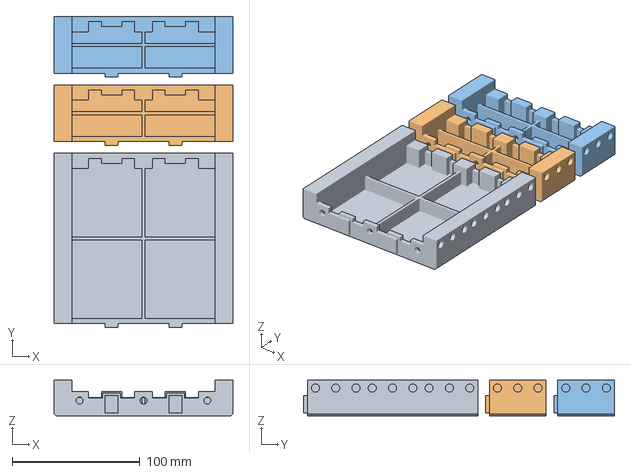
[picture p177: CAD file, 2026-10-28]
01_PRINT_FILES/5_SLIM_CARGO_140mm_TRAVEL_PROTOTYPE/P1S_plates/SlimPlate05.3mf
140.0 x 243.2 x 28.0 mm
Side 3U
Side 1U top x 2
