S-k404/pi5-homelab-rack/04_DESIGN_SOURCE/10_Slim_Cargo_Rack_140mm/STEP_for_Onshape/SlimCargo_BaseBar_x3.step

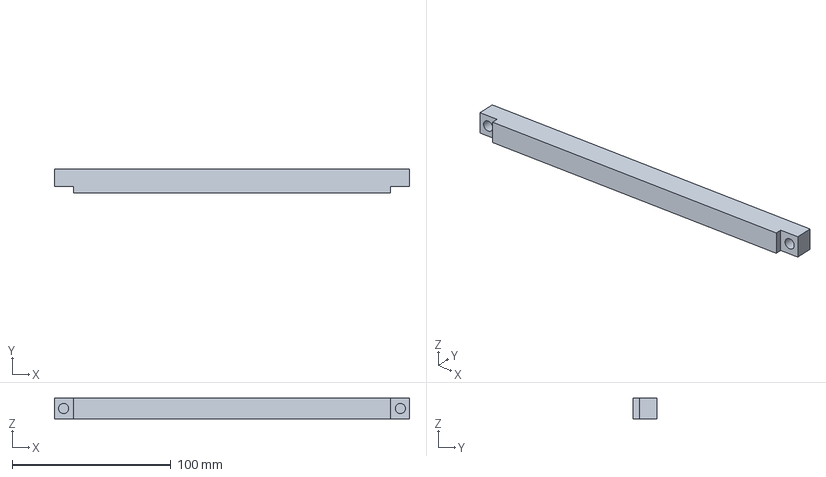
[picture p178: CAD file, 2026-10-28]
04_DESIGN_SOURCE/10_Slim_Cargo_Rack_140mm/STEP_for_Onshape/SlimCargo_BaseBar_x3.step
223.4 x 15.0 x 13.0 mm
