S-k404/pi5-homelab-rack/04_DESIGN_SOURCE/1_Rack_9U_T0-look/STL_for_printing/Rack_BaseBar_x3.stl

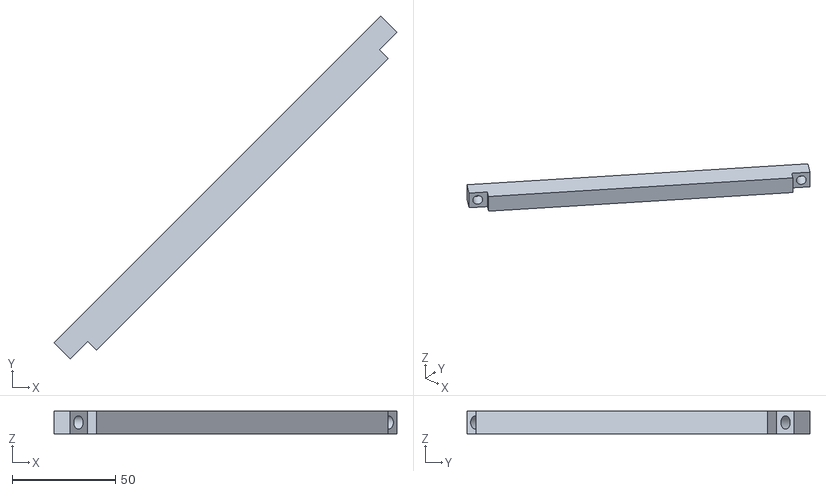
[picture p179: CAD file, 2026-10-28]
04_DESIGN_SOURCE/1_Rack_9U_T0-look/STL_for_printing/Rack_BaseBar_x3.stl
165.7 x 165.7 x 11.0
