S-k404/pi5-homelab-rack/04_DESIGN_SOURCE/4_Pi_Unit_2U/Component_Models/Cuzor_MiniUPS_Pro_12V3A.step

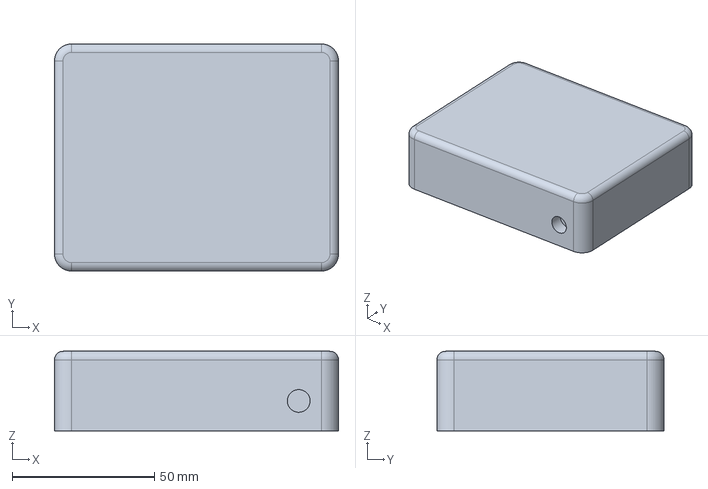
[picture p180: CAD file, 2026-10-28]
04_DESIGN_SOURCE/4_Pi_Unit_2U/Component_Models/Cuzor_MiniUPS_Pro_12V3A.step
100.0 x 80.0 x 28.0 mm
