S-k404/pi5-homelab-rack/04_DESIGN_SOURCE/4_Pi_Unit_2U/source/original_STEP_25Oct/Pi5_UPS_v3_ups_tray.step

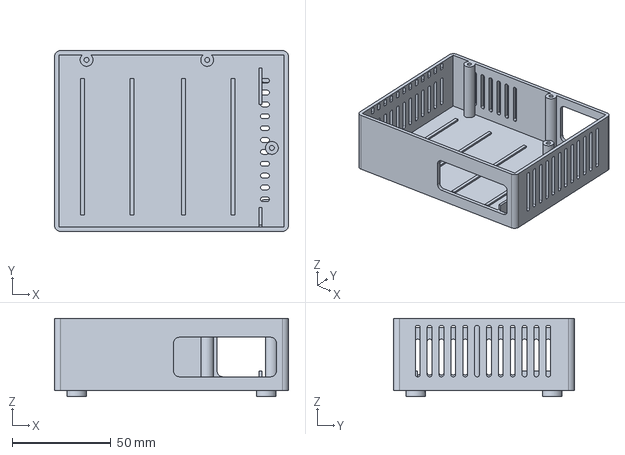
[picture p181: CAD file, 2026-10-28]
04_DESIGN_SOURCE/4_Pi_Unit_2U/source/original_STEP_25Oct/Pi5_UPS_v3_ups_tray.step
118.3 x 91.4 x 39.5 mm
