S-k404/pi5-homelab-rack/05_PLATES_250x250_BED/oriented_stls/Pi_UPS_Tray_pinned.stl

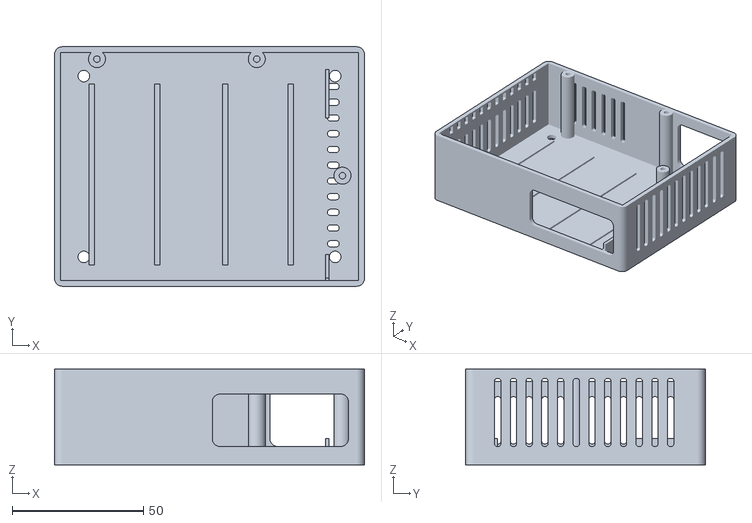
[picture p182: CAD file, 2026-11-01]
05_PLATES_250x250_BED/oriented_stls/Pi_UPS_Tray_pinned.stl
118.3 x 91.4 x 36.5
