S-k404/pi5-homelab-rack/05_PLATES_250x250_BED/Plate06_Argon_Poly+5_Sled_and_Waveshare_Shell_3_Parts.3mf

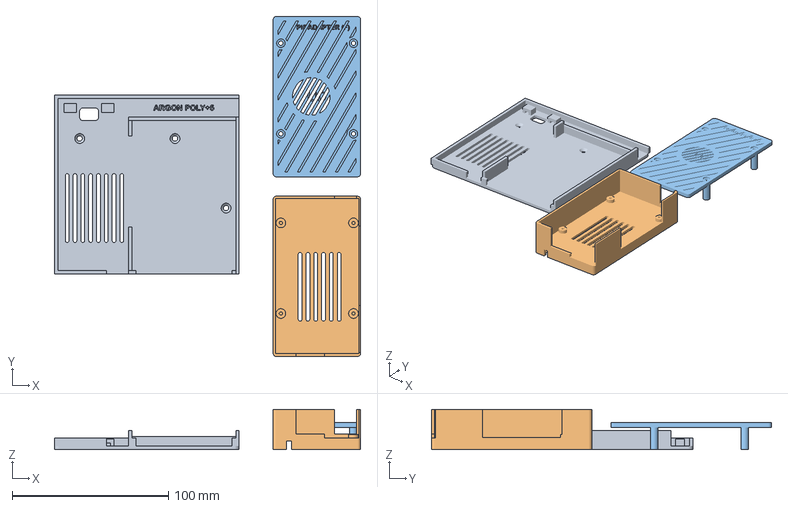
[picture p183: CAD file, 2026-11-01]
05_PLATES_250x250_BED/Plate06_Argon_Poly+5_Sled_and_Waveshare_Shell_3_Parts.3mf
196.0 x 217.6 x 25.8 mm
ARGON
HOLDER
LID
