S-k404/pi5-homelab-rack/01_PRINT_FILES/1_PRINT-NOW/P1S_plates/Plate05.3mf

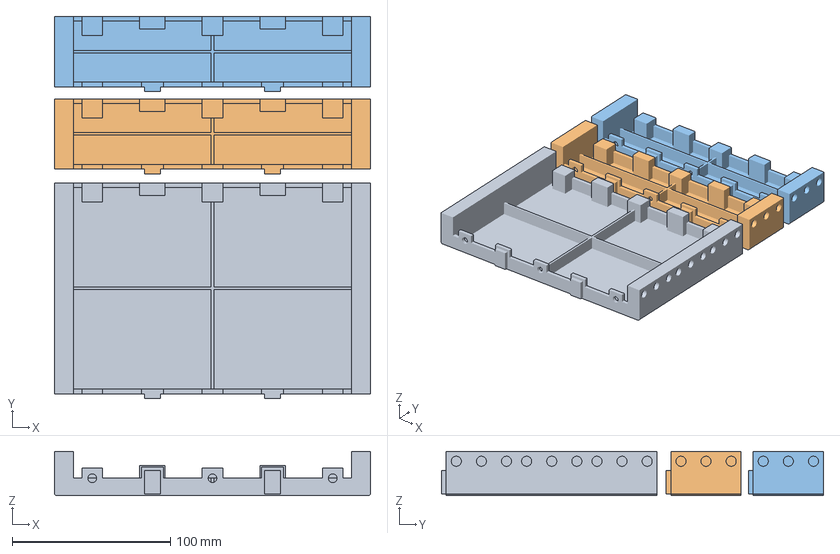
[picture p184: CAD file, 2026-10-28]
01_PRINT_FILES/1_PRINT-NOW/P1S_plates/Plate05.3mf
200.0 x 241.4 x 28.0 mm
Rack_SideModule_3U_x4
Rack_SideModule_1U_Top_x2_1
Rack_SideModule_1U_Top_x2_2
