S-k404/pi5-homelab-rack/01_PRINT_FILES/5_SLIM_CARGO_140mm_TRAVEL_PROTOTYPE/P1S_plates/SlimPlate04.3mf

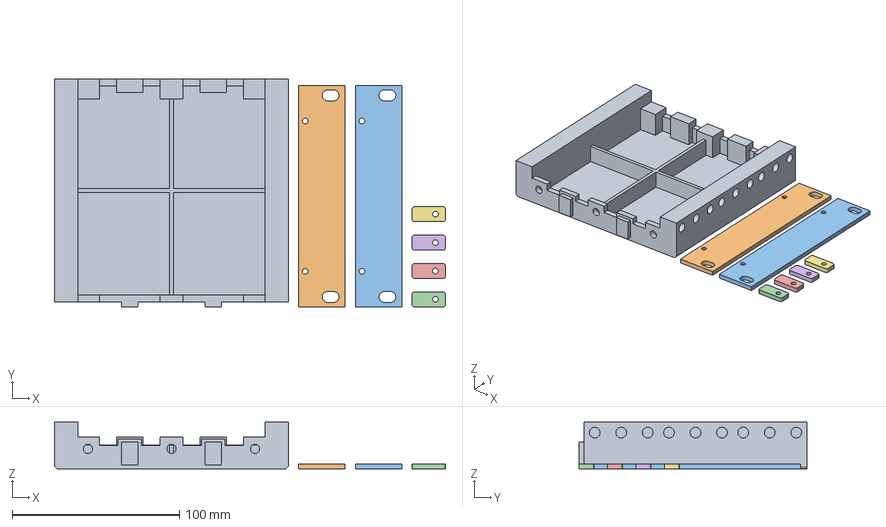
[picture p185: CAD file, 2026-10-28]
01_PRINT_FILES/5_SLIM_CARGO_140mm_TRAVEL_PROTOTYPE/P1S_plates/SlimPlate04.3mf
234.0 x 136.4 x 28.0 mm
Side 3U
Unit ear x 2
Screen clip x 4
