S-k404/pi5-homelab-rack/04_DESIGN_SOURCE/4_Pi_Unit_2U/Component_Models/RaspberryPi5_8GB.step

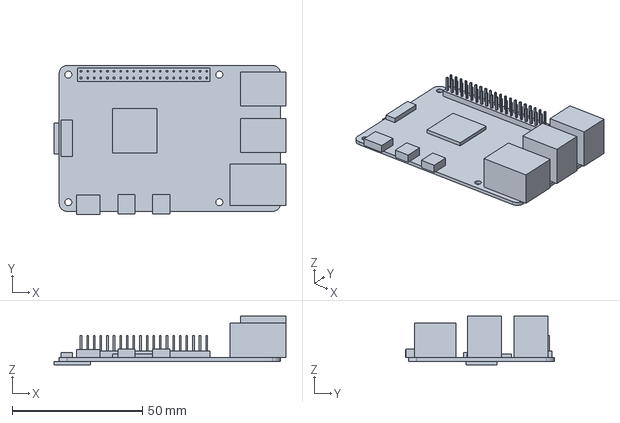
[picture p186: CAD file, 2026-10-28]
04_DESIGN_SOURCE/4_Pi_Unit_2U/Component_Models/RaspberryPi5_8GB.step
89.1 x 57.2 x 18.8 mm
