S-k404/pi5-homelab-rack/04_DESIGN_SOURCE/4_Pi_Unit_2U/STL_for_printing/Pi5_UPS_v3_board_tray_HDMIexit.stl

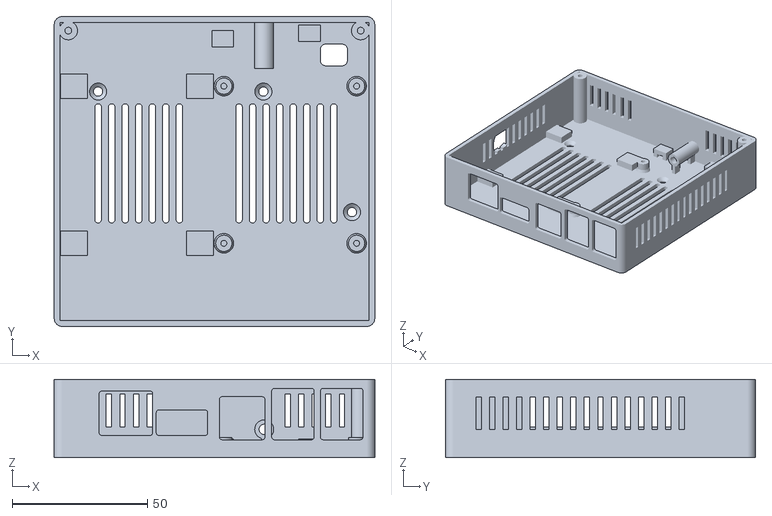
[picture p187: CAD file, 2026-10-28]
04_DESIGN_SOURCE/4_Pi_Unit_2U/STL_for_printing/Pi5_UPS_v3_board_tray_HDMIexit.stl
118.3 x 114.4 x 28.9
