S-k404/pi5-homelab-rack/05_PLATES_250x250_BED/Plate03_Vented_Cap_Half_1,_Handles_and_Base_Bar_4_Parts.3mf

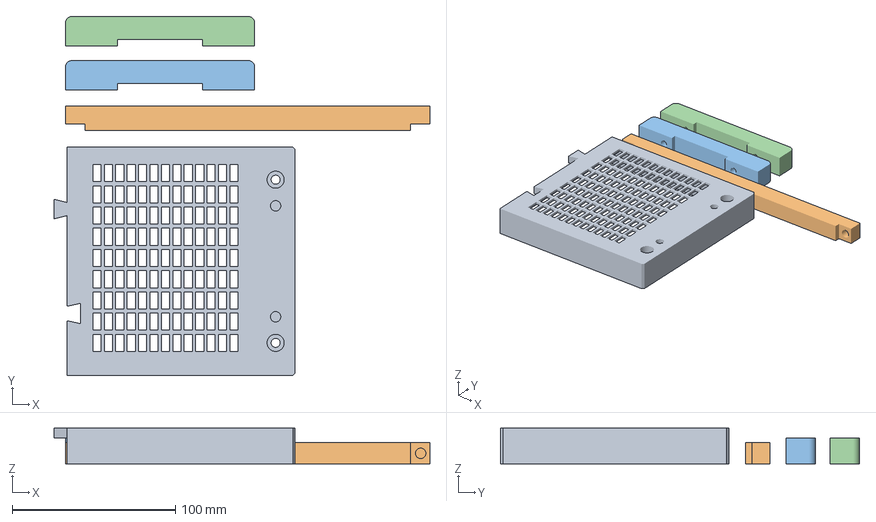
[picture p188: CAD file, 2026-11-01]
05_PLATES_250x250_BED/Plate03_Vented_Cap_Half_1,_Handles_and_Base_Bar_4_Parts.3mf
230.4 x 220.0 x 22.0 mm
CAP (1/2)
BAR (1/3)
HANDLE (1/2)
HANDLE (2/2)
