S-k404/pi5-homelab-rack/ROBU_UPLOAD_SLIM_CARGO/04_ALL_PARTS_STEP_FORMAT/05_[QTY_2]_[PETG_Black_35%]_SlimCargo_LowProfile_Handle.step

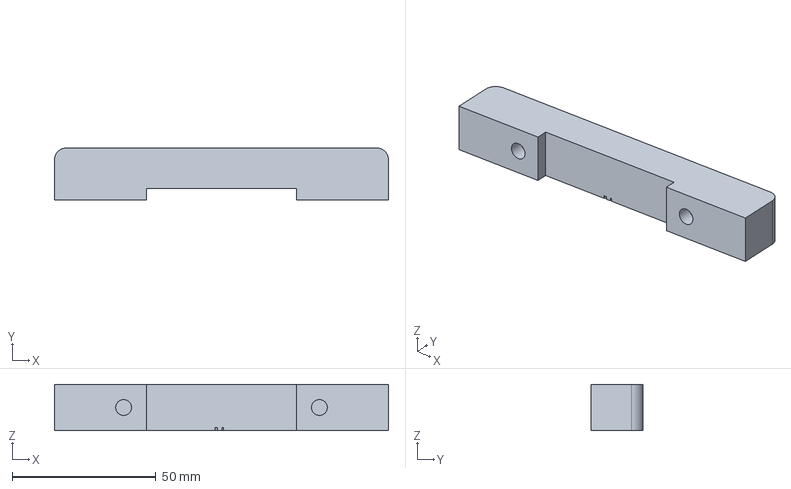
[picture p189: CAD file, 2026-11-01]
ROBU_UPLOAD_SLIM_CARGO/04_ALL_PARTS_STEP_FORMAT/05_[QTY_2]_[PETG_Black_35%]_SlimCargo_LowProfile_Handle.step
116.0 x 18.0 x 16.0 mm
