S-k404/pi5-homelab-rack/01_PRINT_FILES/1_PRINT-NOW/P1S_plates/Plate04.3mf

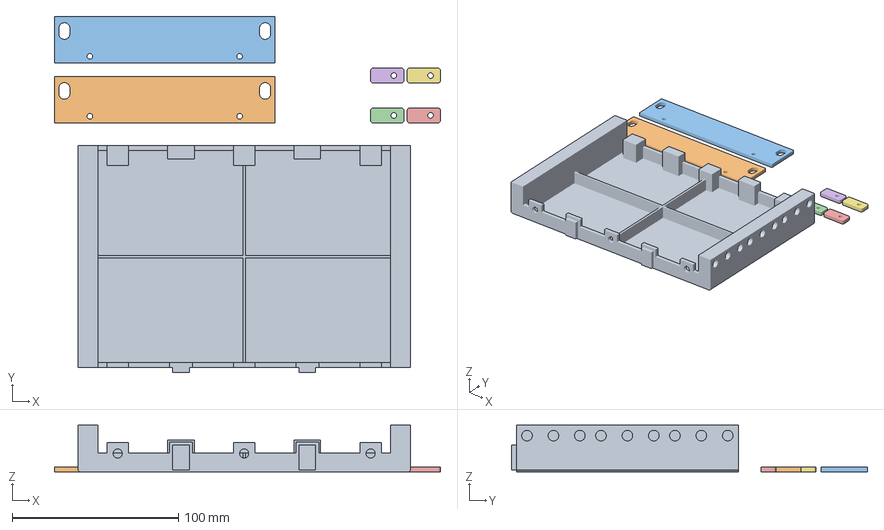
[picture p190: CAD file, 2026-10-28]
01_PRINT_FILES/1_PRINT-NOW/P1S_plates/Plate04.3mf
232.0 x 214.0 x 28.0 mm
Rack_SideModule_3U_x4
B1_Dock_3U_Ear_x2_1
B1_Dock_3U_Ear_x2_2
Display7C_Clip_x4_1
Display7C_Clip_x4_2
Display7C_Clip_x4_3
Display7C_Clip_x4_4
