S-k404/pi5-homelab-rack/(list of files, cad)

Other CAD files:
04_DESIGN_SOURCE/6_Brick_Cradle_plate13+DC-notch_faceplate/STL_for_printing/Rack_Faceplate_2U_10in_DC-notch.stl
04_DESIGN_SOURCE/7_Argon_Poly5_tray+Waveshare_F_holder/11A_PETG_Argon-NEO-5-tray+faceplate_WAIT-measure-case/Rack_Faceplate_2U_10in.stl
ROBU_UPLOAD_SLIM_CARGO/01_NEW_AND_REPLACED_PARTS/08_[QTY_1]_[PETG_Black_20%]_REPLACE_FACEPLATE_C2_Pi_Faceplate_2U_clean.stl
ROBU_UPLOAD_SLIM_CARGO/02_ALL_PARTS_FRESH_ORDER/08_[QTY_1]_[PETG_Black_20%]_REPLACE_FACEPLATE_C2_Pi_Faceplate_2U_clean.stl
ROBU_UPLOAD_SLIM_CARGO/04_ALL_PARTS_STEP_FORMAT/11_[QTY_1]_[PETG_Black_20%]_Waveshare_F_Holder_Base.step
01_PRINT_FILES/4_OPTIONAL_spare-spacers/O2_Brick_Spacer_4mm__x1__PETG__only-if-brick-32.5-34.5mm.stl
01_PRINT_FILES/ALT_UCG_1U_OLED_BLANK_PANEL/UCG_Alt_1U_Blank_OLED_Faceplate.step
04_DESIGN_SOURCE/1_Rack_9U_T0-look/STEP_for_Onshape/Rack_Handle_x2.step
04_DESIGN_SOURCE/2_B1_Dock_3U/STEP_for_Onshape/B1_Dock_3U_Ear_x2.step
04_DESIGN_SOURCE/4_Pi_Unit_2U/source/original_STEP_25Oct/Pi5_UPS_v3_lid.step
04_DESIGN_SOURCE/4_Pi_Unit_2U/STEP_for_Onshape/Rack_Shelf_pinned.step
04_DESIGN_SOURCE/4_Pi_Unit_2U/STL_for_printing/Rack_Faceplate_2U_10in.stl
04_DESIGN_SOURCE/6_Brick_Cradle_plate13+DC-notch_faceplate/checks/rack_step_DC-notch/Rack_Faceplate_Left.step
04_DESIGN_SOURCE/6_Brick_Cradle_plate13+DC-notch_faceplate/STL_for_printing/Brick_Cradle_12V.stl
04_DESIGN_SOURCE/7_Argon_Poly5_tray+Waveshare_F_holder/11B_PETG_Argon-Poly+5-tray+faceplate_WAIT-measure-case/Rack_Faceplate_2U_10in_final.stl
05_PLATES_250x250_BED/oriented_stls/SlimCargo_SideModule_3U.stl
ROBU_UPLOAD_SLIM_CARGO/01_NEW_AND_REPLACED_PARTS/07_[QTY_1]_[PETG_Black_20%]_REPLACE_SHELF_10_Pi_Rack_Shelf_pinned.stl
ROBU_UPLOAD_SLIM_CARGO/02_ALL_PARTS_FRESH_ORDER/09_[QTY_1]_[PETG_Black_20%]_REPLACE_HOLDER_BASE_W2_Waveshare_F_Holder_Base.stl
ROBU_UPLOAD_SLIM_CARGO/03_OPTIONAL_ALTERNATIVE_1U_OLED_PANEL/14_ALT_[QTY_1]_[PETG_Black_20%]_1U_Blank_OLED_Faceplate.stl
ROBU_UPLOAD_SLIM_CARGO/04_ALL_PARTS_STEP_FORMAT/13_[QTY_1]_[PLA_Silver_15%]_B1_Dock_v5_Body.step
01_PRINT_FILES/1_PRINT-NOW/02_Rack_SideModule_3U__x4__PLA.stl
01_PRINT_FILES/1_PRINT-NOW/P1S_plates/Plate08.3mf
04_DESIGN_SOURCE/4_Pi_Unit_2U/STEP_for_Onshape/Pi5_UPS_v3_lid.step
04_DESIGN_SOURCE/4_Pi_Unit_2U/STL_for_printing/Rack_Faceplate_Right.stl
04_DESIGN_SOURCE/6_Brick_Cradle_plate13+DC-notch_faceplate/checks/rack_step_DC-notch/Rack_Shelf_pinned.step
04_DESIGN_SOURCE/7_Argon_Poly5_tray+Waveshare_F_holder/11A_PETG_Argon-NEO-5-tray+faceplate_WAIT-measure-case/Plate11A.3mf
04_DESIGN_SOURCE/7_Argon_Poly5_tray+Waveshare_F_holder/STEP_for_Onshape/Pi5_ArgonNEO5_tray.step
04_DESIGN_SOURCE/ONSHAPE_PROJECT/INDIVIDUAL_STEP_PARTS/06_PI5_Rack_Shelf_pinned.step
05_PLATES_250x250_BED/oriented_stls/SlimCargo_SideModule_2U_Base.stl
ROBU_UPLOAD_SLIM_CARGO/01_NEW_AND_REPLACED_PARTS/09_[QTY_1]_[PETG_Black_20%]_REPLACE_HOLDER_BASE_W2_Waveshare_F_Holder_Base.stl
ROBU_UPLOAD_SLIM_CARGO/02_ALL_PARTS_FRESH_ORDER/07_[QTY_1]_[PETG_Black_20%]_REPLACE_SHELF_10_Pi_Rack_Shelf_pinned.stl
ROBU_UPLOAD_SLIM_CARGO/03_OPTIONAL_ALTERNATIVE_1U_OLED_PANEL/UCG_Alt_1U_Blank_OLED_Faceplate.step
ROBU_UPLOAD_SLIM_CARGO/04_ALL_PARTS_STEP_FORMAT/01_[QTY_2]_[PETG_Black_25%]_SlimCargo_SideModule_2U_Base.step
04_DESIGN_SOURCE/10_Slim_Cargo_Rack_140mm/STL_for_printing/in_rack_coords/cap_L.stl
04_DESIGN_SOURCE/1_Rack_9U_T0-look/STEP_for_Onshape/Rack_SideModule_1U_Top_x2.step
04_DESIGN_SOURCE/4_Pi_Unit_2U/STEP_for_Onshape/Rack_Faceplate_2U_10in.step
04_DESIGN_SOURCE/4_Pi_Unit_2U/STL_for_printing/Rack_Faceplate_Left.stl
04_DESIGN_SOURCE/6_Brick_Cradle_plate13+DC-notch_faceplate/checks/rack_step_DC-notch/Pi5_UPS_v3_lid.step
04_DESIGN_SOURCE/6_Brick_Cradle_plate13+DC-notch_faceplate/STL_for_printing/Brick_Spacer_8mm.stl
04_DESIGN_SOURCE/7_Argon_Poly5_tray+Waveshare_F_holder/STEP_for_Onshape/Pi5_ArgonPoly5_tray.step
04_DESIGN_SOURCE/ONSHAPE_PROJECT/INDIVIDUAL_STEP_PARTS/01_RACK_Handle_x2.step
04_DESIGN_SOURCE/ONSHAPE_PROJECT/Pi5_HomeLab_9U_SingleBody_Compound_STUDIO.step
ROBU_UPLOAD_SLIM_CARGO/01_NEW_AND_REPLACED_PARTS/04_[QTY_2]_[PETG_Black_20%]_SlimCargo_CapHalf.stl
ROBU_UPLOAD_SLIM_CARGO/02_ALL_PARTS_FRESH_ORDER/11_[QTY_4]_[PLA_Silver_30%]_Display7C_Clip.stl
ROBU_UPLOAD_SLIM_CARGO/03_OPTIONAL_ALTERNATIVE_1U_OLED_PANEL/14_ALT_[QTY_1]_[PETG_Black_20%]_1U_OLED_Retention_Clamp.stl
ROBU_UPLOAD_SLIM_CARGO/04_ALL_PARTS_STEP_FORMAT/04_[QTY_2]_[PETG_Black_20%]_SlimCargo_CapHalf.step
01_PRINT_FILES/1_PRINT-NOW/11_Brick_Cradle_12V__x1__PETG.stl
04_DESIGN_SOURCE/10_Slim_Cargo_Rack_140mm/STEP_for_Onshape/SlimCargo_CapHalf_x2.step
04_DESIGN_SOURCE/10_Slim_Cargo_Rack_140mm/STL_for_printing/in_rack_coords/side_2_3U_R.stl
04_DESIGN_SOURCE/1_Rack_9U_T0-look/STEP_for_Onshape/Rack_CapHalf_x2.step
04_DESIGN_SOURCE/1_Rack_9U_T0-look/STL_for_printing/Rack_SideModule_3U_x4.stl
04_DESIGN_SOURCE/4_Pi_Unit_2U/source/original_STEP_25Oct/Rack_Faceplate_2U_10in.step
04_DESIGN_SOURCE/4_Pi_Unit_2U/STEP_for_Onshape/Rack_Faceplate_Left.step
04_DESIGN_SOURCE/6_Brick_Cradle_plate13+DC-notch_faceplate/checks/rack_step_DC-notch/Rack_Faceplate_Right.step
04_DESIGN_SOURCE/6_Brick_Cradle_plate13+DC-notch_faceplate/STEP_for_Onshape/Brick_Spacer_2mm.step
04_DESIGN_SOURCE/6_Brick_Cradle_plate13+DC-notch_faceplate/STL_for_printing/Brick_Spacer_4mm.stl
05_PLATES_250x250_BED/oriented_stls/SlimCargo_CapHalf.stl
ROBU_UPLOAD_SLIM_CARGO/01_NEW_AND_REPLACED_PARTS/03_[QTY_2]_[PETG_Black_25%]_SlimCargo_SideModule_1U_Top.stl
ROBU_UPLOAD_SLIM_CARGO/02_ALL_PARTS_FRESH_ORDER/04_[QTY_2]_[PETG_Black_20%]_SlimCargo_CapHalf.stl
04_DESIGN_SOURCE/10_Slim_Cargo_Rack_140mm/STEP_for_Onshape/SlimCargo_SideModule_3U_x4.step
01_PRINT_FILES/1_PRINT-NOW/12_Brick_Spacer_8mm__x1__PETG.stl
01_PRINT_FILES/1_PRINT-NOW/P1S_plates/Plate01.3mf
01_PRINT_FILES/1_PRINT-NOW/P1S_plates/Plate03.3mf
01_PRINT_FILES/1_PRINT-NOW/P1S_plates/Plate07.3mf
01_PRINT_FILES/1_PRINT-NOW/P1S_plates/Plate13.3mf
01_PRINT_FILES/5_SLIM_CARGO_140mm_TRAVEL_PROTOTYPE/P1S_plates/SlimPlate06.3mf
01_PRINT_FILES/ALT_UCG_1U_OLED_BLANK_PANEL/UCG_Alt_1U_Blank_OLED_Faceplate.stl
01_PRINT_FILES/ALT_UCG_1U_OLED_BLANK_PANEL/UCG_Alt_1U_OLED_Retention_Clamp.stl
02_RENDERS/Pi5_MiniRack_FINAL_studio.blend
02_RENDERS/SLIM_CARGO_PROTOTYPE/Slim_Cargo_Rack_studio.blend
04_DESIGN_SOURCE/10_Slim_Cargo_Rack_140mm/STEP_for_Onshape/SlimCargo_LowProfile_Handle_x2.step
04_DESIGN_SOURCE/10_Slim_Cargo_Rack_140mm/STL_for_printing/in_rack_coords/bar_0.stl
04_DESIGN_SOURCE/10_Slim_Cargo_Rack_140mm/STL_for_printing/in_rack_coords/bar_2.stl
04_DESIGN_SOURCE/10_Slim_Cargo_Rack_140mm/STL_for_printing/in_rack_coords/handle_L.stl
04_DESIGN_SOURCE/10_Slim_Cargo_Rack_140mm/STL_for_printing/in_rack_coords/handle_R.stl
04_DESIGN_SOURCE/10_Slim_Cargo_Rack_140mm/STL_for_printing/in_rack_coords/side_0_2U_L.stl
04_DESIGN_SOURCE/10_Slim_Cargo_Rack_140mm/STL_for_printing/in_rack_coords/side_0_2U_R.stl
04_DESIGN_SOURCE/10_Slim_Cargo_Rack_140mm/STL_for_printing/in_rack_coords/side_1_3U_R.stl
04_DESIGN_SOURCE/10_Slim_Cargo_Rack_140mm/STL_for_printing/in_rack_coords/side_2_3U_L.stl
04_DESIGN_SOURCE/10_Slim_Cargo_Rack_140mm/STL_for_printing/in_rack_coords/side_3_1U_L.stl
04_DESIGN_SOURCE/10_Slim_Cargo_Rack_140mm/STL_for_printing/in_rack_coords/side_3_1U_R.stl
04_DESIGN_SOURCE/1_Rack_9U_T0-look/STEP_for_Onshape/Rack_SideModule_2U_Base_x2.step
04_DESIGN_SOURCE/2_B1_Dock_3U/_old_v4_2026-10-27/B1_Spacer_5mm_x2.step
04_DESIGN_SOURCE/2_B1_Dock_3U/_old_v4_2026-10-27/B1_Spacer_5mm_x2.stl
04_DESIGN_SOURCE/4_Pi_Unit_2U/Component_Models/EVM_512GB_M2_2230_NVMe.step
04_DESIGN_SOURCE/4_Pi_Unit_2U/Component_Models/OLD_Waveshare_Adapter_F_guessed.step
04_DESIGN_SOURCE/4_Pi_Unit_2U/Component_Models/Waveshare_Adapter_F_v3position.step
04_DESIGN_SOURCE/4_Pi_Unit_2U/STEP_for_Onshape/Pi5_UPS_v3_board_tray_HDMIexit.step
04_DESIGN_SOURCE/4_Pi_Unit_2U/STEP_for_Onshape/Pi5_UPS_v3_ups_tray_pinned.step
04_DESIGN_SOURCE/4_Pi_Unit_2U/STEP_for_Onshape/Rack_Faceplate_Right.step
04_DESIGN_SOURCE/4_Pi_Unit_2U/STL_for_printing/Pi5_UPS_v3_shims.stl
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
