S-k404/pi5-homelab-rack/01_PRINT_FILES/5_SLIM_CARGO_140mm_TRAVEL_PROTOTYPE/P1S_plates/SlimPlate03_SETTINGS.txt

SlimPlate03 (PETG): 3U module + 2 handles (insert test)
=======================================================
Status: ALTERNATIVE rack. Print the Slim plates 01S-07S INSTEAD of Plate01-07 of the standard rack, not as well.
It's not in the Robu order. The 12 V brick cradle (plate 13) does not fit this rack: see ../README.md.
Material: PETG, about 183 g  (the Slim README lists PETG / ABS / ASA; ABS / ASA need the enclosure closed too)

How: double-click the .3mf (or File > Open Project in Bambu Studio). Every part is already placed.
If Bambu Studio asks, choose to load the geometry only. Then pick the settings below and Slice.

Settings (Bambu P1S): 0.20mm Standard @BBL P1S, Generic PETG, 4 walls, 25% gyroid, supports OFF (see Notes),
Textured PEI no glue, enclosure CLOSED.

Notes:
  Supports OFF: the joint bosses and key slots have small overhangs, the same as the standard rack's modules
  (Slim check: 03_CHECKS/VERIFICATION_slim-cargo_plates_28Oct.txt). If a boss looks ragged, turn on tree supports
  for that plate only.
  Handles: right-click each > Wall loops 5, Sparse infill 35%.
  This is the Slim rack's insert-test plate (like Plate03 of the standard rack): when it's done, heat-set one M5 insert
  into a rail hole and one into a joint boss (6.4 mm x 10 mm deep). Loose or bulging: stop, the hole size needs changing.

On this plate:
  - Handle x2   (SlimCargo_LowProfile_Handle_x2.stl)
  - Side 3U x1   (SlimCargo_SideModule_3U_x4.stl)
Hardware for the whole rack: 48 x M5 x 12 button head + 48 M5 heat-set inserts (the same as the standard rack).
