S-k404/pi5-homelab-rack/01_PRINT_FILES/1_PRINT-NOW/P1S_plates/Plate10_SETTINGS.txt

Plate 10 (PETG): Pi shelf
=========================
Status: print now
Material: PETG black, about 96 g

Settings (Bambu P1S): 0.20mm Standard @BBL P1S, Generic PETG, 3 walls, 20% gyroid, supports OFF,
Textured PEI no glue, enclosure CLOSED.

On this plate:
  - Rack_Shelf_pinned x1   (../10_Pi_Rack_Shelf_pinned__x1__PETG.stl)
Hardware: 6 x M3 heat-set inserts (dia 4 hole) in its two front posts, for the faceplate screws.
28 Oct: the right post's gusset has a 9 x 7 mm arch at its foot for the brick's 12 V lead (no supports needed: 3 mm round top).
