S-k404/pi5-homelab-rack/01_PRINT_FILES/1_PRINT-NOW/P1S_plates/Plate01_SETTINGS.txt

01_PLA_side-modules-2U-base
===========================
Status: print now
Material: PLA, about 186 g

How: double-click the .3mf (or File > Open Project in Bambu Studio). Every part is already placed.
If Bambu Studio asks, choose to load the geometry only. Then pick the settings below and Slice.
(The loose STLs are here too, in case you'd rather import them yourself.)

Settings:
  - Bambu Studio profile: 0.24mm Draft @BBL P1S
  - Filament: Generic PLA
  - Wall loops: 3 (default is 2)
  - Sparse infill: 15% gyroid
  - Supports: OFF
  - Plate: Textured PEI
  - Enclosure: top lid or front door OPEN (PLA heat-creeps in a closed P1S)

On this plate:
  - Side 2U base x2   (Rack_SideModule_2U_Base_x2.stl)
