S-k404/pi5-homelab-rack/_Old_versions/2026-10-28_retired/PRINT_THIS/_superseded_and_alternatives/BROKEN_antigravity-faceplate+switch-extender_2026-10-28/README.txt

DON'T PRINT these (moved here 28 Oct 2026). They came from the "Antigravity v7.3 final" and don't work:
- Rack_Faceplate_2U_10in_final (+ Left/Right): its switch window is on the front, but the Cuzor UPS switch faces the
  rack REAR; behind the window is the UPS tray's solid wall. Its "hidden cable slit" cut only a 9 x 7 mm groove (the
  rest fell inside the existing DC-IN window). And it lost the notch plate 13's 12 V brick lead needs.
- UPS_Switch_Extender / plate 14: there's no switch for it to reach.
Use the DC-notch faceplate instead (checked, 42 + 38 PASS). Full audit:
  FINAL_PRINTS_2026-10-28/checks/AUDIT_antigravity-faceplate_why-it-was-dropped.txt (project root)

Also moved here: 11B_files/ (the 11B folder's copy of the broken faceplate and its old Plate11B.3mf; Plate11B now uses the DC-notch faceplate).
