S-k404/pi5-homelab-rack/_Old_versions/2026-10-28_retired/FINAL_PRINT_STLs_ONLY_antigravity_DO-NOT-PRINT/00_DO_NOT_PRINT_README.txt

DO NOT PRINT FROM THIS FOLDER (28 Oct 2026).
This is the Antigravity STL list. Wrong for your build:
- 15_..._Faceplate_..._final and 21A/21B: broken faceplate (switch window where there is no switch; brick-lead notch missing)
- 22_..._UPS_Switch_Extender: nothing for it to reach
- 17_..._UCG_Ultra_1U_Shelf: plate 12; you chose the 12-ALT2 Printables mount
- 16_..._Shims: not used with the F holder
Your print list is FINAL_PRINTS_2026-10-28/ in the project root.
