S-k404/pi5-homelab-rack/_Old_versions/2026-10-28_retired/PRINT_THIS/_superseded_and_alternatives/BROKEN_antigravity-faceplate+switch-extender_2026-10-28/11_files/SETTINGS.txt

11_PETG_Pi-board-tray+lid+faceplate (v7.3 Antigravity Final)
======================================================================
Status: print now (brim OFF: faceplate is 254 of 256 mm bed width)

Recommended file to print:
  - Plate11.3mf (or Plate11_FINAL_hidden-slit_switch.3mf)
    Contains all 4 parts for the Pi unit:
      1. Board tray (Pi5_UPS_v3_board_tray_HDMIexit.stl)
      2. Lid (Pi5_UPS_v3_lid.stl)
      3. Faceplate with hidden cable slit & switch access (Rack_Faceplate_2U_10in_final.stl)
         - Hidden cable slit: vertical channel on inside face (front stays solid) so the cable
           from UPS OUT to Waveshare board is 100% hidden from the front!
         - Switch access opening: allows direct finger access to the Cuzor UPS switch.
      4. UPS Switch Extender (UPS_Switch_Extender.stl): snaps onto the UPS switch nub to provide
         a front-panel sliding toggle button! (Can also be printed alone in accent color on Plate 14)

Split version for smaller beds (220 x 220 mm):
  - Rack_Faceplate_Left_final.stl
  - Rack_Faceplate_Right_final.stl

Archived previous iterations:
  - Earlier versions (external DC notch, plain faceplate) are preserved in:
    _superseded_and_alternatives/plate11_superseded/

Bed Settings (Bambu P1S):
  - Profile: 0.20mm Standard @BBL P1S
  - Filament: Generic PETG (black / dark grey)
  - Wall loops: 3
  - Sparse infill: 20% gyroid
  - Supports: OFF
  - Plate: Textured PEI, no glue
  - Enclosure: CLOSED
  - Brim: OFF (faceplate is 254 mm on a 256 mm bed)
