S-k404/pi5-homelab-rack/01_PRINT_FILES/1_PRINT-NOW/P1S_plates/Plate10_layout.png

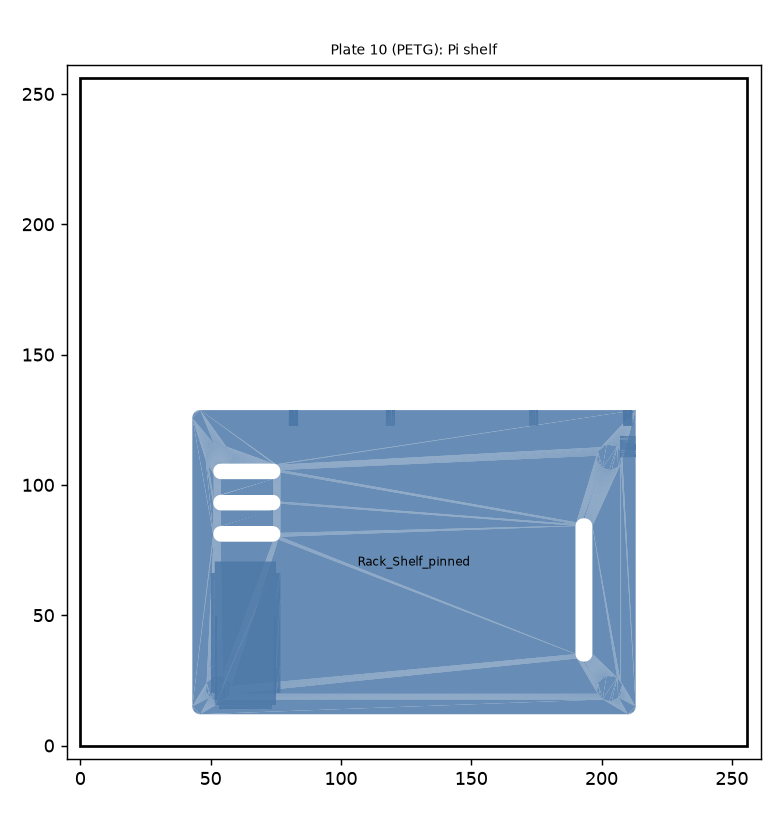
01_PRINT_FILES/1_PRINT-NOW/P1S_plates/Plate10_layout.png
