S-k404/pi5-homelab-rack/01_PRINT_FILES/2_CHECK-UPS-FIRST/P1S_plates/Plate11_CHECK-UPS_layout.png

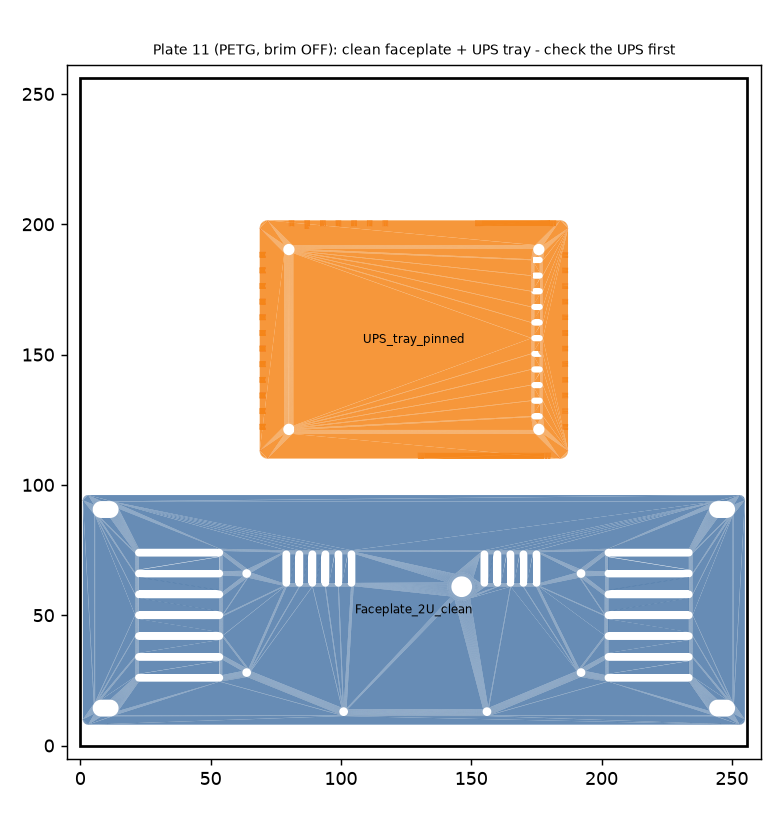
01_PRINT_FILES/2_CHECK-UPS-FIRST/P1S_plates/Plate11_CHECK-UPS_layout.png
