S-k404/pi5-homelab-rack/01_PRINT_FILES/3_WAIT/P1S_plates/Plate09_layout.png

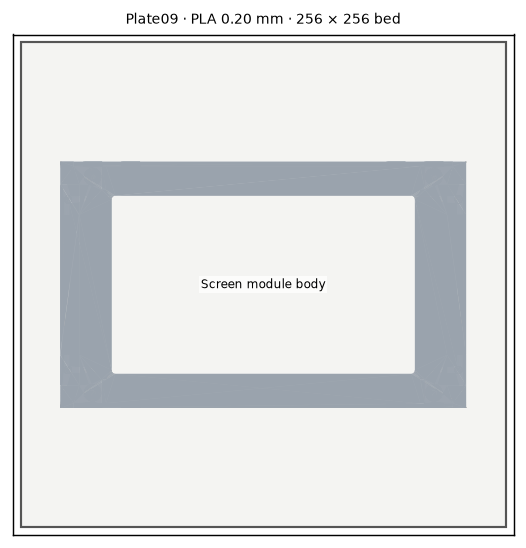
01_PRINT_FILES/3_WAIT/P1S_plates/Plate09_layout.png
