S-k404/pi5-homelab-rack/01_PRINT_FILES/3_WAIT/P1S_plates/Plate11W_WAIT_layout.png

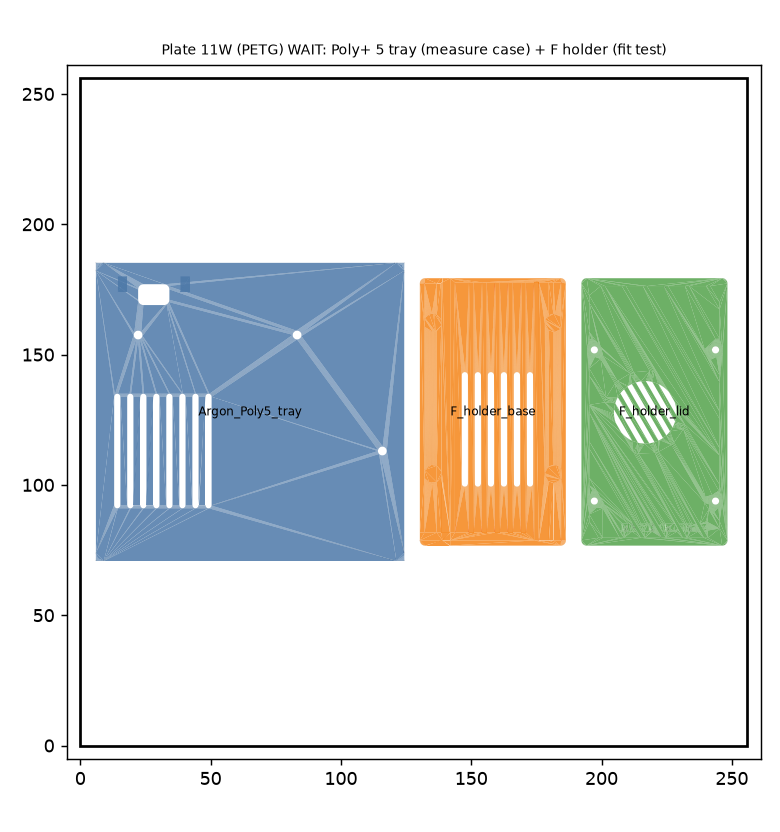
01_PRINT_FILES/3_WAIT/P1S_plates/Plate11W_WAIT_layout.png
