S-k404/pi5-homelab-rack/02_RENDERS/17_rack_wiring_side_open.png

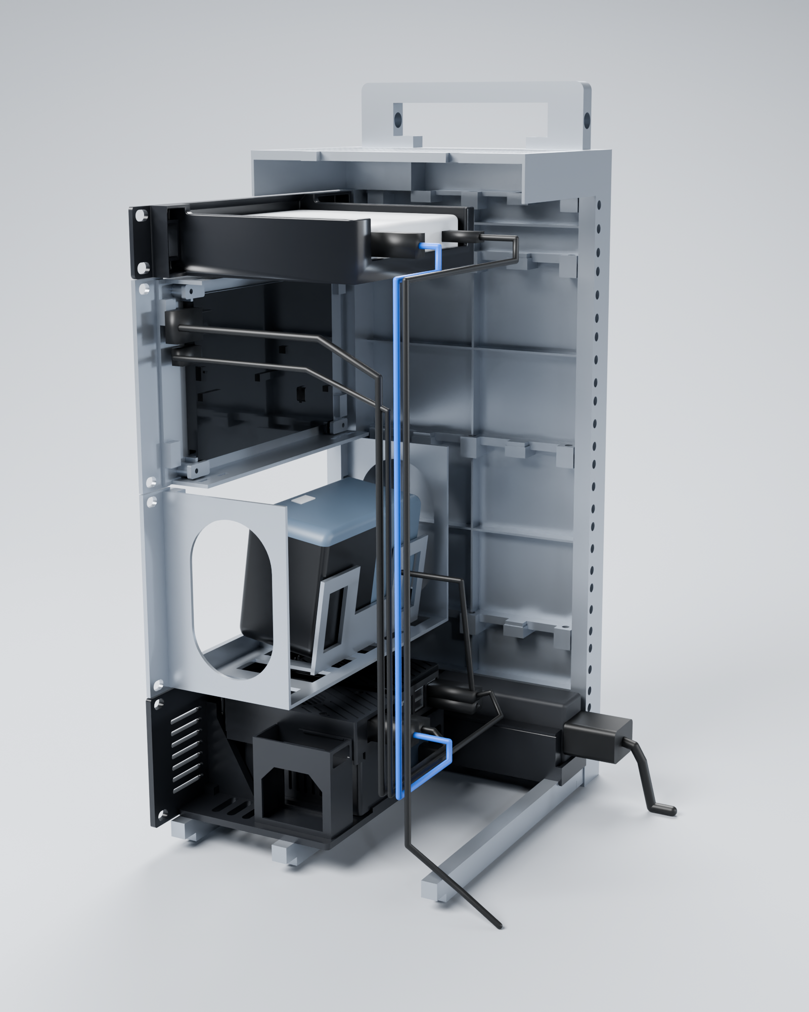
02_RENDERS/17_rack_wiring_side_open.png
