S-k404/pi5-homelab-rack/02_RENDERS/18_rack_wiring_rear.png

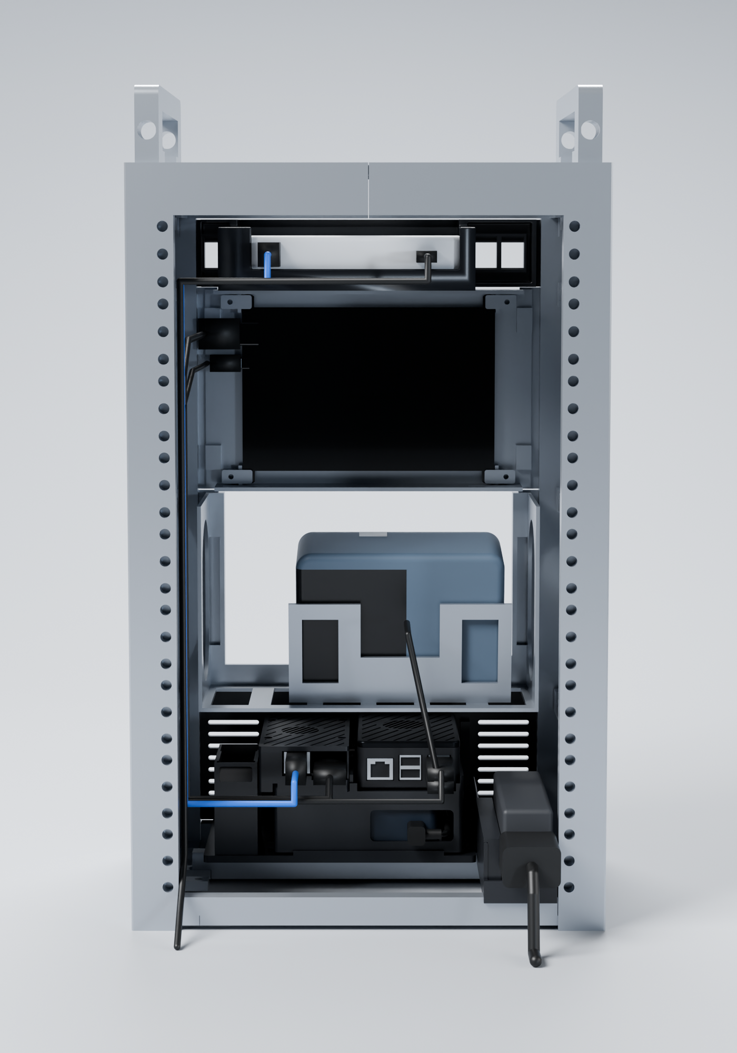
02_RENDERS/18_rack_wiring_rear.png
