S-k404/pi5-homelab-rack/02_RENDERS/Pi5_MiniRack_Exploded_Assembly.gif

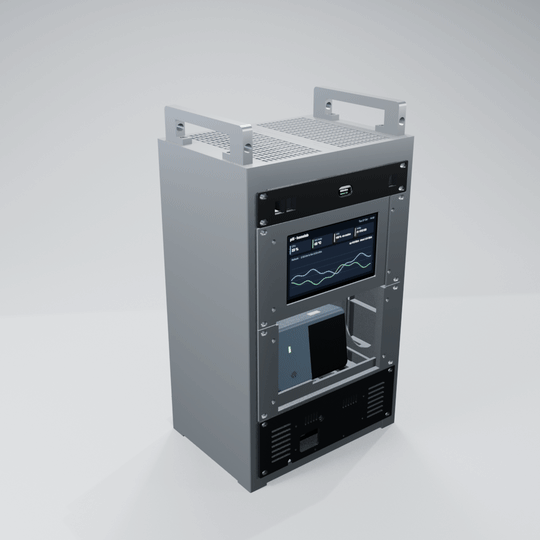
02_RENDERS/Pi5_MiniRack_Exploded_Assembly.gif
