S-k404/pi5-homelab-rack/03_CHECKS/MEASUREMENTS_every_part.md

# Every print file, measured from the STL in this folder (28 Oct 2026)

≈ g = slicer-like estimate (0.2 mm layers; rack/dock/screen PLA 3 walls 15 %, handles 4 walls 20 %, clips 30 %, PETG parts 3 walls 20 %, UCG mount 15 %). 'md5 = checked source' means the file is byte-identical to the one the checks ran on.

| File | Status | Qty | Mat | Measured size on the bed (mm) | Solid | ≈ g each | Bed fit | md5 = checked source |
|---|---|---|---|---|---|---|---|---|
| `01_Rack_SideModule_2U_Base__x2__PLA.stl` | print / order now | 2 | PLA | 200.0 × 108.9 × 40.0 | 1 body, watertight | 93 | yes | yes |
| `02_Rack_SideModule_3U__x4__PLA.stl` | print / order now | 4 | PLA | 200.0 × 136.4 × 28.0 | 1 body, watertight | 104 | yes | yes |
| `03_Rack_SideModule_1U_Top__x2__PLA.stl` | print / order now | 2 | PLA | 200.0 × 47.5 × 28.0 | 1 body, watertight | 50 | yes | yes |
| `04_Rack_CapHalf__x2__PLA.stl` | print / order now | 2 | PLA | 147.8 × 200.0 × 30.0 | 1 body, watertight | 96 | yes | yes |
| `05_Rack_Handle__x2__PLA.stl` | print / order now | 2 | PLA | 172.0 × 45.0 × 14.0 | 1 body, watertight | 36 | yes | yes |
| `06_Rack_BaseBar__x3__PLA.stl` | print / order now | 3 | PLA | 165.7 × 165.7 × 11.0 | 1 body, watertight | 21 | yes | yes |
| `07_Unit_Ear_3U__x4__PLA.stl` | print / order now | 4 | PLA | 28.0 × 132.6 × 3.0 | 1 body, watertight | 10 | yes | yes |
| `08_Display7C_Clip__x4__PLA.stl` | print / order now | 4 | PLA | 20.0 × 9.0 × 3.0 | 1 body, watertight | 1 | yes | yes |
| `09_B1_Dock_v5_Body__x1__PLA.stl` | print / order now | 1 | PLA | 214.0 × 95.0 × 130.0 | 1 body, watertight | 120 | yes | yes |
| `10_Pi_Rack_Shelf_pinned__x1__PETG.stl` | print / order now | 1 | PETG | 170.1 × 116.7 × 68.0 | 1 body, watertight | 96 | yes | yes |
| `11_Brick_Cradle_12V__x1__PETG.stl` | print / order now | 1 | PETG | 43.3 × 187.4 × 35.4 | 1 body, watertight | 63 | yes | yes |
| `12_Brick_Spacer_8mm__x1__PETG.stl` | print / order now | 1 | PETG | 110.0 × 31.6 × 10.4 | 1 body, watertight | 17 | yes | yes |
| `13_UCG-Ultra_1U_Mount_Printables-942972__x1__PETG.stl` | print / order now | 1 | PETG | 254.0 × 43.7 × 136.0 | 1 body, watertight | 117 | yes | yes |
| `C1_Pi_UPS_Tray_pinned__x1__PETG__CHECK-UPS-jacks.stl` | check the UPS first | 1 | PETG | 118.3 × 91.4 × 36.5 | 1 body, watertight | 62 | yes | yes |
| `C2_Pi_Faceplate_2U_clean__x1__PETG.stl` | check the UPS first | 1 | PETG | 254.0 × 88.1 × 4.0 | 1 body, watertight | 67 | yes | yes |
| `W1_Argon_Poly5_Tray__x1__PETG__WAIT-measure-case.stl` | wait | 1 | PETG | 118.3 × 114.4 × 12.4 | 1 body, watertight | 43 | yes | yes |
| `W2_Waveshare_F_Holder_Base__x1__PETG__WAIT-fit-test.stl` | wait | 1 | PETG | 56.0 × 102.6 × 25.8 | 1 body, watertight | 35 | yes | yes |
| `W3_Waveshare_F_Holder_Lid__x1__PETG__WAIT-fit-test.stl` | wait | 1 | PETG | 56.0 × 102.6 × 17.3 | 1 body, watertight | 17 | yes | yes |
| `W4_Display7C_3U_Body__x1__PLA__WAIT-screen-4Nov.stl` | wait | 1 | PLA | 214.0 × 130.0 × 30.0 | 1 body, watertight | 71 | yes | yes |
| `O1_Brick_Spacer_6mm__x1__PETG__only-if-brick-30.5-32.5mm.stl` | optional | 1 | PETG | 110.0 × 31.6 × 8.4 | 1 body, watertight | 14 | yes | yes |
| `O2_Brick_Spacer_4mm__x1__PETG__only-if-brick-32.5-34.5mm.stl` | optional | 1 | PETG | 110.0 × 31.6 × 6.4 | 1 body, watertight | 12 | yes | yes |
| `O3_Brick_Spacer_2mm__x1__PETG__only-if-brick-34.5-36.5mm.stl` | optional | 1 | PETG | 110.0 × 31.6 × 4.4 | 1 body, watertight | 10 | yes | yes |

| Totals | PLA ≈ g | PETG ≈ g |
|---|---|---|
| print / order now | 1189 | 292 |
| check the UPS first | 0 | 129 |
| wait | 71 | 95 |
| optional | 0 | 36 |
