S-k404/pi5-homelab-rack/03_CHECKS/VERIFICATION_waveshare_F_holder_26PASS.txt

Waveshare adapter (F) holder: base + lid, PETG black — checks
Calculations on the CAD models, not a physical test. Frame = v3 frame (y- = rack rear, z up).
Adapter geometry: Waveshare's dimension drawing (PCB, holes, port centres). Component heights/positions other than
the RJ45 (13.5) and HDMI-A (6.0) are ESTIMATES read off the drawing image; see the note at the end.

PASS  base: one valid solid
PASS  lid: one valid solid
INFO  outline  (x -11.25..44.75 (56.0), y -4.60..98.00 (102.6), z 36.9..65.7 (28.8))
PASS  adapter, its connectors and plugs don't hit the base or the lid  (overlap base 0.00 mm3, lid 0.00 mm3)
PASS  PCB sits 0.35 mm inside the walls all round  (left 0.35, right 0.35; jack faces 0.45 from the rear wall; terminal block 0.55 from the front wall)
PASS  4 posts carry the PCB at the drawing's hole pattern (58.00 x 46.50), 2.1 mm pilots for self-tapping M2.5  (PCB underside z 46.6, post/pilot depth 8 mm)
PASS  RJ45 and HDMI-A jacks sit centred in their rear notches, >= 0.9 mm each side  (RJ45 1.20, HDMI 1.00; notches 18.4 and 18.6 wide, open to the lid)
PASS  RJ45 plug + boot (14 x 15) pushed fully home clears the holder's rear wall and lid  (0.0 mm3; jack faces y -2.15, holder rear y -4.60)
PASS  HDMI plug moulding (22 x 12) pushed fully home clears the holder's rear wall and lid  (0.0 mm3; jack faces y -2.15, holder rear y -4.60)
PASS  plug window in the right wall covers the SH1.0, micro-HDMI and USB-C plugs  (window y 28..79; plugs at y 33.2, 58.1, 72.4; sill z 44.8)
PASS  12 V terminal: both wire entries (they face the front) line up with the front notch  (entries at x 31.3 and 38.2, notch x 28..42 (>= 2 mm each side); block ends 0.55 mm from the front wall)
PASS  no collision with the Argon Poly+5 tray (rims, stubs, fences, tie anchors)  (base 0.00, lid 0.00 mm3)
PASS  no collision with the shelf incl. the UGREEN HDMI tower  (base 0.00, lid 0.00 mm3)
PASS  no collision with the UPS tray  (base 0.00, lid 0.00 mm3)
PASS  no collision with the faceplate  (base 0.00, lid 0.00 mm3)
PASS  clearance to the shelf and the UGREEN HDMI tower  (0.95 mm (the tower's right face is at x -12.2))
PASS  straddles the tray's left rim and rear rim in two relief slots (0.4 mm clearance each side)  (rim x -2.2..0.0 in slot -2.6..0.4; rear rim y -2.2..0.0 in slot -2.6..0.4)
INFO  closest approach to any tray feature (the floor is a contact, so this is 0)  (0.00 mm)
PASS  right wall clears the tray's left stubs (x 45.2..47.4)  (0.45 mm)
PASS  plinth ribs stand between the tray's floor vents; deck slots line up with them (UPS plenum air can rise through)  (6 slots, 2.4 x 44 mm each, at x [6, 11, 16, 21, 26, 31])
PASS  holder doesn't touch the Argon Poly+5, nominal 93.5 x 64.0  (overlap 0.00 mm3; wall-to-wall gap 5.15 mm)
INFO  adapter plug tips vs the case's side wall, nominal 93.5 x 64.0  (the 5.5 mm USB-C plug tip ends 1.20 mm short of the wall (a wall opening would be needed either way))
PASS  holder doesn't touch the Argon Poly+5, largest published 95.5 x 66.0  (overlap 0.00 mm3; wall-to-wall gap 3.15 mm)
INFO  adapter plug tips vs the case's side wall, largest published 95.5 x 66.0  (the 5.5 mm USB-C plug tip ends -0.80 mm INSIDE the wall (a wall opening would be needed either way))
INFO  the adapter's plugs and the Poly+5's side wall  (the plugs are 5.5 mm long and stop about 1.2 mm short of a nominal case wall, so they cannot plug into the Pi's ports through the wall. Adapter (F) talks to the Pi over its 16-pin FFC (NVMe + 2.5G); HDMI 0 and Type-C / terminal power need a different route (see README).)
PASS  top of the holder is under the B1 dock  (holder top z 65.7; Argon case top 67.9; B1 dock underside 81.3 (rack check) -> 15.6 mm of air)
PASS  front of the holder stays clear of the shelf's front posts and the faceplate  (holder front y 98.0; posts start y 104.5; faceplate rear y 112.5; tie anchors y 101..107 (z <= 41.4) are 0.9 mm under the deck)
PASS  Waveshare_F_holder_base.stl: watertight, flat on the bed, fits the 256 mm bed  (56.0 x 102.6 x 25.8 mm, first layer 2198 mm2, 11068 triangles)
PASS  Waveshare_F_holder_base.stl: no supports needed; widest unsupported flat patch is a short bridge  (widest bridge about 5.6 mm (limit 7))
PASS  Waveshare_F_holder_lid.stl: watertight, flat on the bed, fits the 256 mm bed  (56.0 x 102.6 x 17.3 mm, first layer 4581 mm2, 12766 triangles)
PASS  Waveshare_F_holder_lid.stl: no supports needed; widest unsupported flat patch is a short bridge  (widest bridge about 2.5 mm (limit 7))

INFO  PETG about 19 g for the base and 12 g for the lid at 20% infill (solid CAD volume 27.3 / 16.3 cm3)

26 PASS, 0 FAIL

NOT VERIFIED (needs the real parts in hand): tall components other than the RJ45 and HDMI-A, the exact M.2 / FFC / terminal
positions (taken from the drawing image), how the Poly+5's side wall is cut, and whether the FFC reaches the Pi's PCIe socket.
