S-k404/pi5-homelab-rack/_Old_versions/2026-10-28_retired/PRINT_THIS/_superseded_and_alternatives/alternatives_and_notes/checks/stl_measurements.txt

Each print STL measured directly (ext = size on the bed in mm, wt = watertight, bed = first-layer area, overhang = downward faces off the bed)

Rack_BaseBar_x3.stl                    ext=[165.75 165.75  11.  ] lo=[0. 0. 0.] wt=True wind=True bodies=1 vol=39.5cm3 bed=3654mm2 overhang=99mm2 tris=1036
Rack_CapHalf_x2.stl                    ext=[147.8 200.   30. ] lo=[ 0.  0. -0.] wt=True wind=True bodies=1 vol=84.6cm3 bed=18160mm2 overhang=190mm2 tris=8676
Rack_Handle_x2.stl                     ext=[172.  45.  14.] lo=[-0.  0. -0.] wt=True wind=True bodies=1 vol=54.0cm3 bed=4261mm2 overhang=550mm2 tris=3340
Rack_SideModule_1U_Top_x2.stl          ext=[200.    47.45  28.  ] lo=[0. 0. 0.] wt=True wind=True bodies=1 vol=61.1cm3 bed=8801mm2 overhang=754mm2 tris=6428
Rack_SideModule_2U_Base_x2.stl         ext=[200.  108.9  40. ] lo=[0. 0. 0.] wt=True wind=True bodies=1 vol=126.4cm3 bed=21142mm2 overhang=1280mm2 tris=11964
Rack_SideModule_3U_x4.stl              ext=[200.   136.35  28.  ] lo=[0. 0. 0.] wt=True wind=True bodies=1 vol=137.1cm3 bed=26403mm2 overhang=1618mm2 tris=12476
B1_Dock_3U_Body.stl                    ext=[214.  95. 130.] lo=[0. 0. 0.] wt=True wind=True bodies=1 vol=121.6cm3 bed=11762mm2 overhang=839mm2 tris=3788
B1_Dock_3U_Ear_x2.stl                  ext=[ 28.   132.55   3.  ] lo=[0. 0. 0.] wt=True wind=True bodies=1 vol=10.7cm3 bed=3532mm2 overhang=0mm2 tris=3320
B1_Spacer_5mm_x2.stl                   ext=[10.9 59.4 34. ] lo=[0. 0. 0.] wt=True wind=True bodies=1 vol=11.4cm3 bed=335mm2 overhang=0mm2 tris=28
Display7C_3U_Body.stl                  ext=[214. 130.  30.] lo=[0. 0. 0.] wt=True wind=True bodies=1 vol=63.8cm3 bed=12733mm2 overhang=252mm2 tris=6912
Display7C_Clip_x4.stl                  ext=[20.  9.  3.] lo=[0. 0. 0.] wt=True wind=True bodies=1 vol=0.5cm3 bed=169mm2 overhang=0mm2 tris=1032
Pi5_UPS_v3_board_tray_HDMIexit.stl     ext=[118.3 114.4  28.9] lo=[0. 0. 0.] wt=True wind=True bodies=1 vol=54.0cm3 bed=11857mm2 overhang=562mm2 tris=25630
Pi5_UPS_v3_lid.stl                     ext=[118.3 114.4   6.4] lo=[ 0.  0. -0.] wt=True wind=True bodies=1 vol=24.7cm3 bed=10159mm2 overhang=26mm2 tris=13424
Pi5_UPS_v3_shims.stl                   ext=[37.2 27.2  2. ] lo=[-3.6 -3.6  0. ] wt=True wind=True bodies=12 vol=0.5cm3 bed=409mm2 overhang=0mm2 tris=12096
Pi5_UPS_v3_ups_tray_pinned.stl         ext=[118.3  91.4  36.5] lo=[0. 0. 0.] wt=True wind=True bodies=1 vol=48.4cm3 bed=10639mm2 overhang=377mm2 tris=35374
Rack_Faceplate_2U_10in.stl             ext=[254.   88.1   4. ] lo=[ 0.  0. -0.] wt=True wind=True bodies=1 vol=76.8cm3 bed=19170mm2 overhang=45mm2 tris=20544
Rack_Shelf_pinned.stl                  ext=[170.1 116.7  68. ] lo=[0. 0. 0.] wt=True wind=True bodies=1 vol=124.0cm3 bed=18749mm2 overhang=1977mm2 tris=12268
UCG_Ultra_1U_Shelf.stl                 ext=[210.47 210.47 137.2 ] lo=[0. 0. 0.] wt=True wind=True bodies=1 vol=78.6cm3 bed=7596mm2 overhang=397mm2 tris=13548
