S-k404/pi5-homelab-rack/04_DESIGN_SOURCE/7_Argon_Poly5_tray+Waveshare_F_holder/11A_PETG_Argon-NEO-5-tray+faceplate_WAIT-measure-case/Plate11A_layout.png

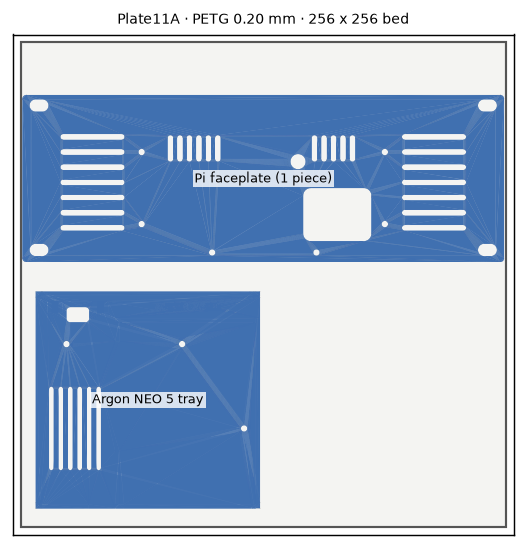
04_DESIGN_SOURCE/7_Argon_Poly5_tray+Waveshare_F_holder/11A_PETG_Argon-NEO-5-tray+faceplate_WAIT-measure-case/Plate11A_layout.png
