S-k404/pi5-homelab-rack/(commit log)

2026-10-28 Initial commit: Pi 5 HomeLab 9U mini rack build and CAD files
    [01_FRAME_PLA_SideModule_2U_Base_PRINT_QTY_2.stl, 01_RACK_BaseBar_x3.step, 01_RACK_CapHalf_x2.step, 01_RACK_Handle_x2.step, 01_RACK_SideModule_1U_Top_x2.step, 01_RACK_SideModule_2U_Base_x2.step, 01_RACK_SideModule_3U_x4.step, 01_Rack_SideModule_2U_Base__x2__PLA.stl]
2026-10-28 chore: add .gitignore for CAD binaries and renders
2026-10-28 docs: 28 Oct ultrareview - corrected docs, new checks, final to-do
    Review pass over the whole build (9U rack, B1 dock v5, screen module,
    Pi 5 + Argon Poly+ 5, 12 V brick cradle, UCG-Ultra mount).
    - FINAL_TODO/FINAL_TODO.md is now the single to-do list; START_HERE points to it
    - ULTRAREVIEW/: findings, before/ snapshots of changed text files, checks, scripts
    - new checks: all-cable wiring routes, Slim Cargo fit (brick cradle does not
    fit the 140 mm frame), Waveshare F holder 26-PASS
    - Slim Cargo docs and schematic script corrected: alternative frame, not part
    of the order; measured depths instead of typed-in ones
    - Robu cart re-totalled (Rs 14,564), PARTS_LIST re-priced from the carts
    -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
2026-10-28 build: regenerate print files and renders for the 28 Oct design
    - Pi shelf: arch in the right gusset for the 12 V lead
    - C2 faceplate is now the clean one (no DC-IN window / notch); old DC-notch STL removed
    - Waveshare F holder base: HDMI notch widened
    - Plates 10, 11, 11W 3MF + layout PNGs rebuilt
    - renders 01-16 and the sheet re-rendered; new 17/18 rear-wiring renders
    - Slim Cargo / rack schematics redrawn with measured depths
    - Onshape individual STEP parts for the shelf, holder and clean faceplate
    Binary-only commit (STL/STEP/3MF/PNG/blend); the matching text is in the
    previous commit.
    [06_PI5_Faceplate_2U_clean.step, 06_PI5_Rack_Shelf_pinned.step, 06_PI5_Waveshare_F_holder_base.step, 10_Pi_Rack_Shelf_pinned__x1__PETG.stl, C2_Pi_Faceplate_2U_DC-notch__x1__PETG__CHECK-UPS-jacks.stl, C2_Pi_Faceplate_2U_clean__x1__PETG.stl, Pi5_MiniRack_FINAL_studio.blend, Plate10.3mf]
2026-10-28 onshape: build script uses the clean faceplate; docs say the masters are current
    - build_onshape_project.py: assemblies use Rack_Faceplate_2U_10in_clean.step
    (part name Pi5_Faceplate_2U_clean); the individual-parts list ships the
    clean faceplate instead of the DC-notch one
    - ONSHAPE_PROJECT/README.md: masters regenerated 28 Oct; 50 solids (was 49);
    faceplate row updated
    - FINAL_TODO / ULTRAREVIEW README: Onshape regeneration and git commits marked done
2026-10-28 build: regenerate the Onshape master STEPs, compound and ZIP
    Rebuilt with build_onshape_project.py (CadQuery 2.8.0). They now contain the
    28 Oct Pi shelf (gusset arch), the clean faceplate and the adapter (F)
    holder base with the HDMI relief; the old DC-notch faceplate is gone from
    the assemblies and from INDIVIDUAL_STEP_PARTS and the ZIP.
    Checked by re-importing each file and matching the shelf, faceplate and
    holder base to the current STEPs by volume (1 match each, 0 for the old
    DC-notch faceplate). Root-folder copies are byte-identical to the ones in
    ONSHAPE_PROJECT.
    [06_PI5_Faceplate_2U_DC_notch.step, Pi5_HomeLab_9U_ALL_IN_ONE_COMBINED.step, Pi5_HomeLab_9U_COMBINED_FOR_ONSHAPE.step, Pi5_HomeLab_9U_Complete_ASSEMBLY.step, Pi5_HomeLab_9U_SingleBody_Compound_STUDIO.step, Pi5_HomeLab_9U_SlimCargo_Master.step, Pi5_HomeLab_9U_Standard_Master.step, SlimCargo_HomeLab_9U_Complete_ASSEMBLY.step]
2026-10-28 slim-cargo: print plates, overhang check and filament estimate; fix README claims
    - build_slim_plates.py: seven P1S plates (SlimPlate01-07) that replace Plate01-07
    of the standard rack; reads each 3MF back and checks bed fit, spacing and part
    counts (0 FAIL); overhang and filament report
    - Frame is ~1,193 g PETG (1,165 g PLA) + ~46 g shared ears/clips, +14% vs the
    standard frame at the Slim settings, -7% at equal settings
    - README said "no supports, all overhangs <= 45 deg": not true, ~1.5-2% of each
    module's surface (same joint bosses/key slots as the standard rack); corrected
    - README said 445 mm total height / 16 mm handle rise; the model is 458 mm with
    the plinth (440 mm to the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
2026-10-28 build: Slim Cargo plate 3MFs and layouts, corrected contact sheet
    SlimPlate01-07 .3mf and layout PNGs (binary-only; the SETTINGS text and the
    builder are in the previous commit) and SLIM_CARGO_SHEET.png with the corrected
    height and a caption that no longer claims fully internal cabling.
    [SlimPlate01.3mf, SlimPlate02.3mf, SlimPlate03.3mf, SlimPlate04.3mf, SlimPlate05.3mf, SlimPlate06.3mf, SlimPlate07.3mf]
2026-10-28 schematic, renders: fix schematic heights/labels and update Slim Cargo render script
2026-10-28 build: regenerate engineering schematic, Slim Cargo stills, sheet and turntable
    [Slim_Cargo_Rack_studio.blend]
2026-10-28 renders: fix Slim Cargo render materials and turntable camera/lighting orbiting
2026-10-28 build: update Slim Cargo stills, sheet, turntable animation, and blend with fixed materials and lighting
    [Slim_Cargo_Rack_studio.blend]
2026-11-01 build: add 10-plate 250x250 print suite, Robu Slim Cargo upload package, and Alt UCG 1U OLED files
    [01_[QTY_2]_[PETG_Black_25%]_SlimCargo_SideModule_2U_Base.step, 01_[QTY_2]_[PETG_Black_25%]_SlimCargo_SideModule_2U_Base.stl, 02_[QTY_4]_[PETG_Black_25%]_SlimCargo_SideModule_3U.step, 02_[QTY_4]_[PETG_Black_25%]_SlimCargo_SideModule_3U.stl, 03_[QTY_2]_[PETG_Black_25%]_SlimCargo_SideModule_1U_Top.step, 03_[QTY_2]_[PETG_Black_25%]_SlimCargo_SideModule_1U_Top.stl, 04_[QTY_2]_[PETG_Black_20%]_SlimCarg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]
2026-11-08 docs: add Waveshare F wall frame CAD generator and guide
2026-11-08 Rework wall frame F from the Pi 5 drawing and add measurement and clearance checks
